mtilocca/mppt-controller/hardware/erc_report.txt

ERC report (2026-11-07T15:33:20, Encoding UTF8)
Report includes: Errors, Warnings, Exclusions

***** Sheet /

***** Sheet /pv_input/

***** Sheet /mppt_stage/

***** Sheet /mppt_loop/

***** Sheet /battery/

***** Sheet /load_switch/

***** Sheet /inverter_feed/

***** Sheet /sensing/

***** Sheet /aux_power/

***** Sheet /mcu/

***** Sheet /flash/

***** Sheet /ethernet/

***** Sheet /can/

***** Sheet /rs485/

***** Sheet /usb_uart/

***** Sheet /display/

***** Sheet /leds/

 ** ERC messages: 0  Errors 0  Warnings 0

 ** Ignored checks:
    - Global label only appears once in the schematic
    - Four connection points are joined together
    - SPICE model issue
    - Assigned footprint doesn't match footprint filters
