mtilocca/mppt-controller/docs/03-pinmap.md

# 3. STM32H743ZIT6 pin map (LQFP-144)

Generated by `hardware/gen_pinmap_doc.py` from `hardware/pinmap.json` (made by `pinmap.py`). Every alternate function was matched against
ST's open pin data for STM32H743ZITx (`h743zit_af.json`); the generator asserts it again at build time. Not used: PA13/PA14 (SWD), PH0/PH1 (HSE), PC14/PC15 (LSE), PA11/PA12 (USB).

Active-low control nets (reset/boot state = pin high-Z with a pull-up = everything OFF): `MPPT_NEN`, `LOAD_NEN`, `INV_NEN`.

## QSPI

| Signal | Pin | LQFP-144 | Function |
|---|---|---|---|
| QSPI_CLK | PF10 | 22 | QUADSPI_CLK |
| QSPI_NCS | PG6 | 91 | QUADSPI_BK1_NCS |
| QSPI_IO0 | PF8 | 20 | QUADSPI_BK1_IO0 |
| QSPI_IO1 | PF9 | 21 | QUADSPI_BK1_IO1 |
| QSPI_IO2 | PE2 | 1 | QUADSPI_BK1_IO2 |
| QSPI_IO3 | PF6 | 18 | QUADSPI_BK1_IO3 |

## ETH

| Signal | Pin | LQFP-144 | Function |
|---|---|---|---|
| ETH_REF_CLK | PA1 | 35 | ETH_REF_CLK |
| ETH_MDIO | PA2 | 36 | ETH_MDIO |
| ETH_MDC | PC1 | 27 | ETH_MDC |
| ETH_CRS_DV | PA7 | 43 | ETH_CRS_DV |
| ETH_RXD0 | PC4 | 44 | ETH_RXD0 |
| ETH_RXD1 | PC5 | 45 | ETH_RXD1 |
| ETH_TX_EN | PG11 | 126 | ETH_TX_EN |
| ETH_TXD0 | PG13 | 128 | ETH_TXD0 |
| ETH_TXD1 | PG12 | 127 | ETH_TXD1 |
| ETH_NRST | PC9 | 99 | GPIO |

## USB

| Signal | Pin | LQFP-144 | Function |
|---|---|---|---|
| USB_DM | PA11 | 103 | USB_OTG_FS_DM |
| USB_DP | PA12 | 104 | USB_OTG_FS_DP |
| USB_VBUS | PE1 | 142 | GPIO |

## LCD

| Signal | Pin | LQFP-144 | Function |
|---|---|---|---|
| LCD_R3 | PB0 | 46 | LTDC_R3 |
| LCD_R4 | PA5 | 41 | LTDC_R4 |
| LCD_R5 | PC0 | 26 | LTDC_R5 |
| LCD_R6 | PB1 | 47 | LTDC_R6 |
| LCD_R7 | PE15 | 68 | LTDC_R7 |
| LCD_G2 | PA6 | 42 | LTDC_G2 |
| LCD_G3 | PE11 | 64 | LTDC_G3 |
| LCD_G4 | PB10 | 69 | LTDC_G4 |
| LCD_G5 | PB11 | 70 | LTDC_G5 |
| LCD_G6 | PC7 | 97 | LTDC_G6 |
| LCD_G7 | PD3 | 117 | LTDC_G7 |
| LCD_B3 | PD10 | 79 | LTDC_B3 |
| LCD_B4 | PE12 | 65 | LTDC_B4 |
| LCD_B5 | PA3 | 37 | LTDC_B5 |
| LCD_B6 | PB8 | 139 | LTDC_B6 |
| LCD_B7 | PB9 | 140 | LTDC_B7 |
| LCD_CLK | PE14 | 67 | LTDC_CLK |
| LCD_HSYNC | PC6 | 96 | LTDC_HSYNC |
| LCD_VSYNC | PA4 | 40 | LTDC_VSYNC |
| LCD_DE | PE13 | 66 | LTDC_DE |
| LCD_BL_PWM | PD15 | 86 | TIM4_CH4 |
| LCD_RST | PC8 | 98 | GPIO |

## CAN

| Signal | Pin | LQFP-144 | Function |
|---|---|---|---|
| CAN_TX | PD1 | 115 | FDCAN1_TX |
| CAN_RX | PD0 | 114 | FDCAN1_RX |

## RS485

| Signal | Pin | LQFP-144 | Function |
|---|---|---|---|
| RS485_TX | PG14 | 129 | USART6_TX |
| RS485_RX | PG9 | 124 | USART6_RX |
| RS485_DE | PG8 | 93 | USART6_DE |
| RS485_NRE | PA0 | 34 | GPIO |

## CON

| Signal | Pin | LQFP-144 | Function |
|---|---|---|---|
| CON_TX | PD8 | 77 | USART3_TX |
| CON_RX | PD9 | 78 | USART3_RX |

## I2C

| Signal | Pin | LQFP-144 | Function |
|---|---|---|---|
| I2C_SCL | PB6 | 136 | I2C1_SCL |
| I2C_SDA | PB7 | 137 | I2C1_SDA |

## SPI

| Signal | Pin | LQFP-144 | Function |
|---|---|---|---|
| SPI_SCK | PB13 | 74 | SPI2_SCK |
| SPI_MOSI | PB15 | 76 | SPI2_MOSI |
| SPI_MISO | PB14 | 75 | SPI2_MISO |
| SPI_CS | PB2 | 48 | GPIO |
| SPI_DC | PA10 | 102 | GPIO |
| SPI_RST | PA9 | 101 | GPIO |

## ADC

| Signal | Pin | LQFP-144 | Function |
|---|---|---|---|
| ADC_VPV | PF11 | 49 | ADC1_INP2 |
| ADC_VBAT | PF4 | 14 | ADC3_INP9 |
| ADC_VLOAD | PF5 | 15 | ADC3_INP4 |
| ADC_NTC_PWR | PF12 | 50 | ADC1_INP6 |
| ADC_NTC_BAT | PF3 | 13 | ADC3_INP5 |
| ADC_NTC_AUX | PF7 | 19 | ADC3_INP3 |

## CONTROL

| Signal | Pin | LQFP-144 | Function |
|---|---|---|---|
| LED1 | PE0 | 141 | GPIO |
| LED2 | PD14 | 85 | GPIO |
| LED3 | PD13 | 82 | GPIO |
| LED4 | PD12 | 81 | GPIO |
| MPPT_EN | PD11 | 80 | GPIO |
| MPPT_FLT | PD7 | 123 | GPIO |
| LOAD_EN | PD6 | 122 | GPIO |
| LOAD_PGD | PD5 | 119 | GPIO |
| INV_EN | PD4 | 118 | GPIO |
| INV_PGD | PD2 | 116 | GPIO |
| INV_REMOTE | PC12 | 113 | GPIO |
| INV_FAULT | PC11 | 112 | GPIO |
| INA_ALERT | PC10 | 111 | GPIO |
| FAN_PWM | PA8 | 100 | GPIO |

## TOUCH

| Signal | Pin | LQFP-144 | Function |
|---|---|---|---|
| TOUCH_INT | PB12 | 73 | GPIO |
| TOUCH_CS | PB5 | 135 | GPIO |
