mtilocca/mppt-controller/docs/img/board-3d-bottom.png

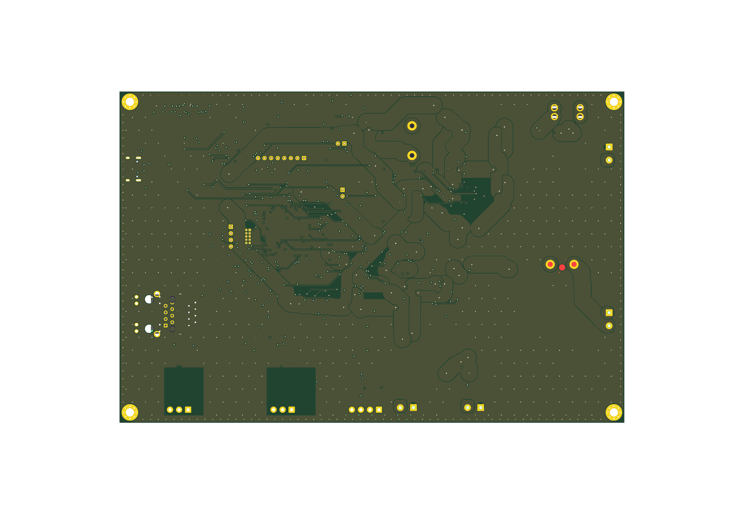
docs/img/board-3d-bottom.png
