mtilocca/mppt-controller/docs/img/board-in2.png

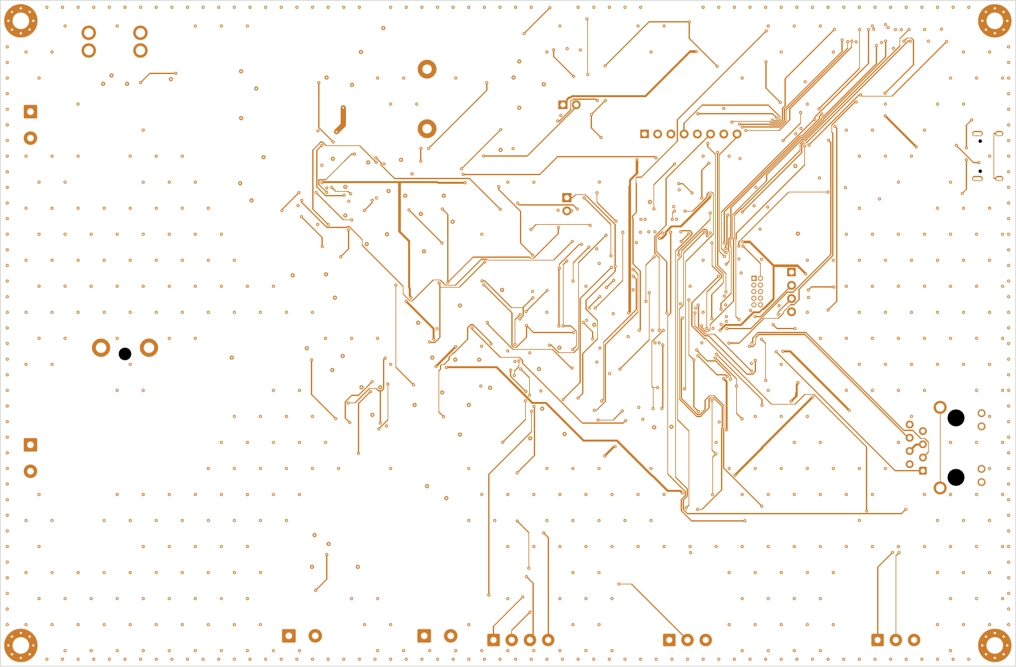
docs/img/board-in2.png
