mtilocca/mppt-controller/docs/img/sch-01.png

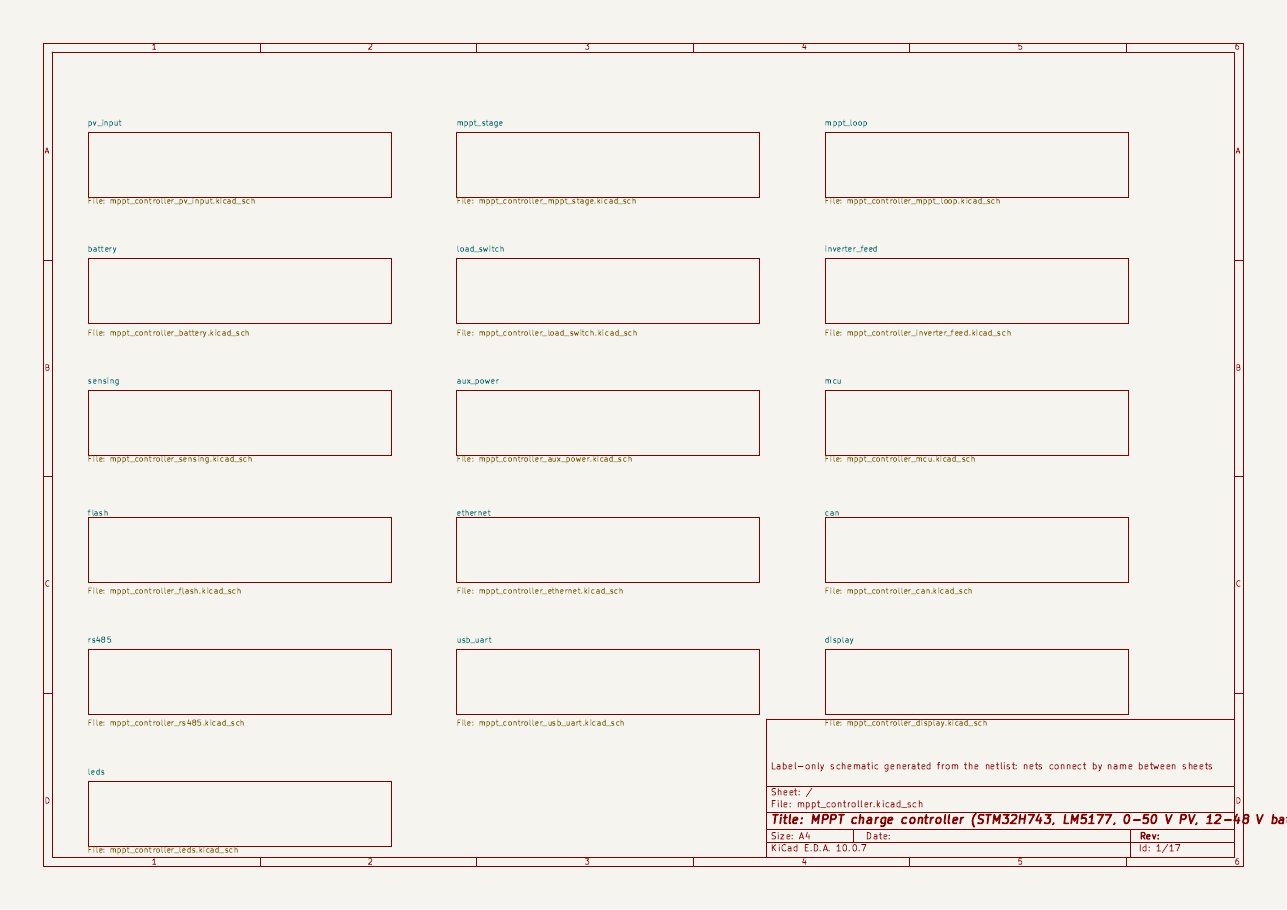
docs/img/sch-01.png
