mtilocca/mppt-controller/docs/img/sch-04.png

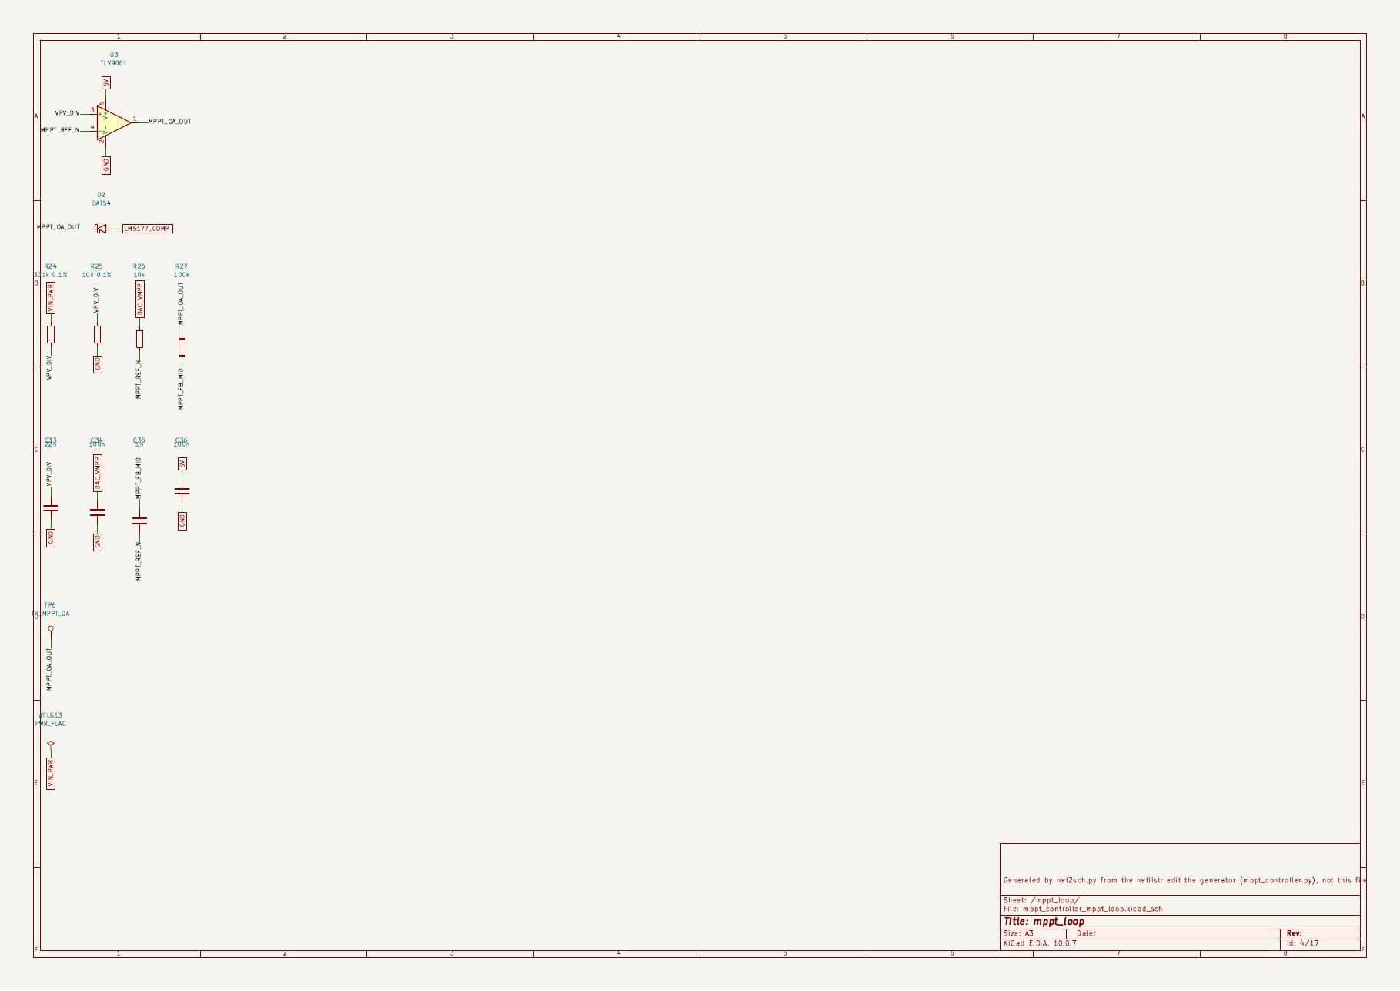
docs/img/sch-04.png
