mtilocca/mppt-controller/docs/img/sch-05.png

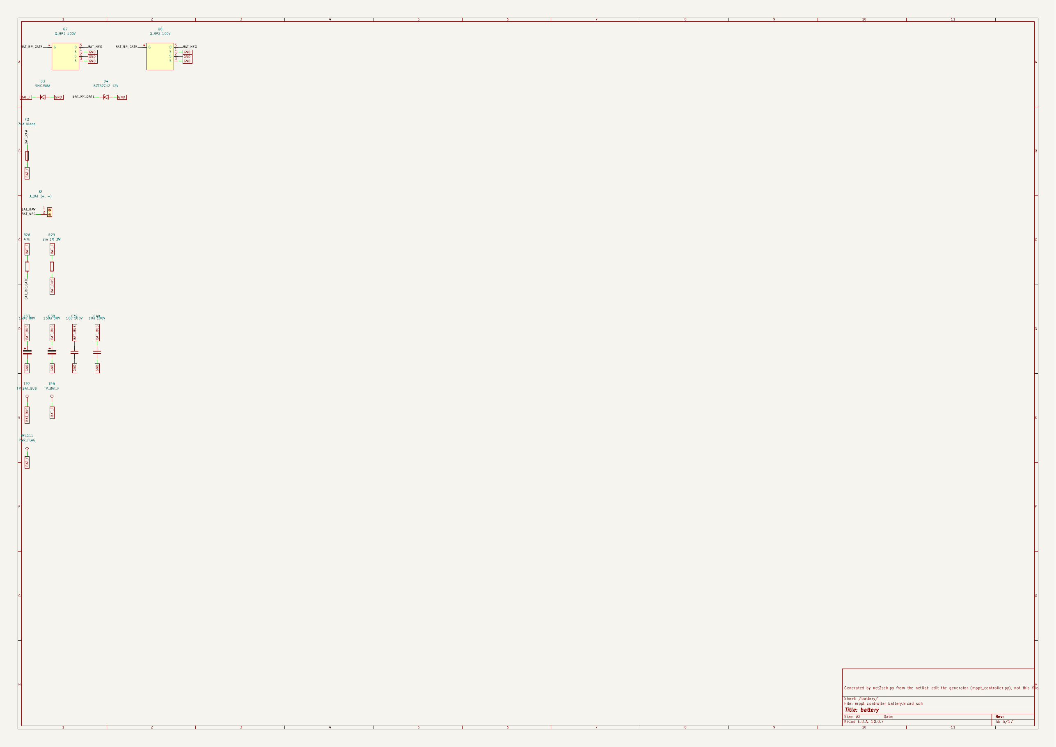
docs/img/sch-05.png
