mtilocca/mppt-controller/docs/img/sch-07.png

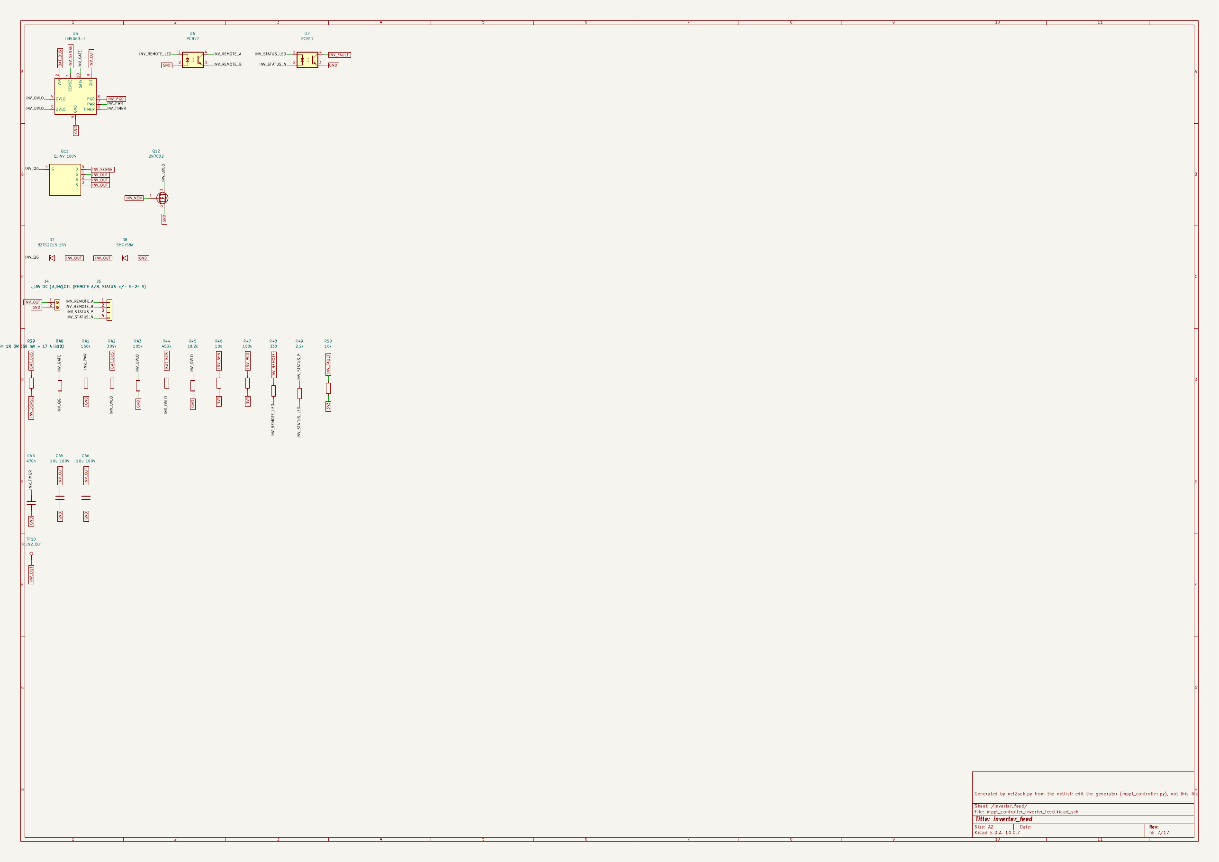
docs/img/sch-07.png
