mtilocca/mppt-controller/docs/img/sch-11.png

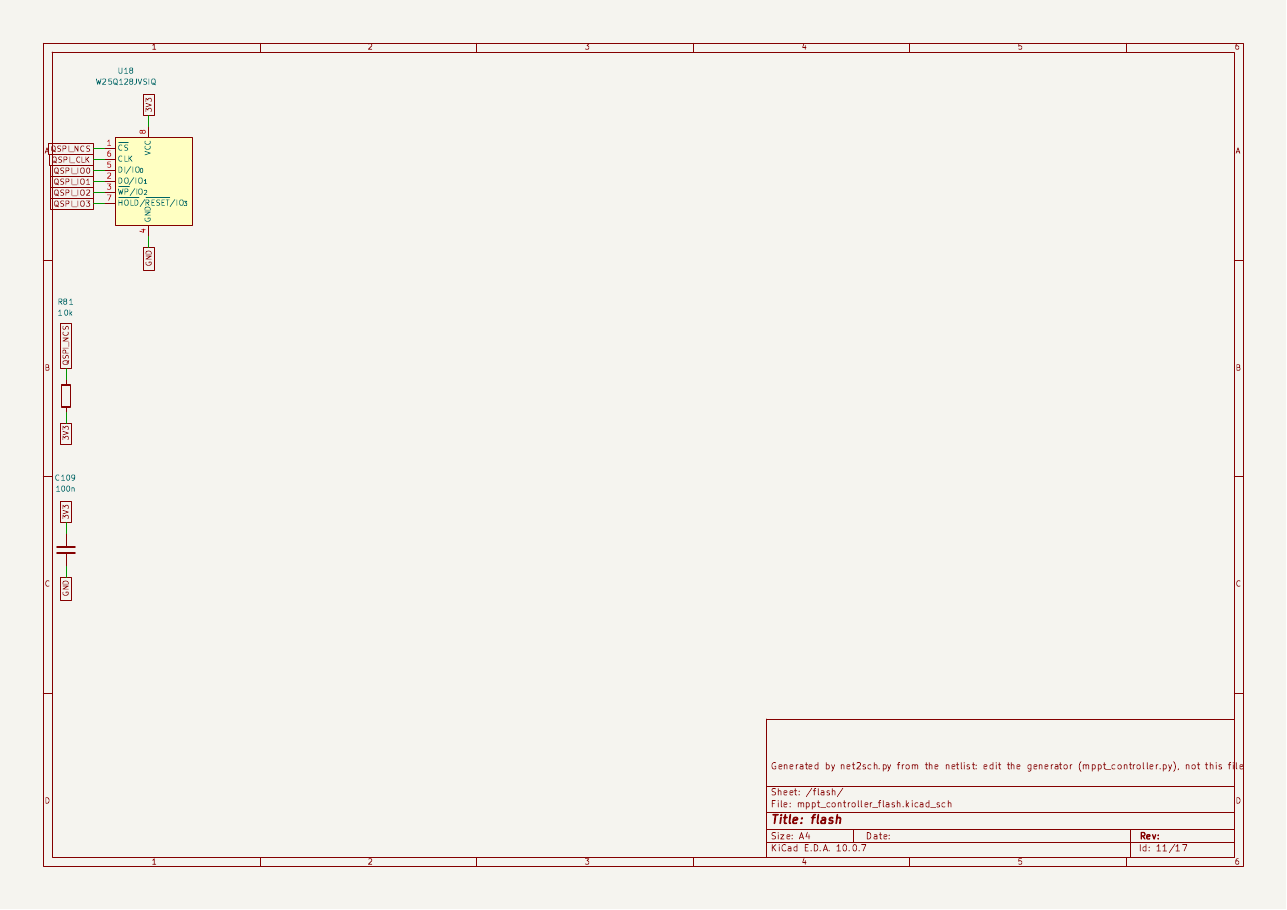
docs/img/sch-11.png
