mtilocca/mppt-controller/docs/img/sch-13.png

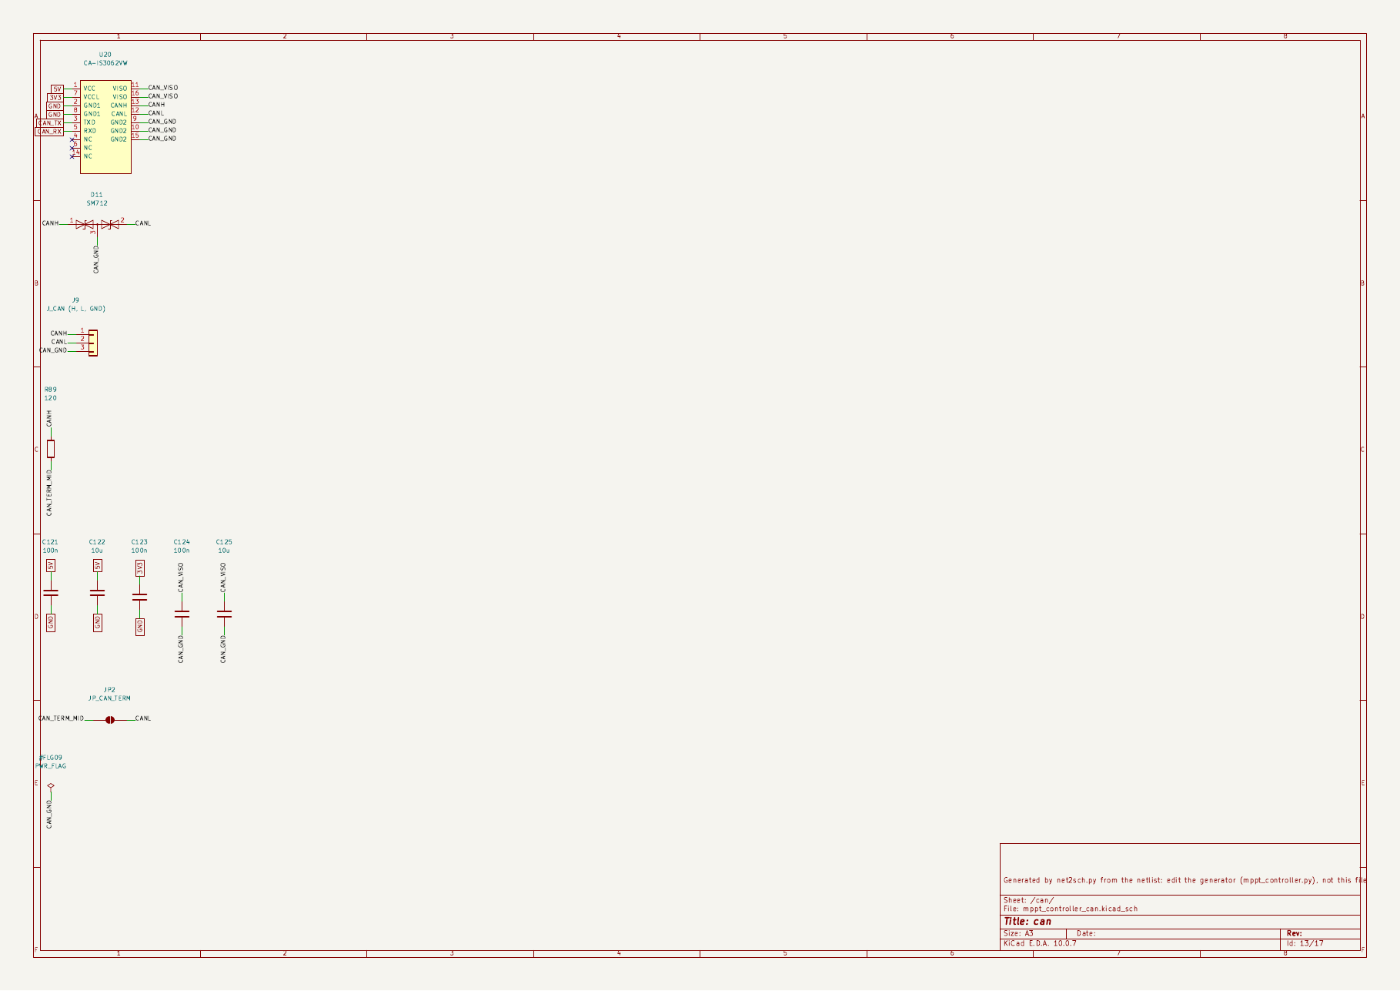
docs/img/sch-13.png
