mtilocca/mppt-controller/docs/img/sch-16.png

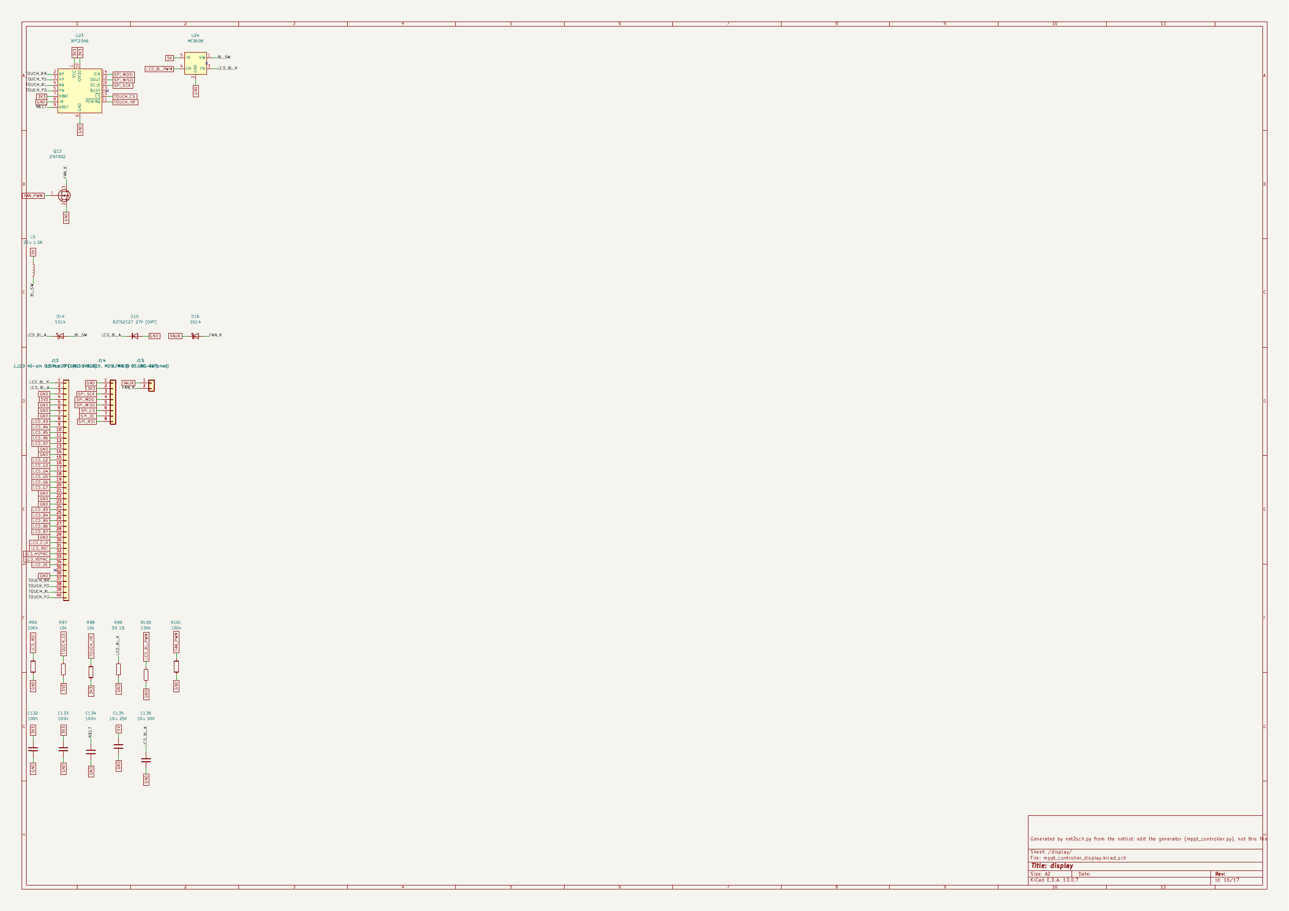
docs/img/sch-16.png
