mtilocca/mppt-controller/hardware/r3d.png

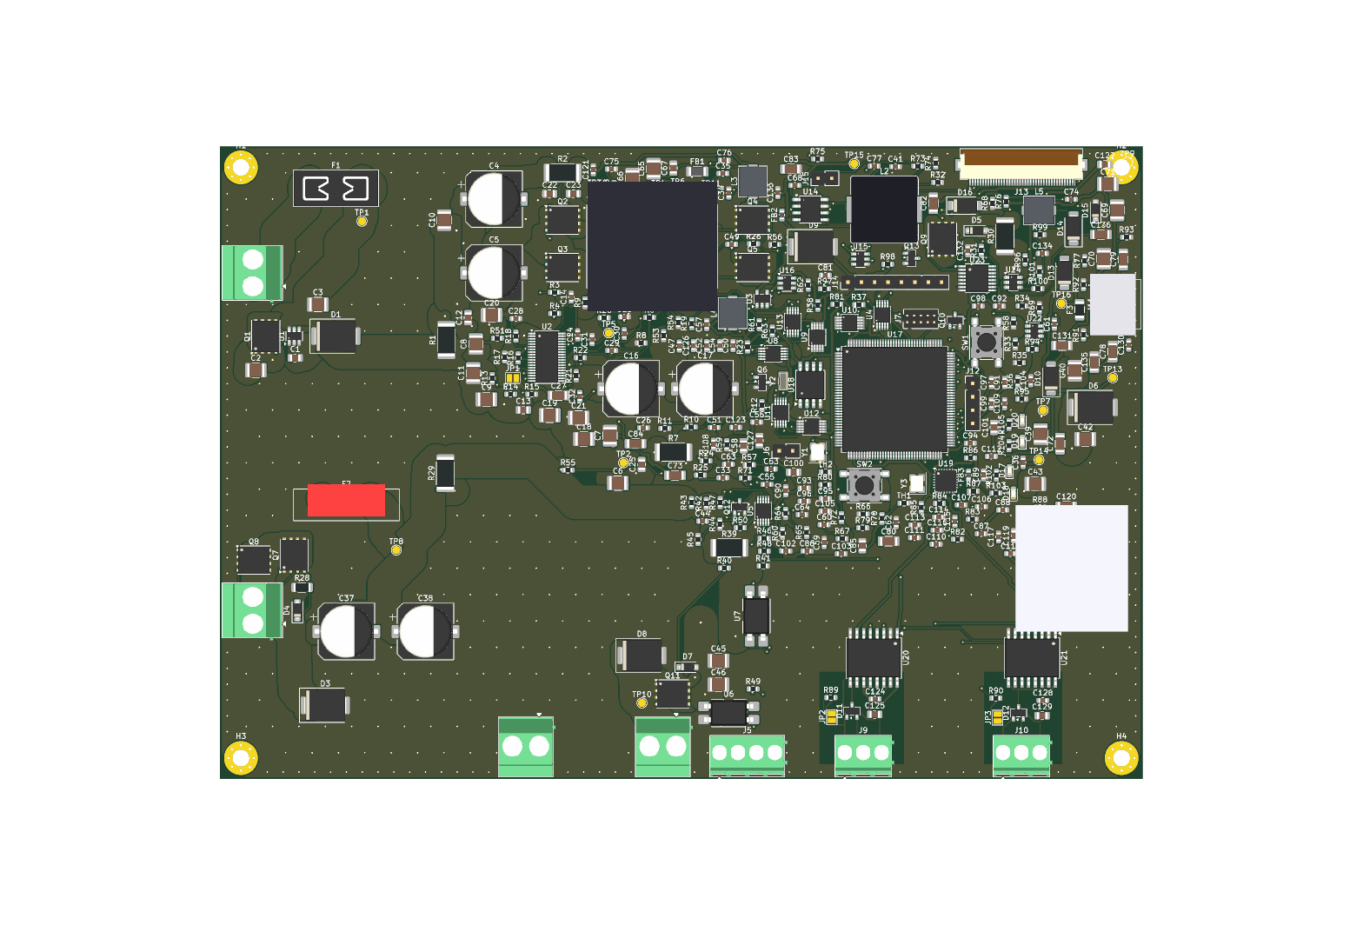
hardware/r3d.png
