mtilocca/mppt-controller/hardware/r3d_iso.png

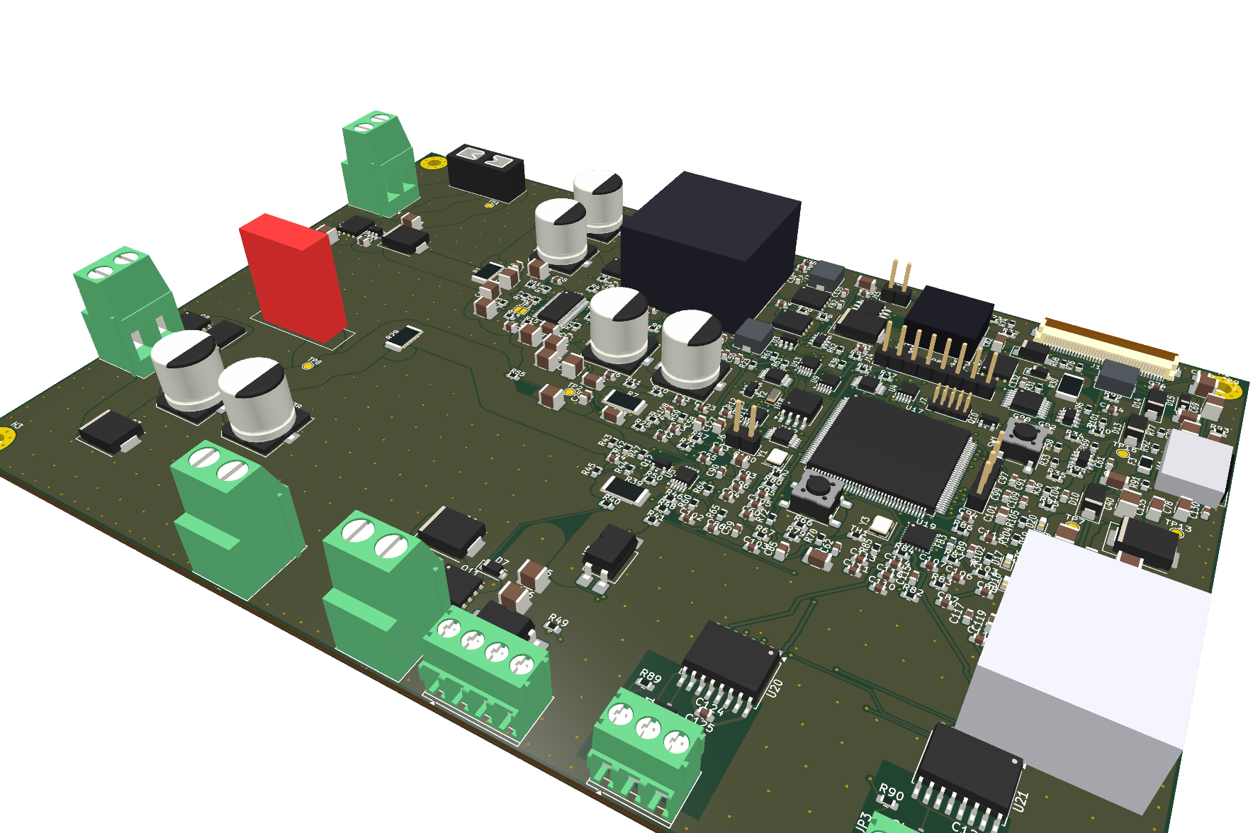
hardware/r3d_iso.png
