mtilocca/mppt-controller/_dl/hr_real.step

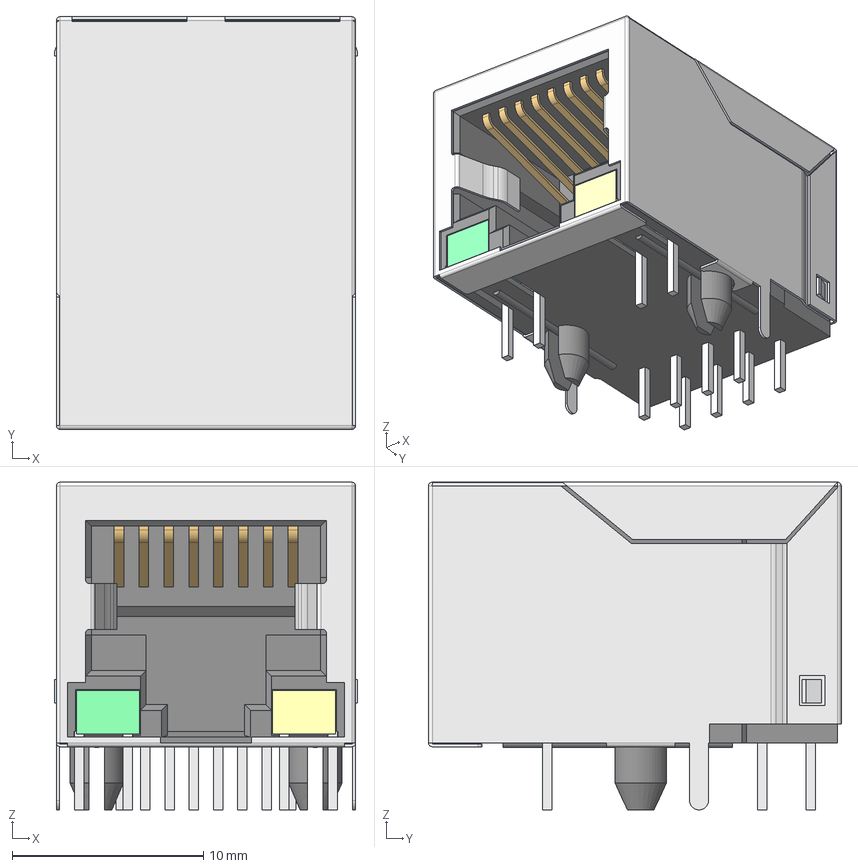
[picture p23: CAD file, 2026-11-08]
_dl/hr_real.step
15.9 x 21.6 x 17.1 mm
