mtilocca/mppt-controller/(list of files, cad)

Other CAD files:
_dl/hr_real.obj
