mtilocca/mppt-controller/docs/img/schematic.pdf

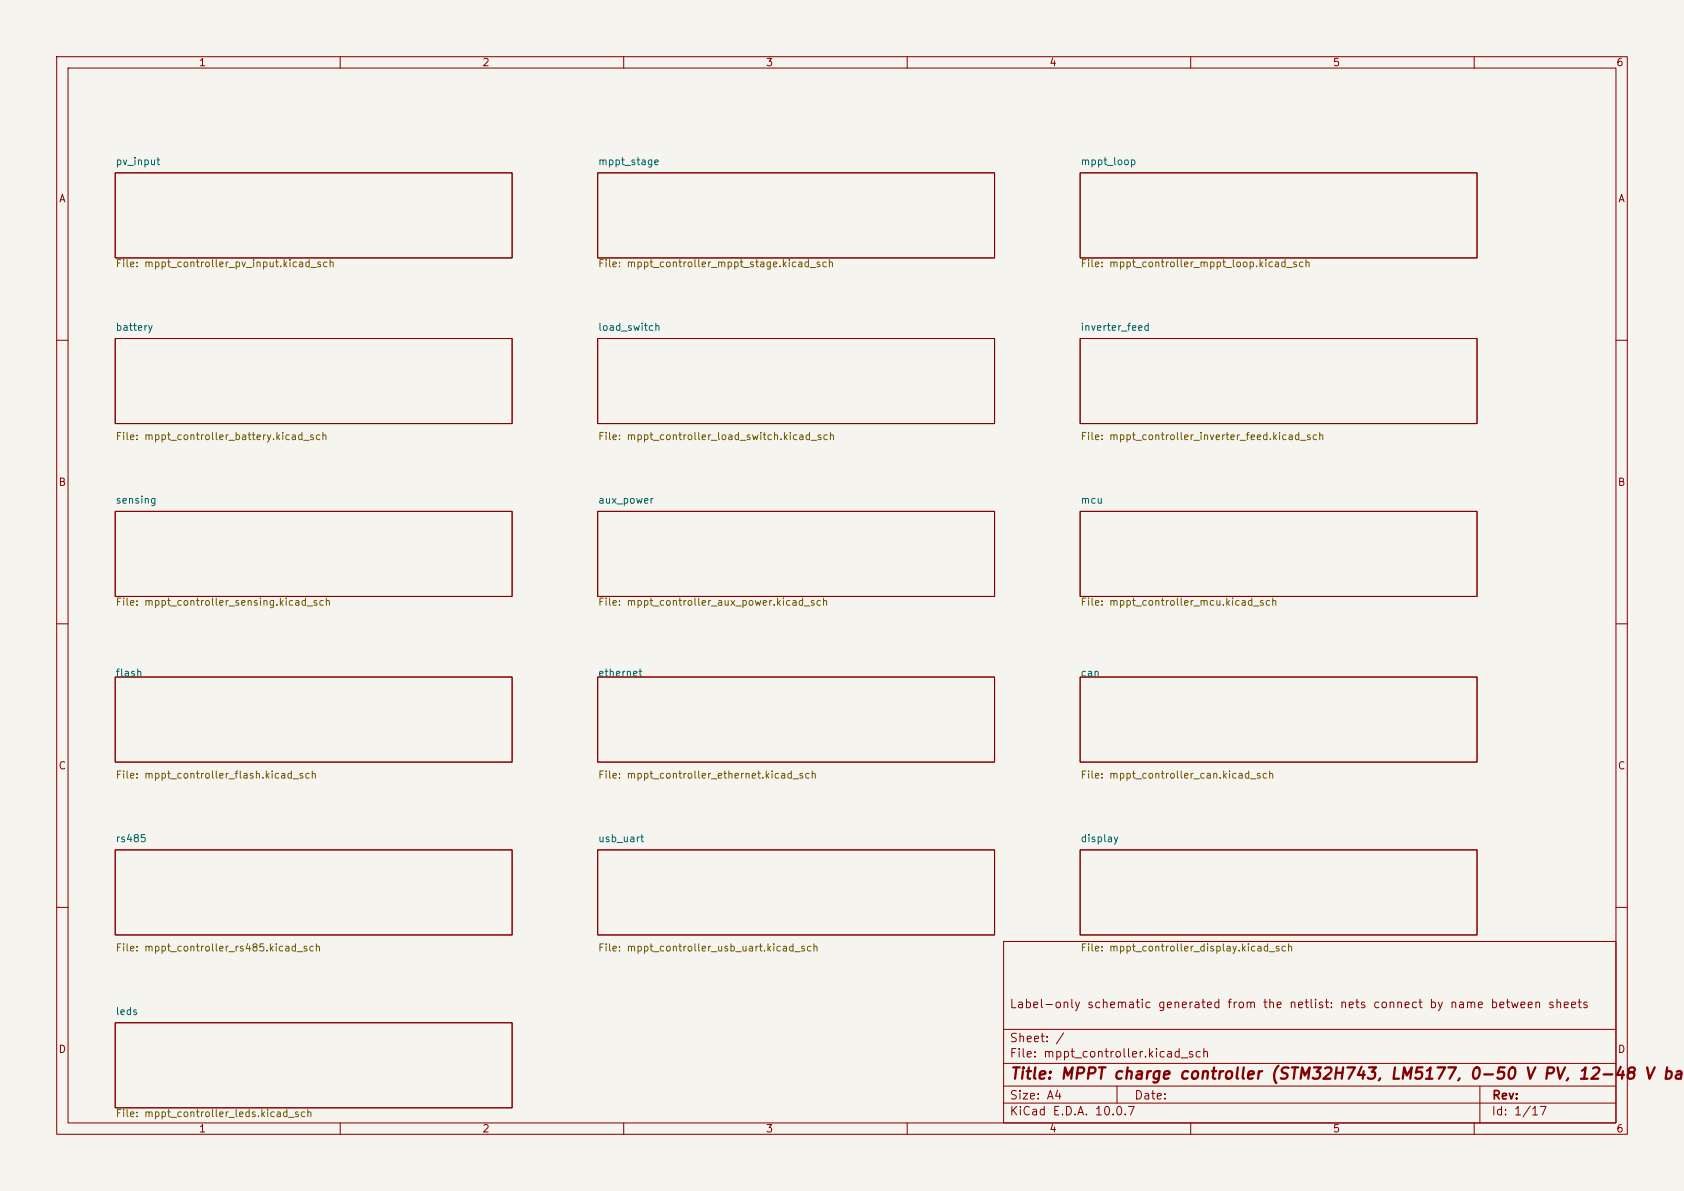
[picture p24: page 1]

Label-only schematic generated from the netlist: nets connect by name between sheets

Sheet: /
File: mppt_controller.kicad_sch
Title: MPPT charge controller (STM32H743, LM5177, 0-50 V PV, 12-48 V battery)

Size: A4 | Rev:
KiCad E.D.A. 10.0.7 | Id: 1/17

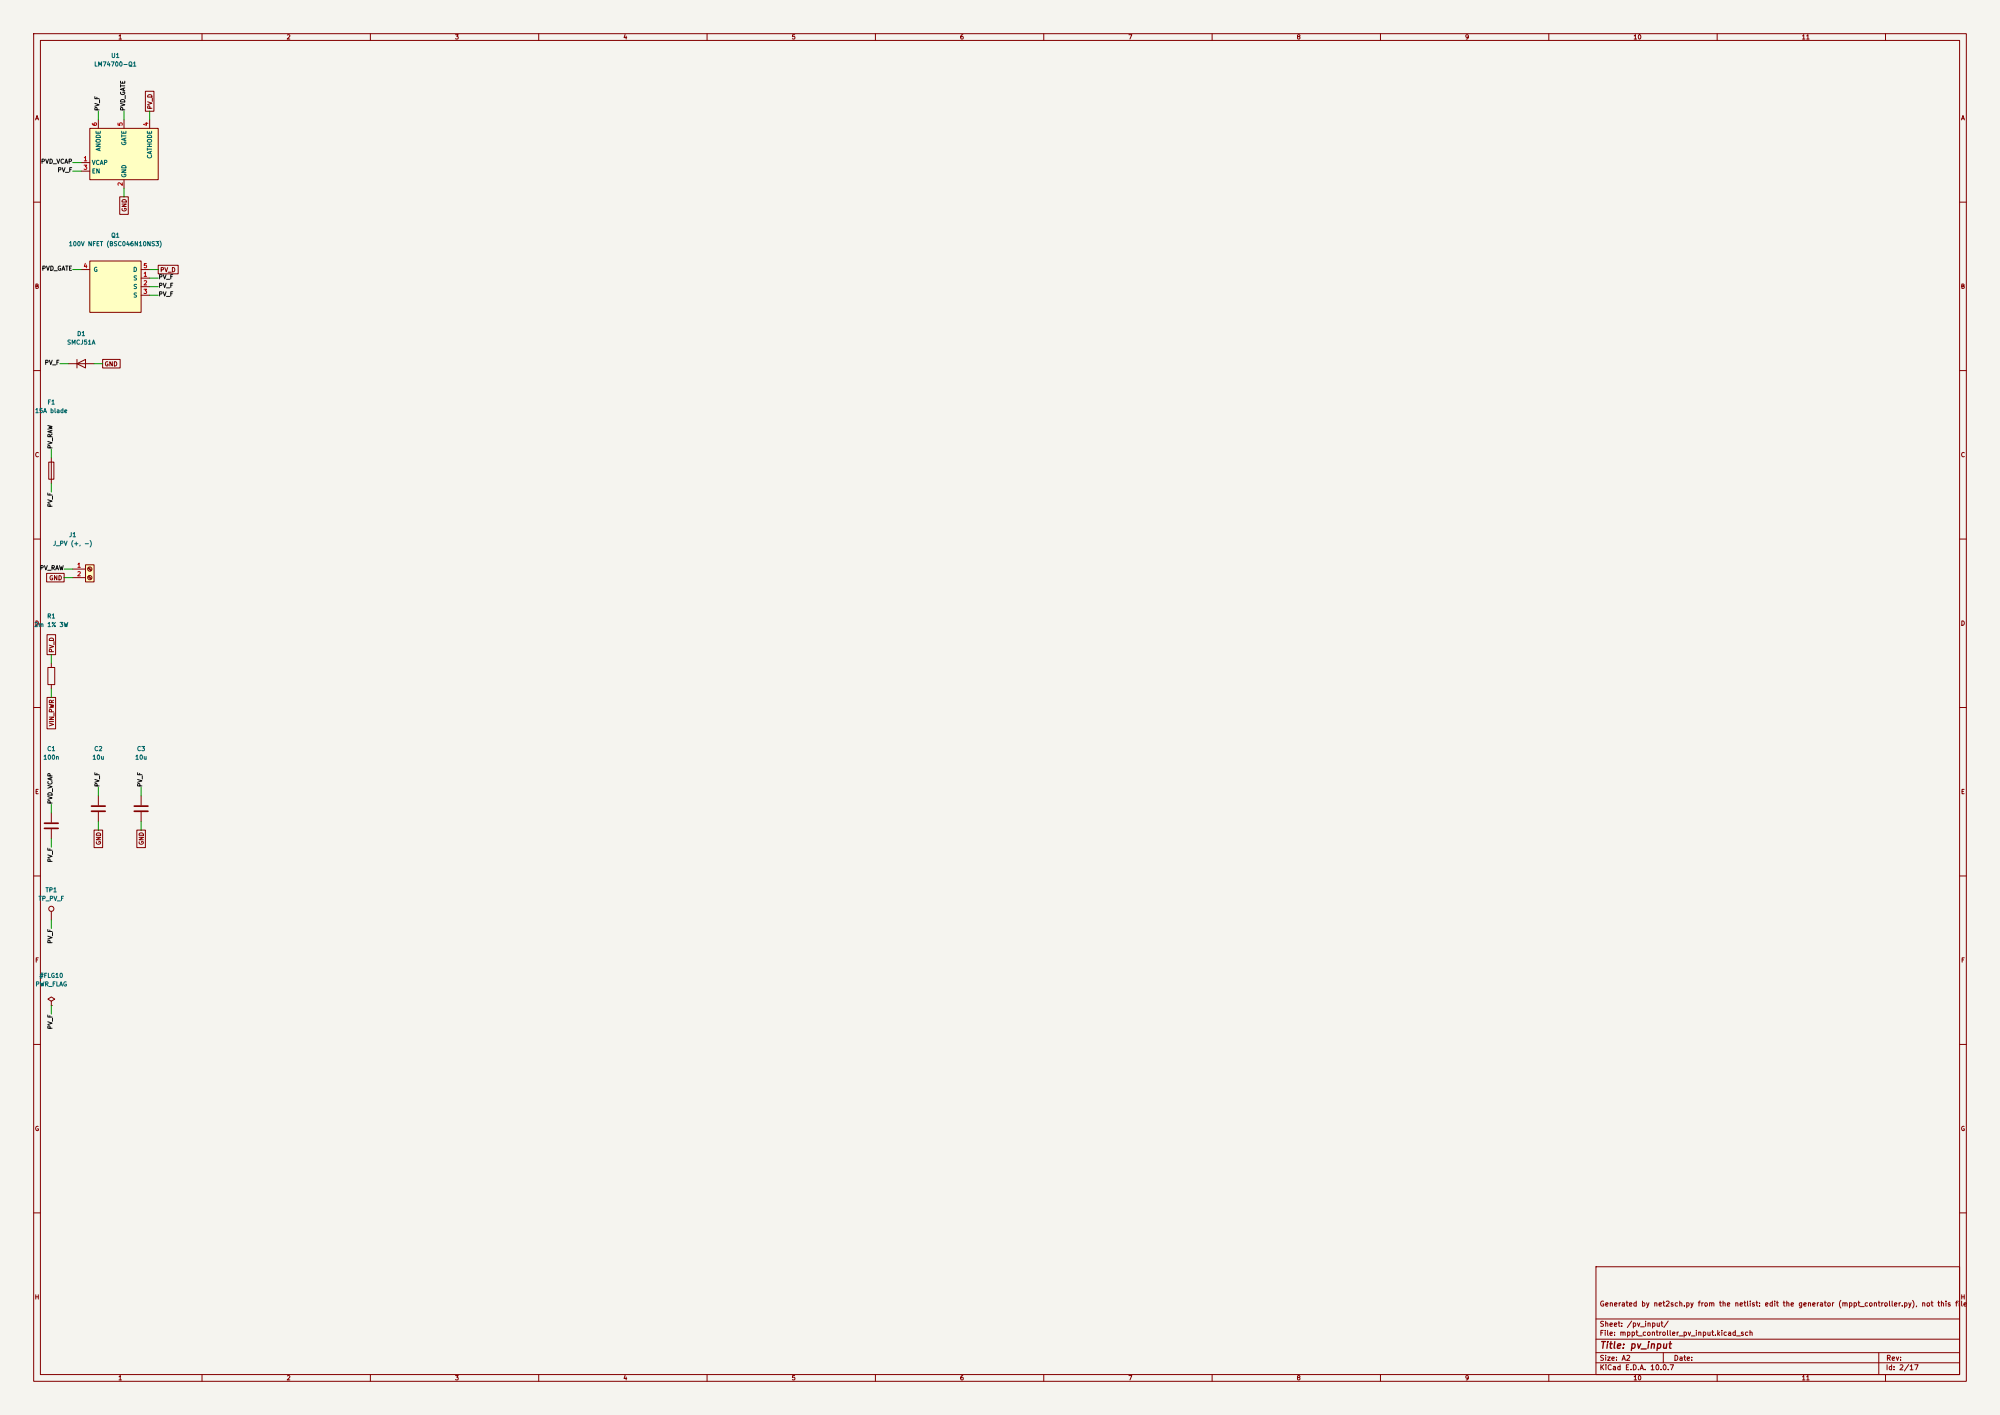
[picture p25: page 2]

Generated by net2sch.py from the netlist: edit the generator (mppt_controller.py), not this file

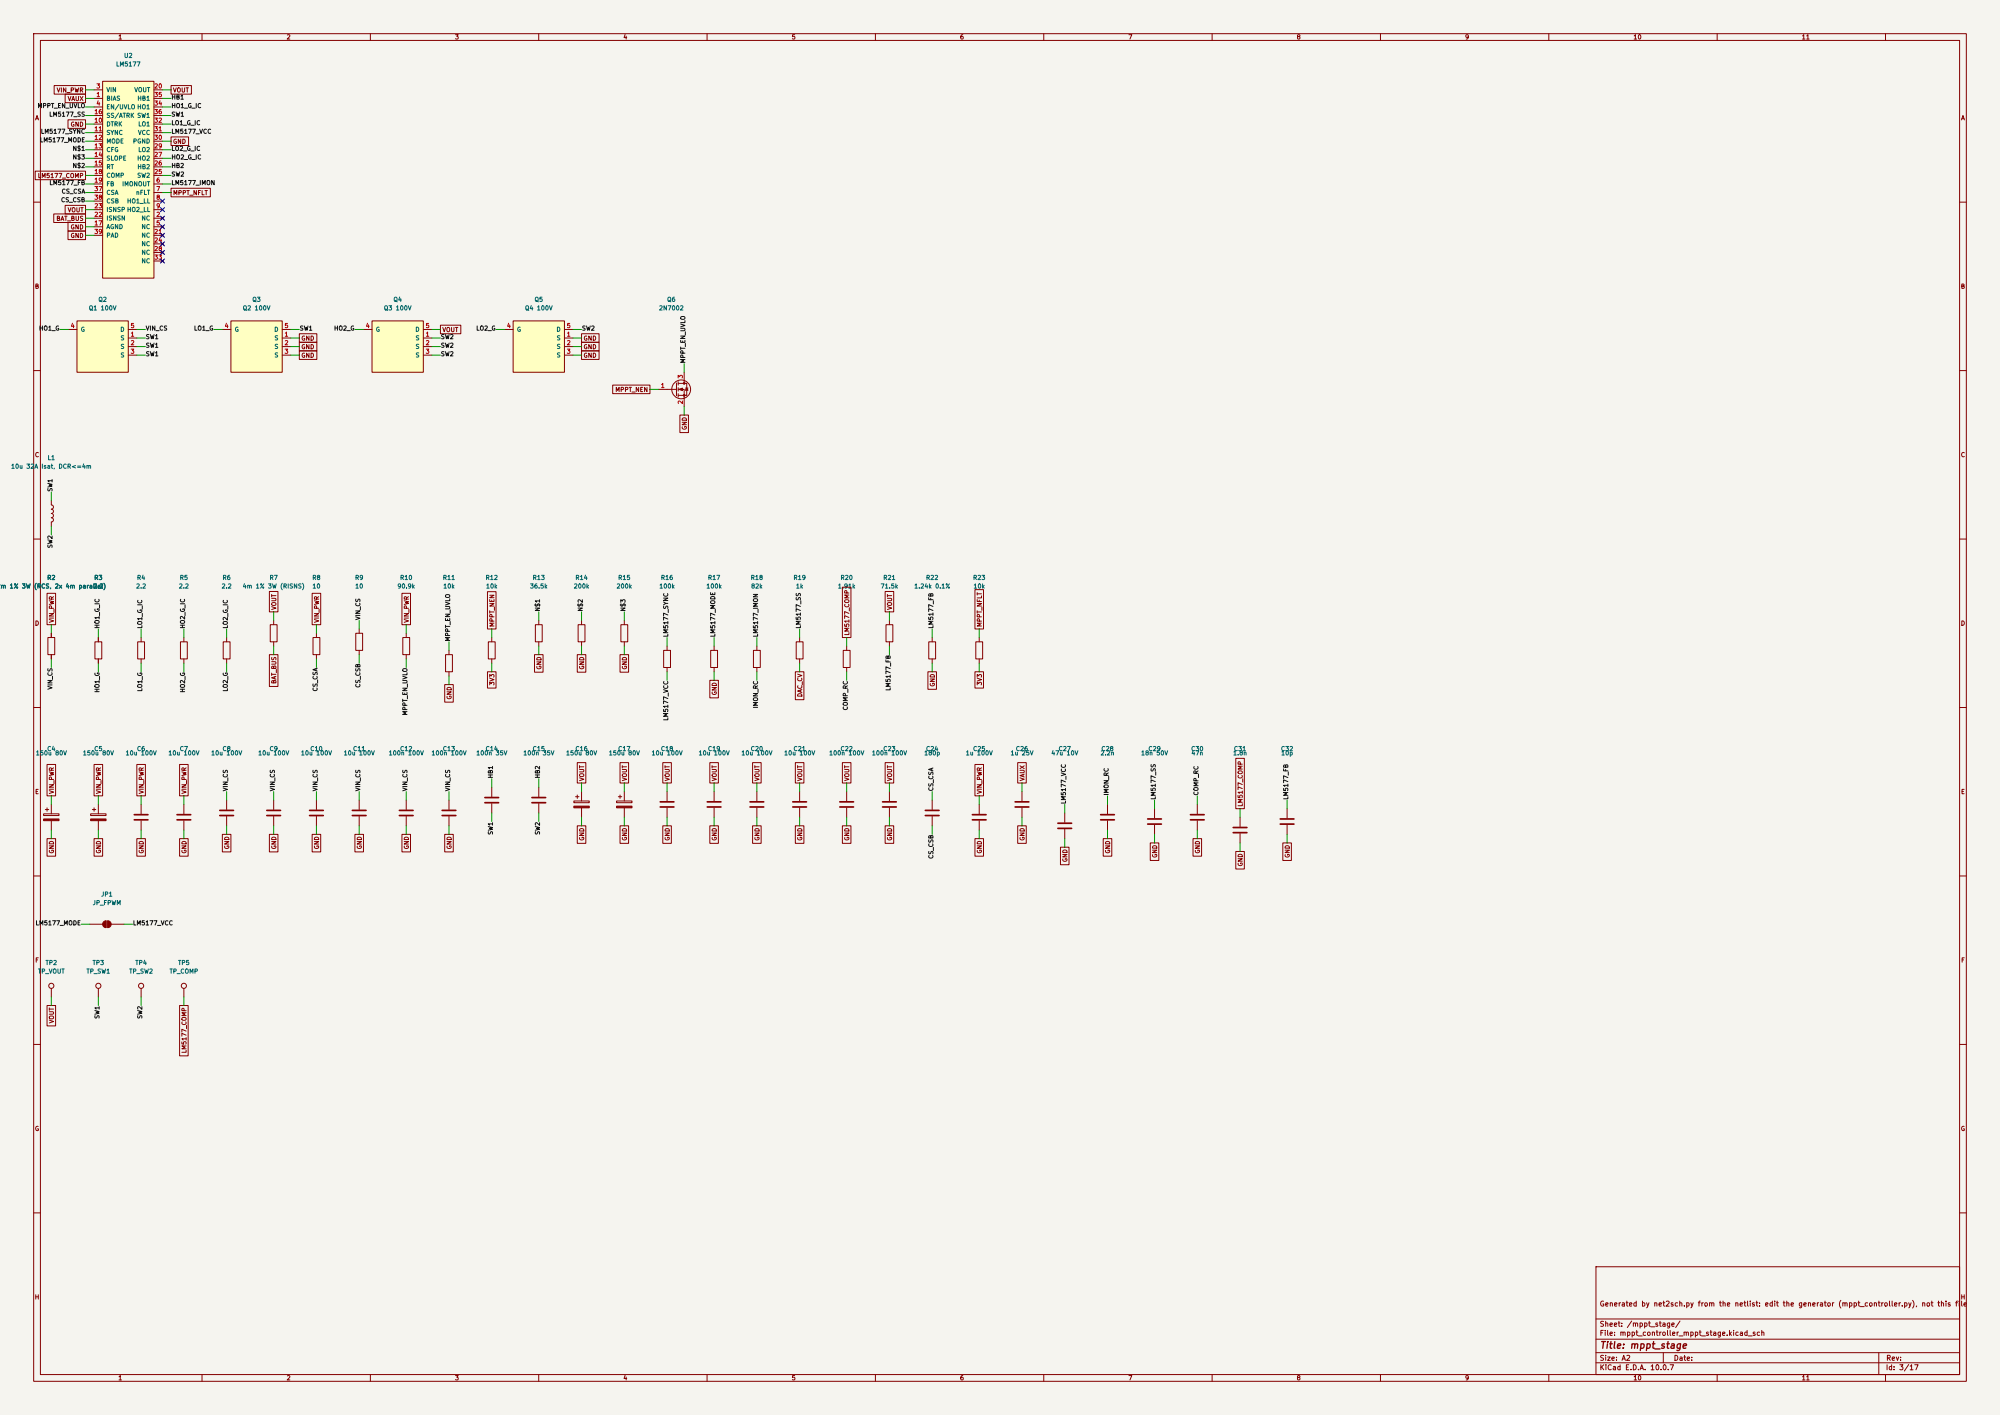
[picture p26: page 3]

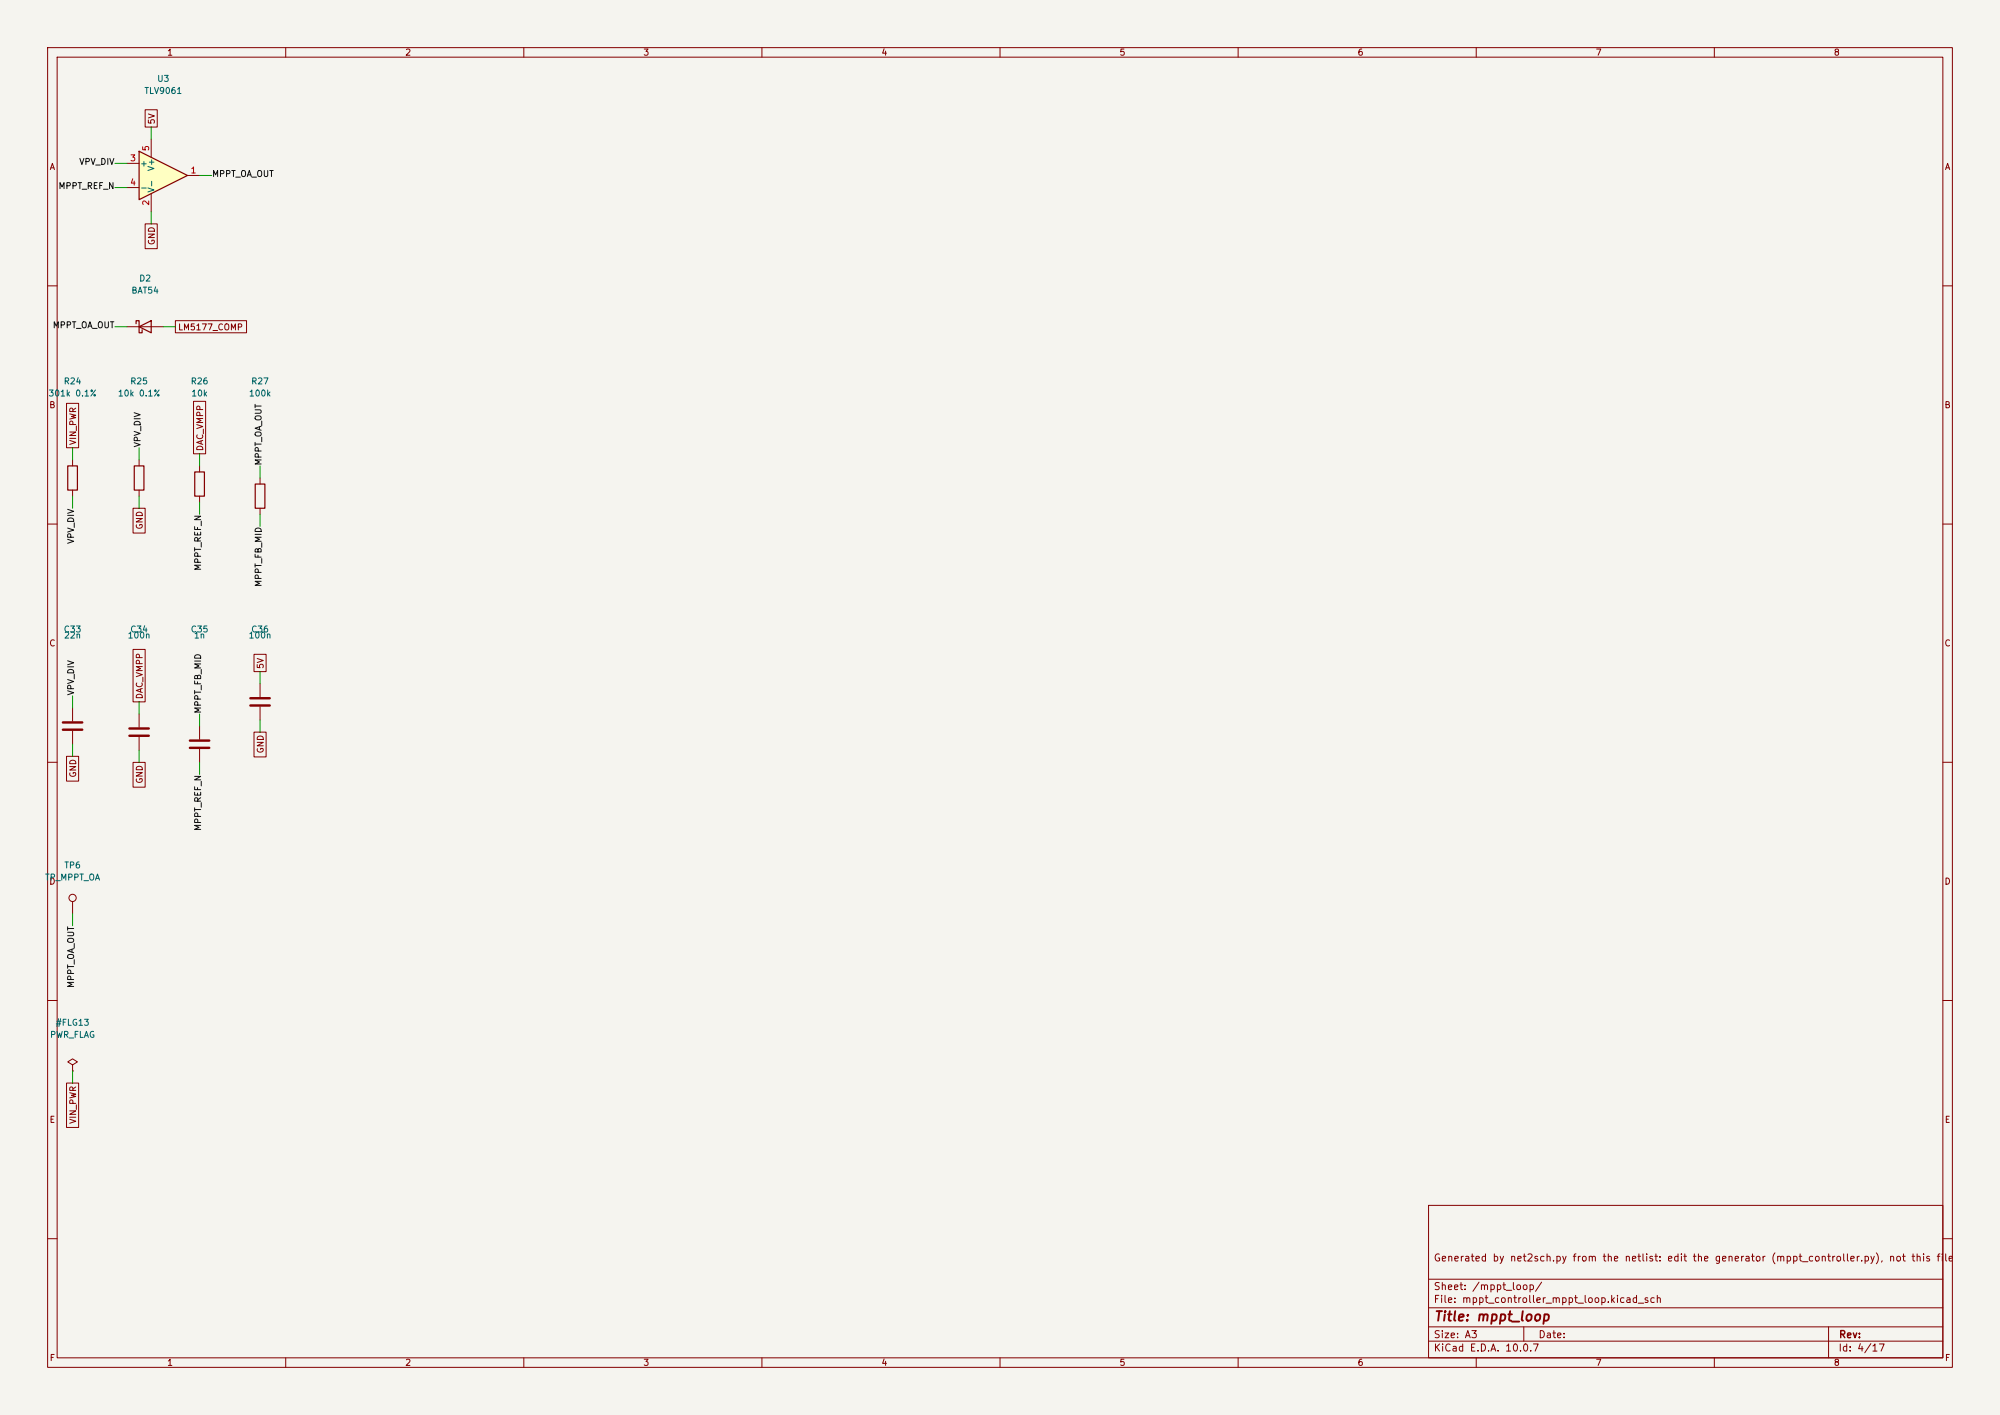
[picture p27: page 4]

Generated by net2sch.py from the netlist: edit the generator (mppt_controller.py), not this file

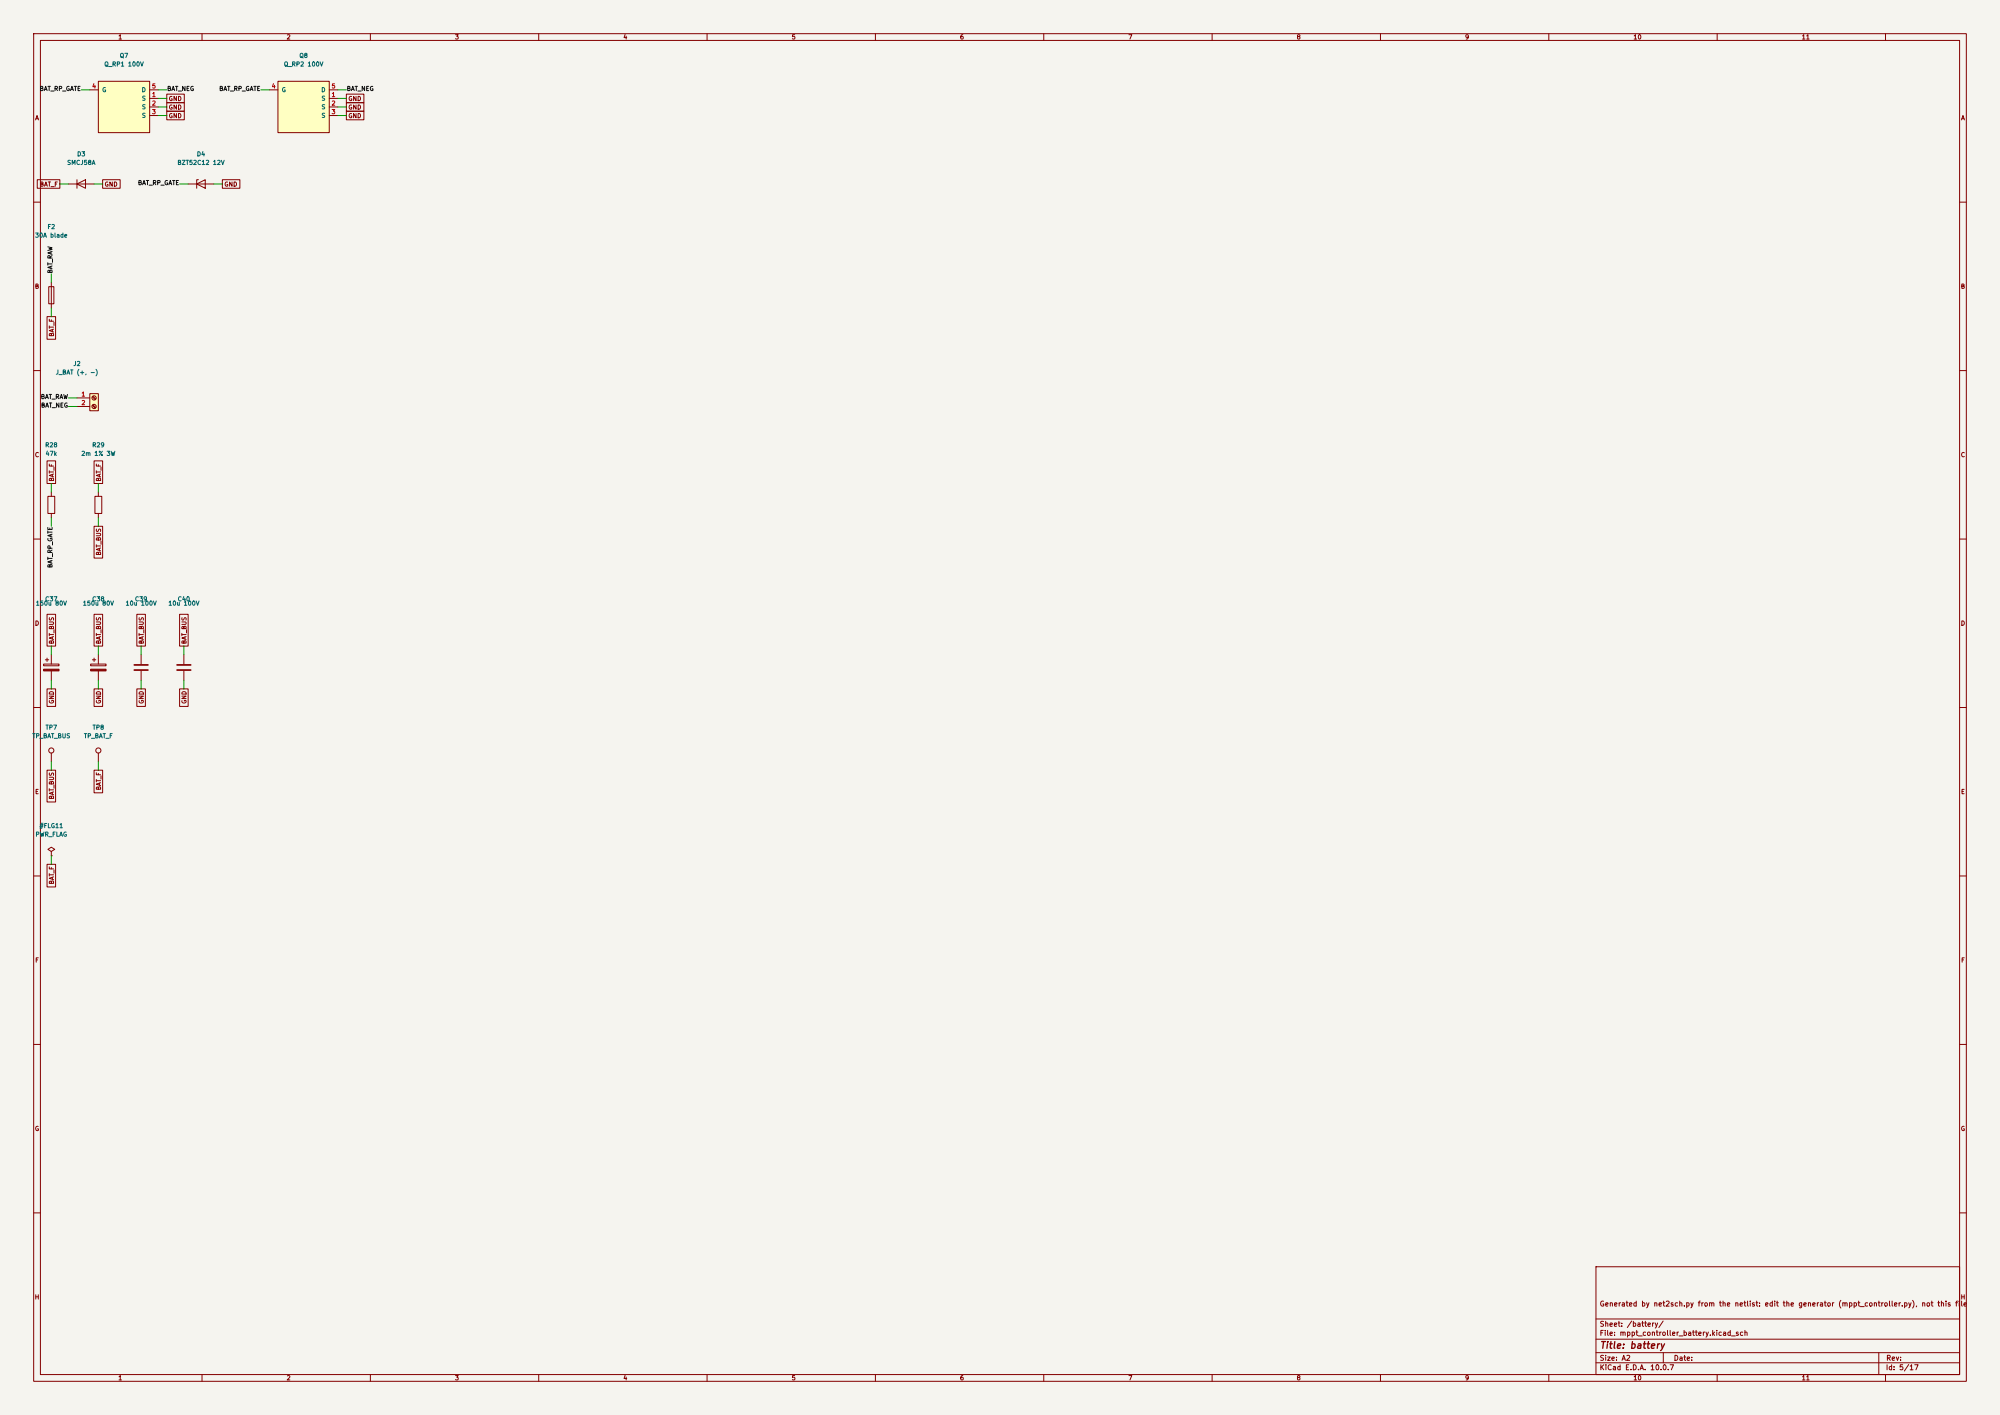
[picture p28: page 5]

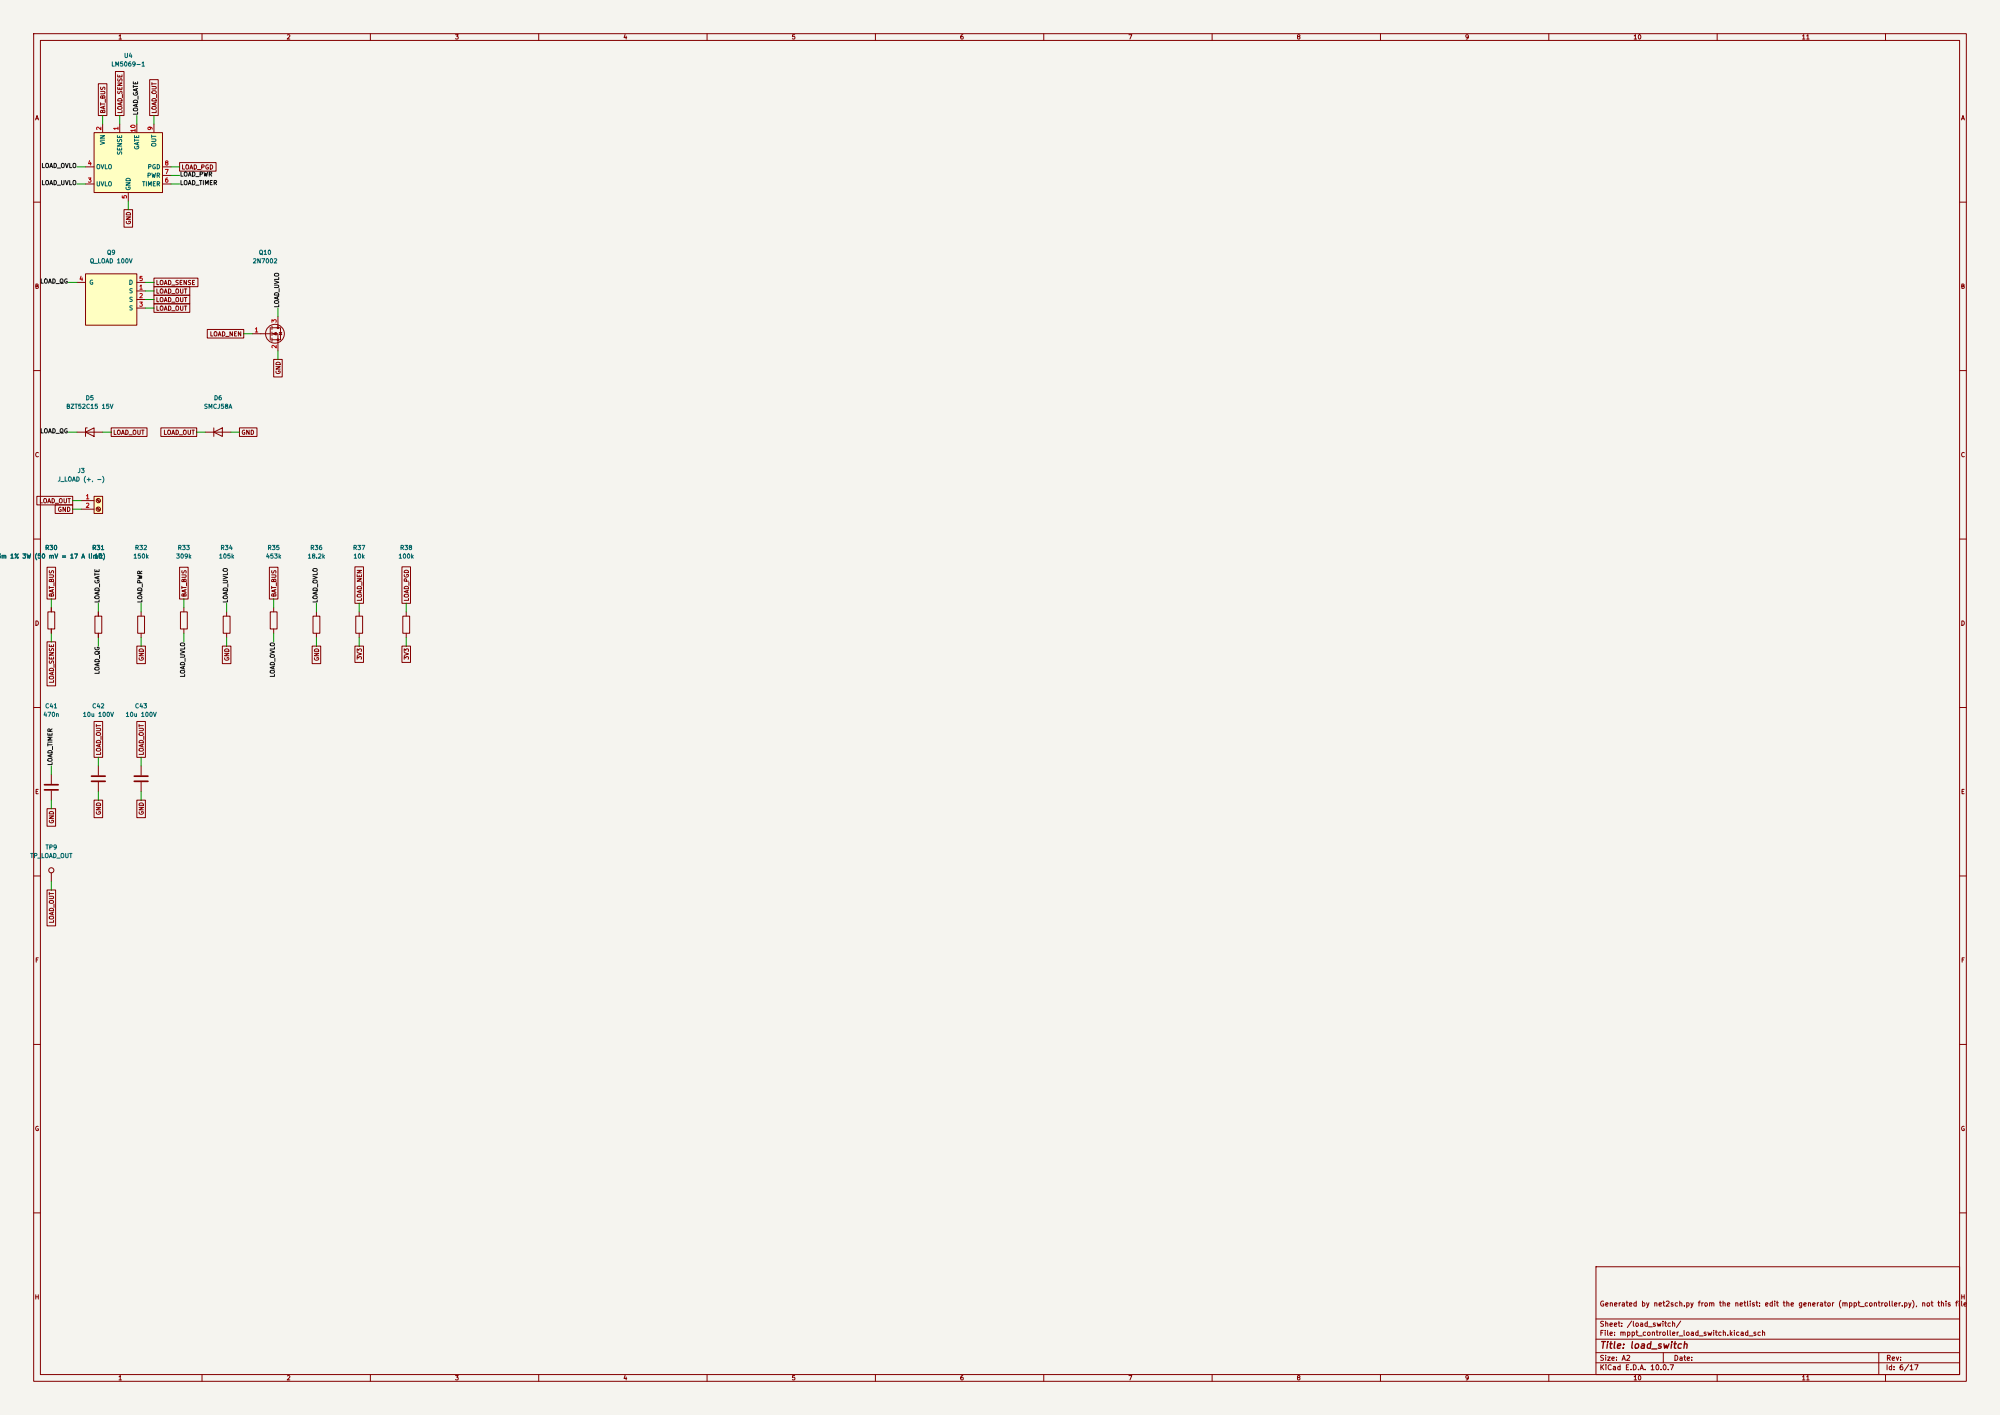
[picture p29: page 6]

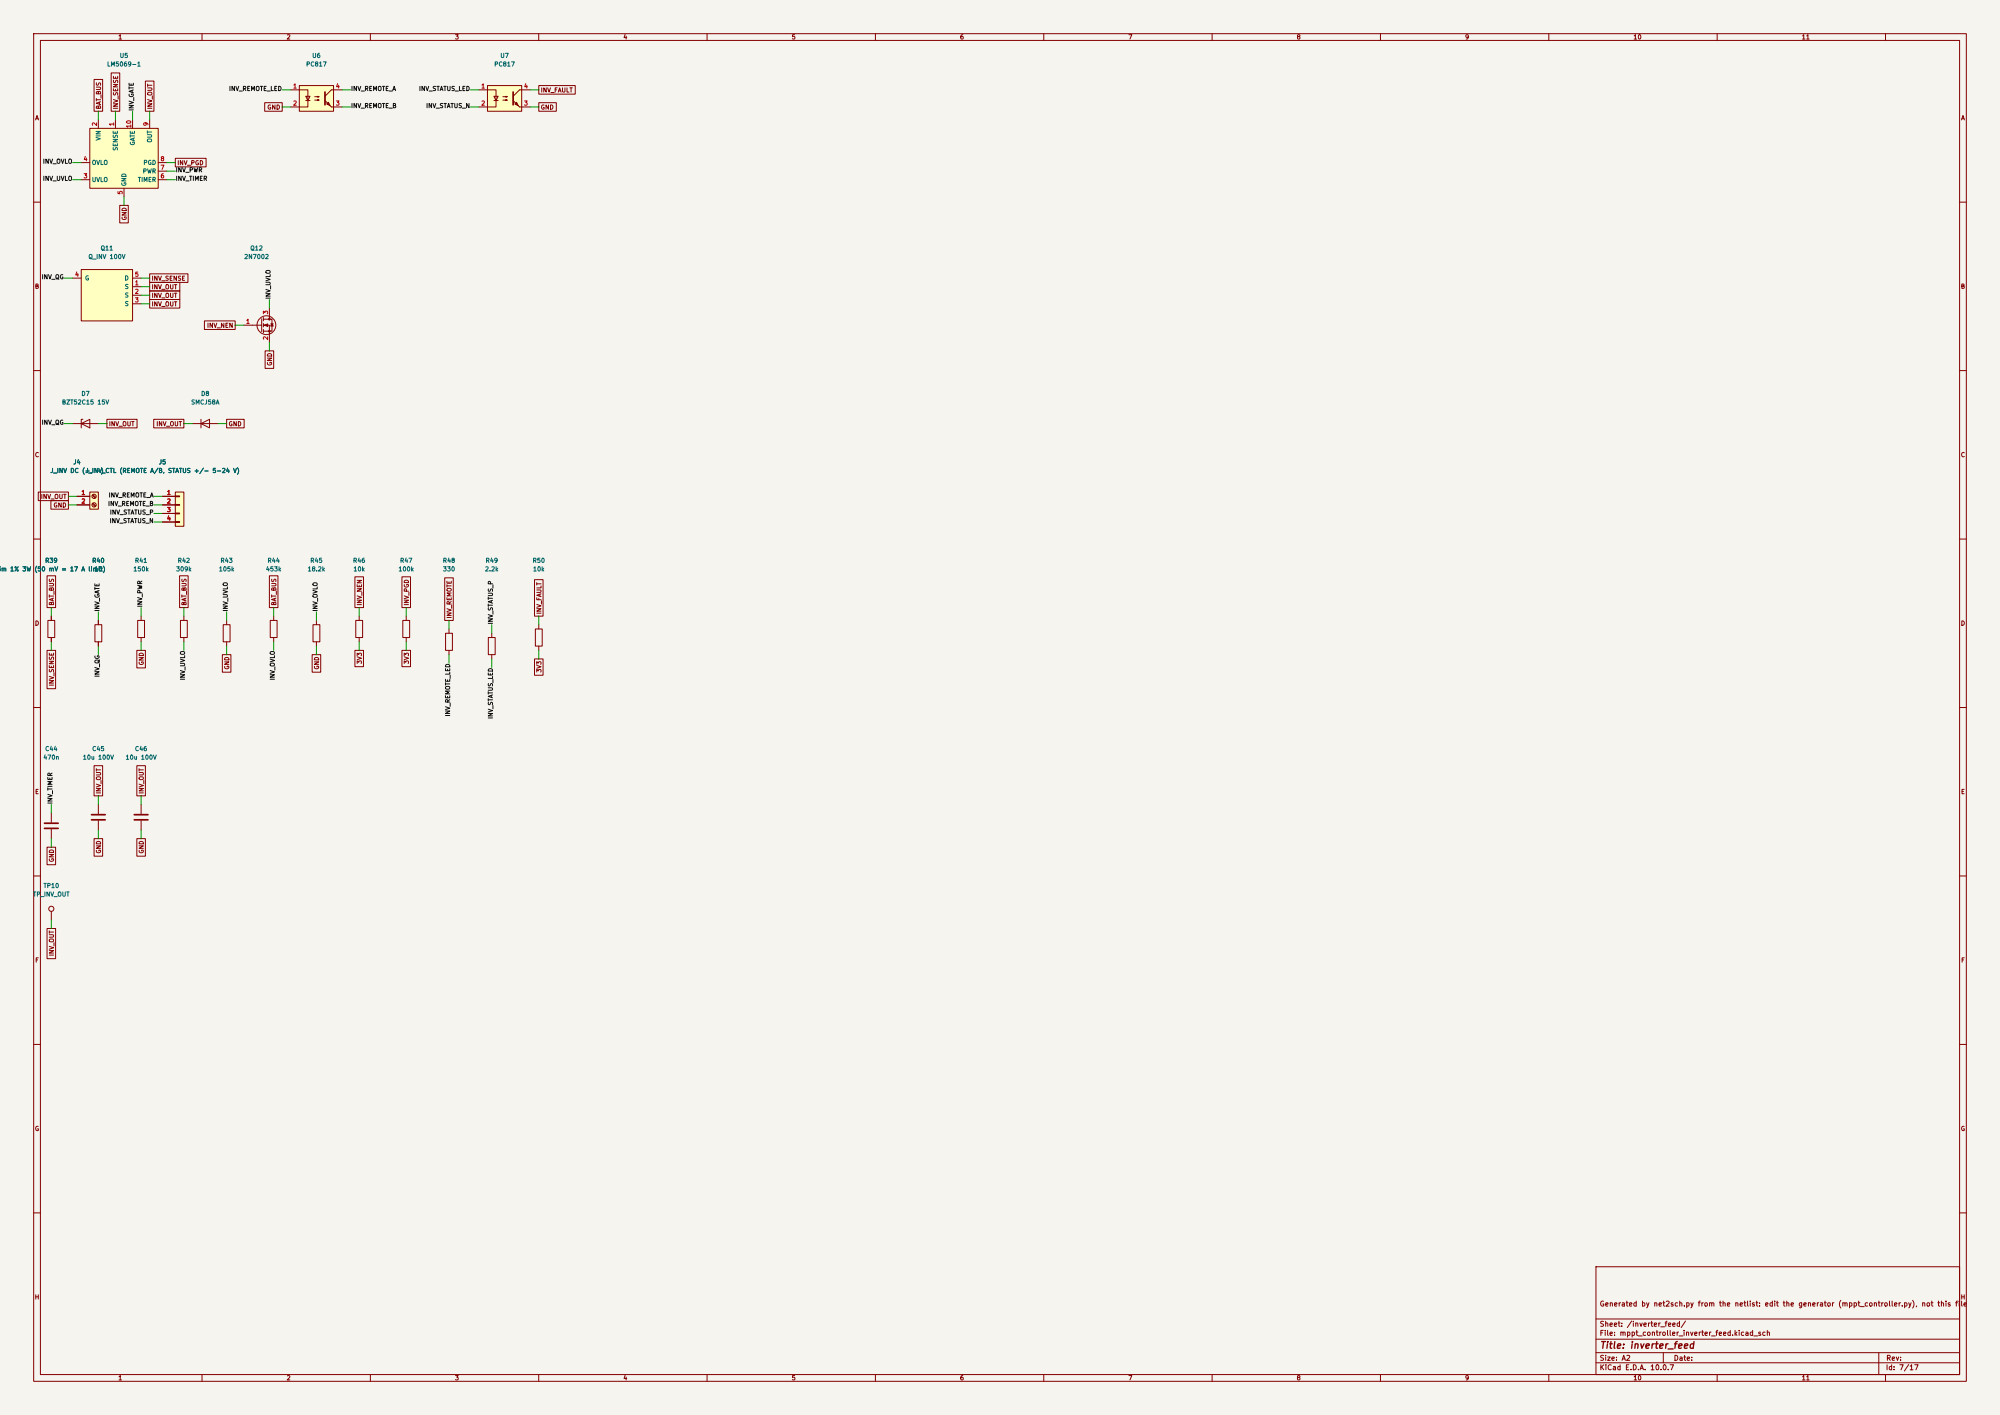
[picture p30: page 7]

5 PWR 7 PGD 8 OUT 9 GATE 10 U5

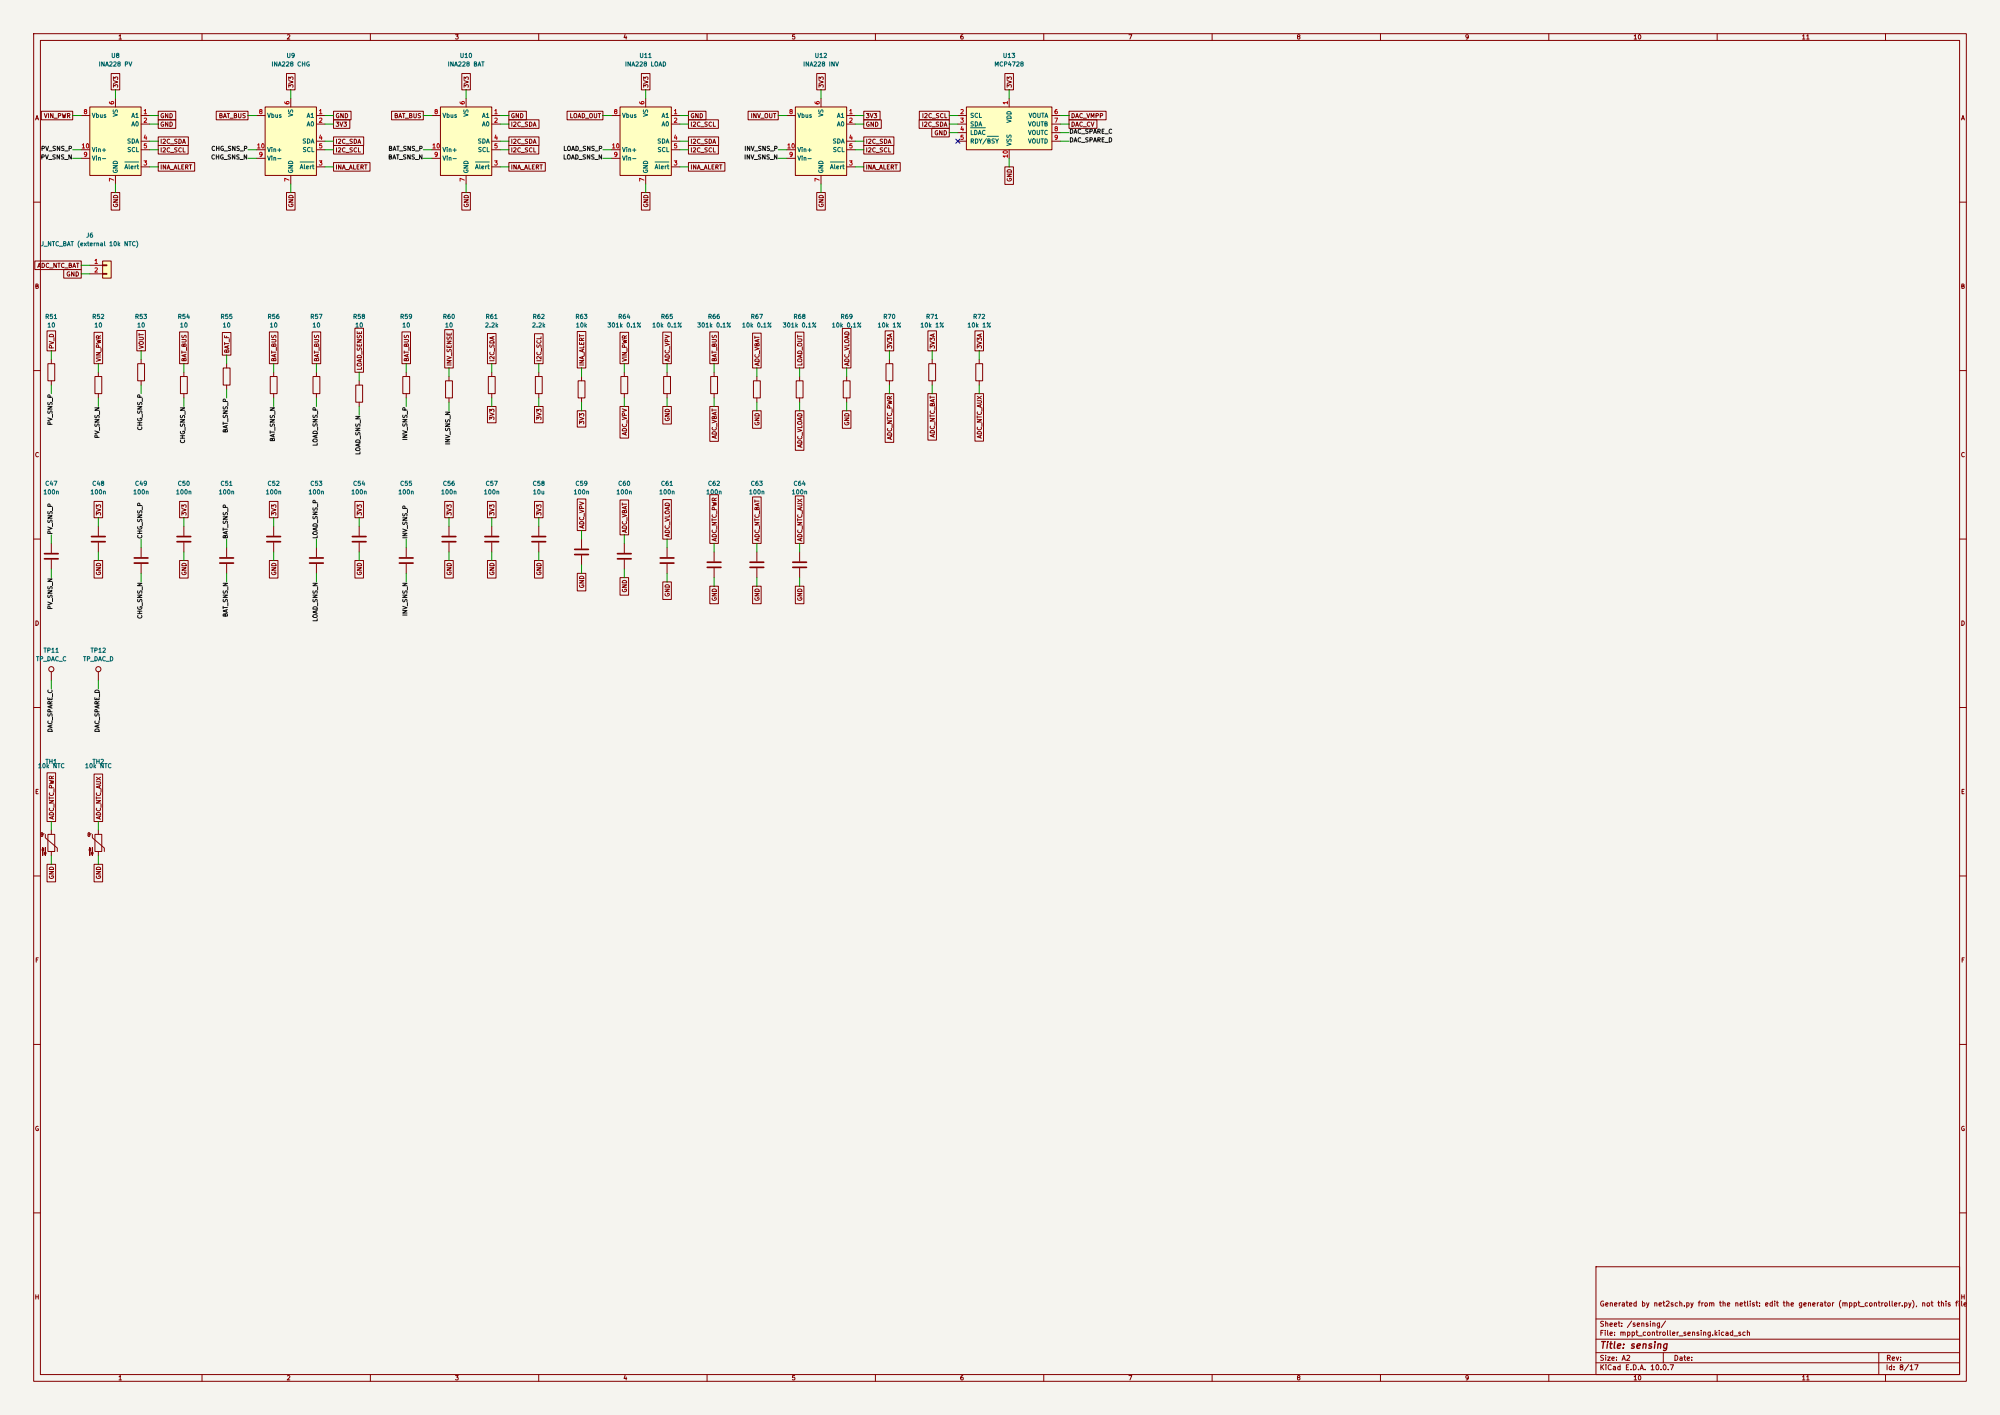
[picture p31: page 8]

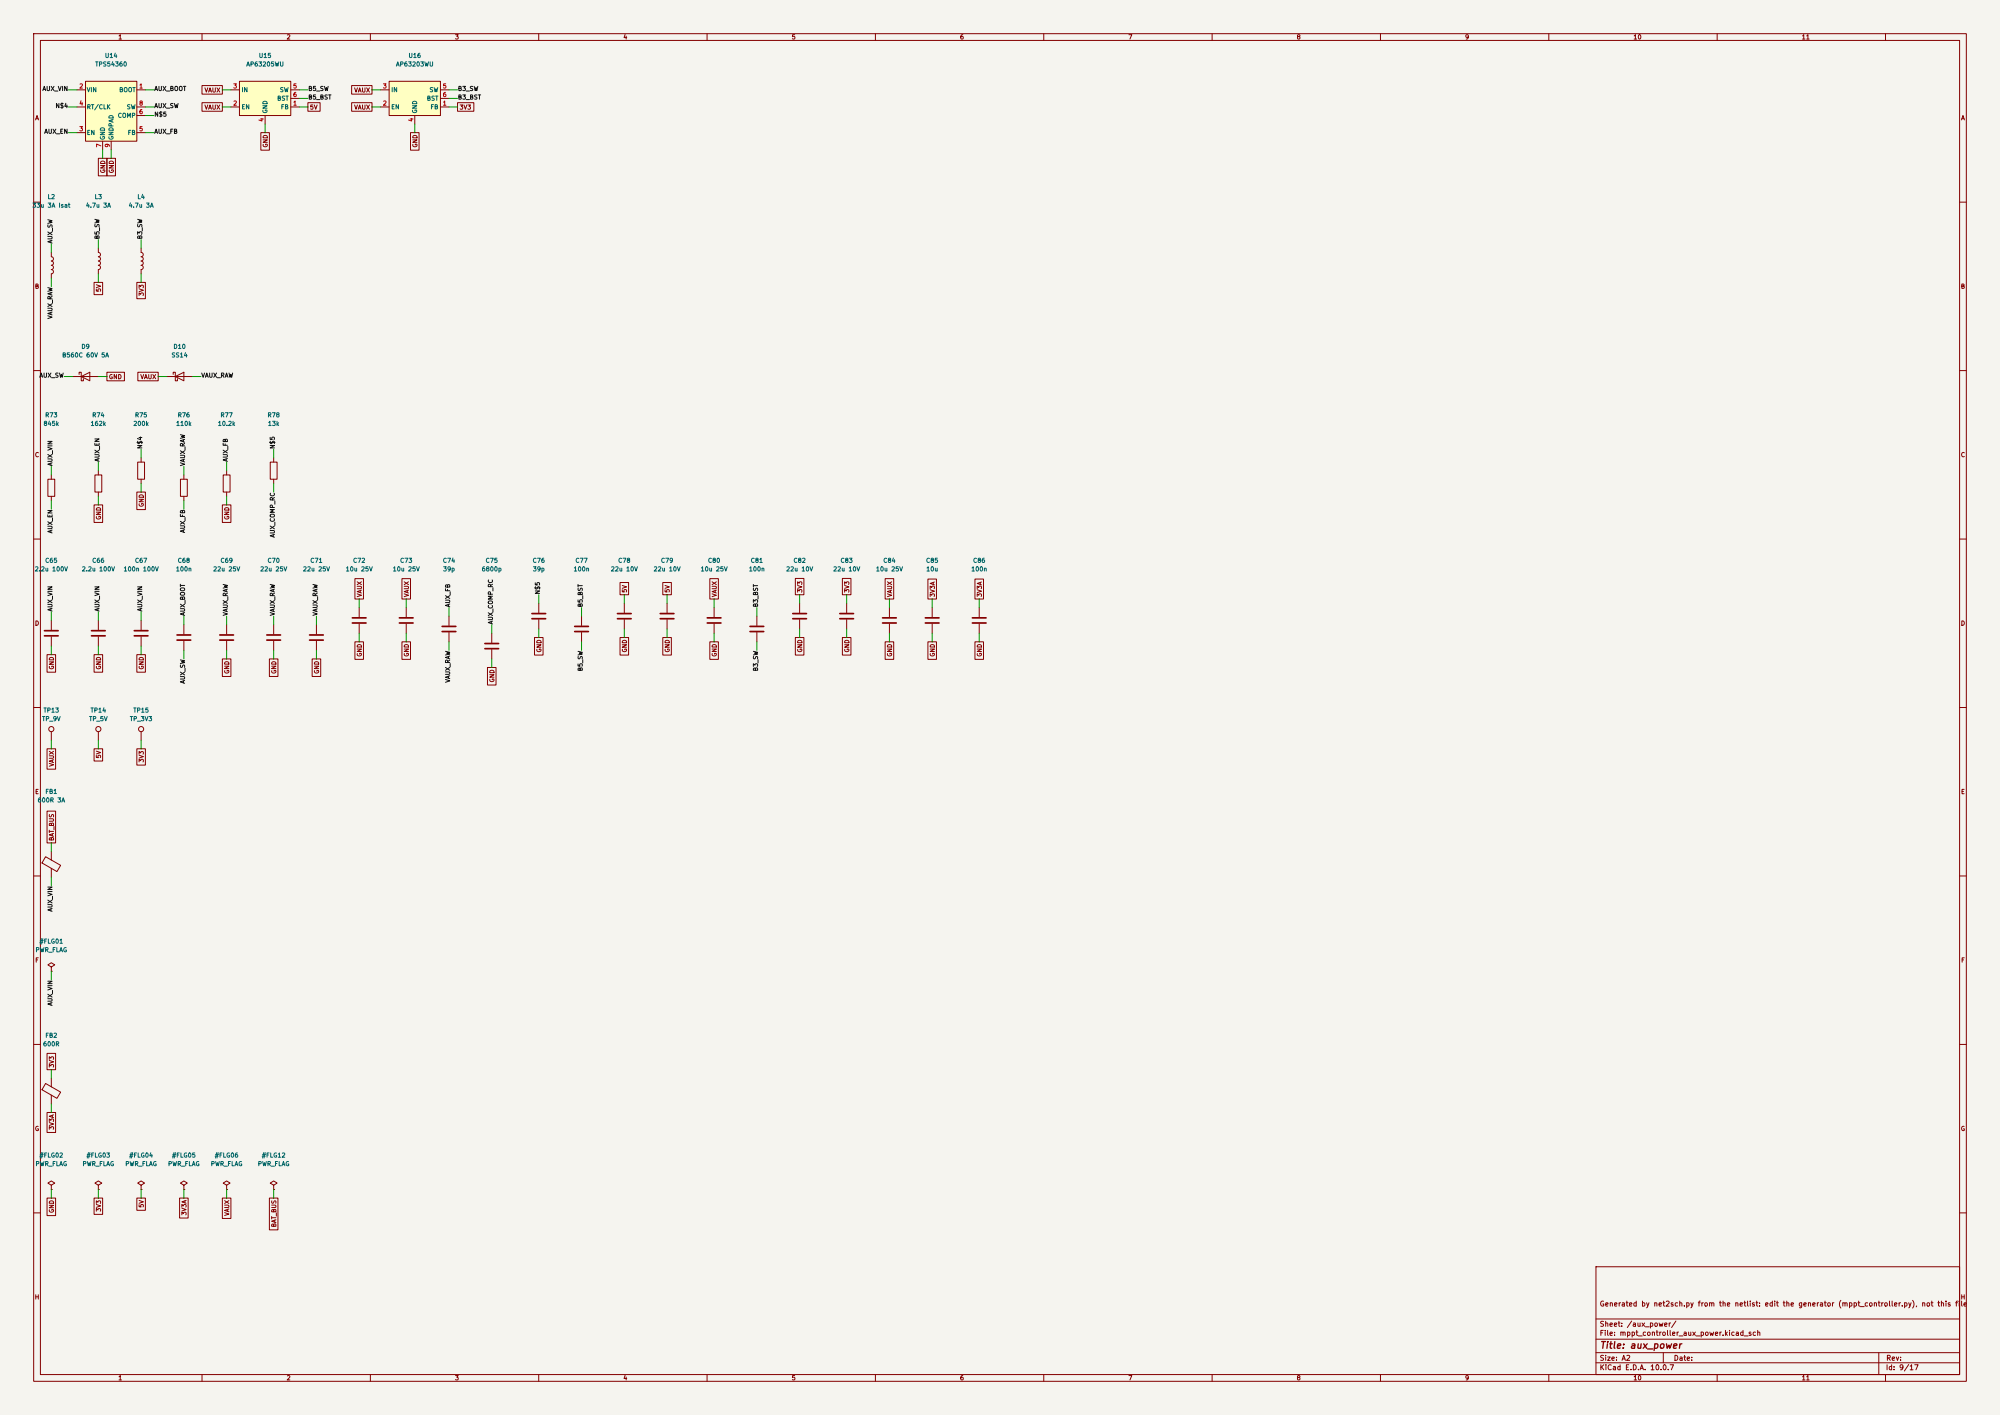
[picture p32: page 9]

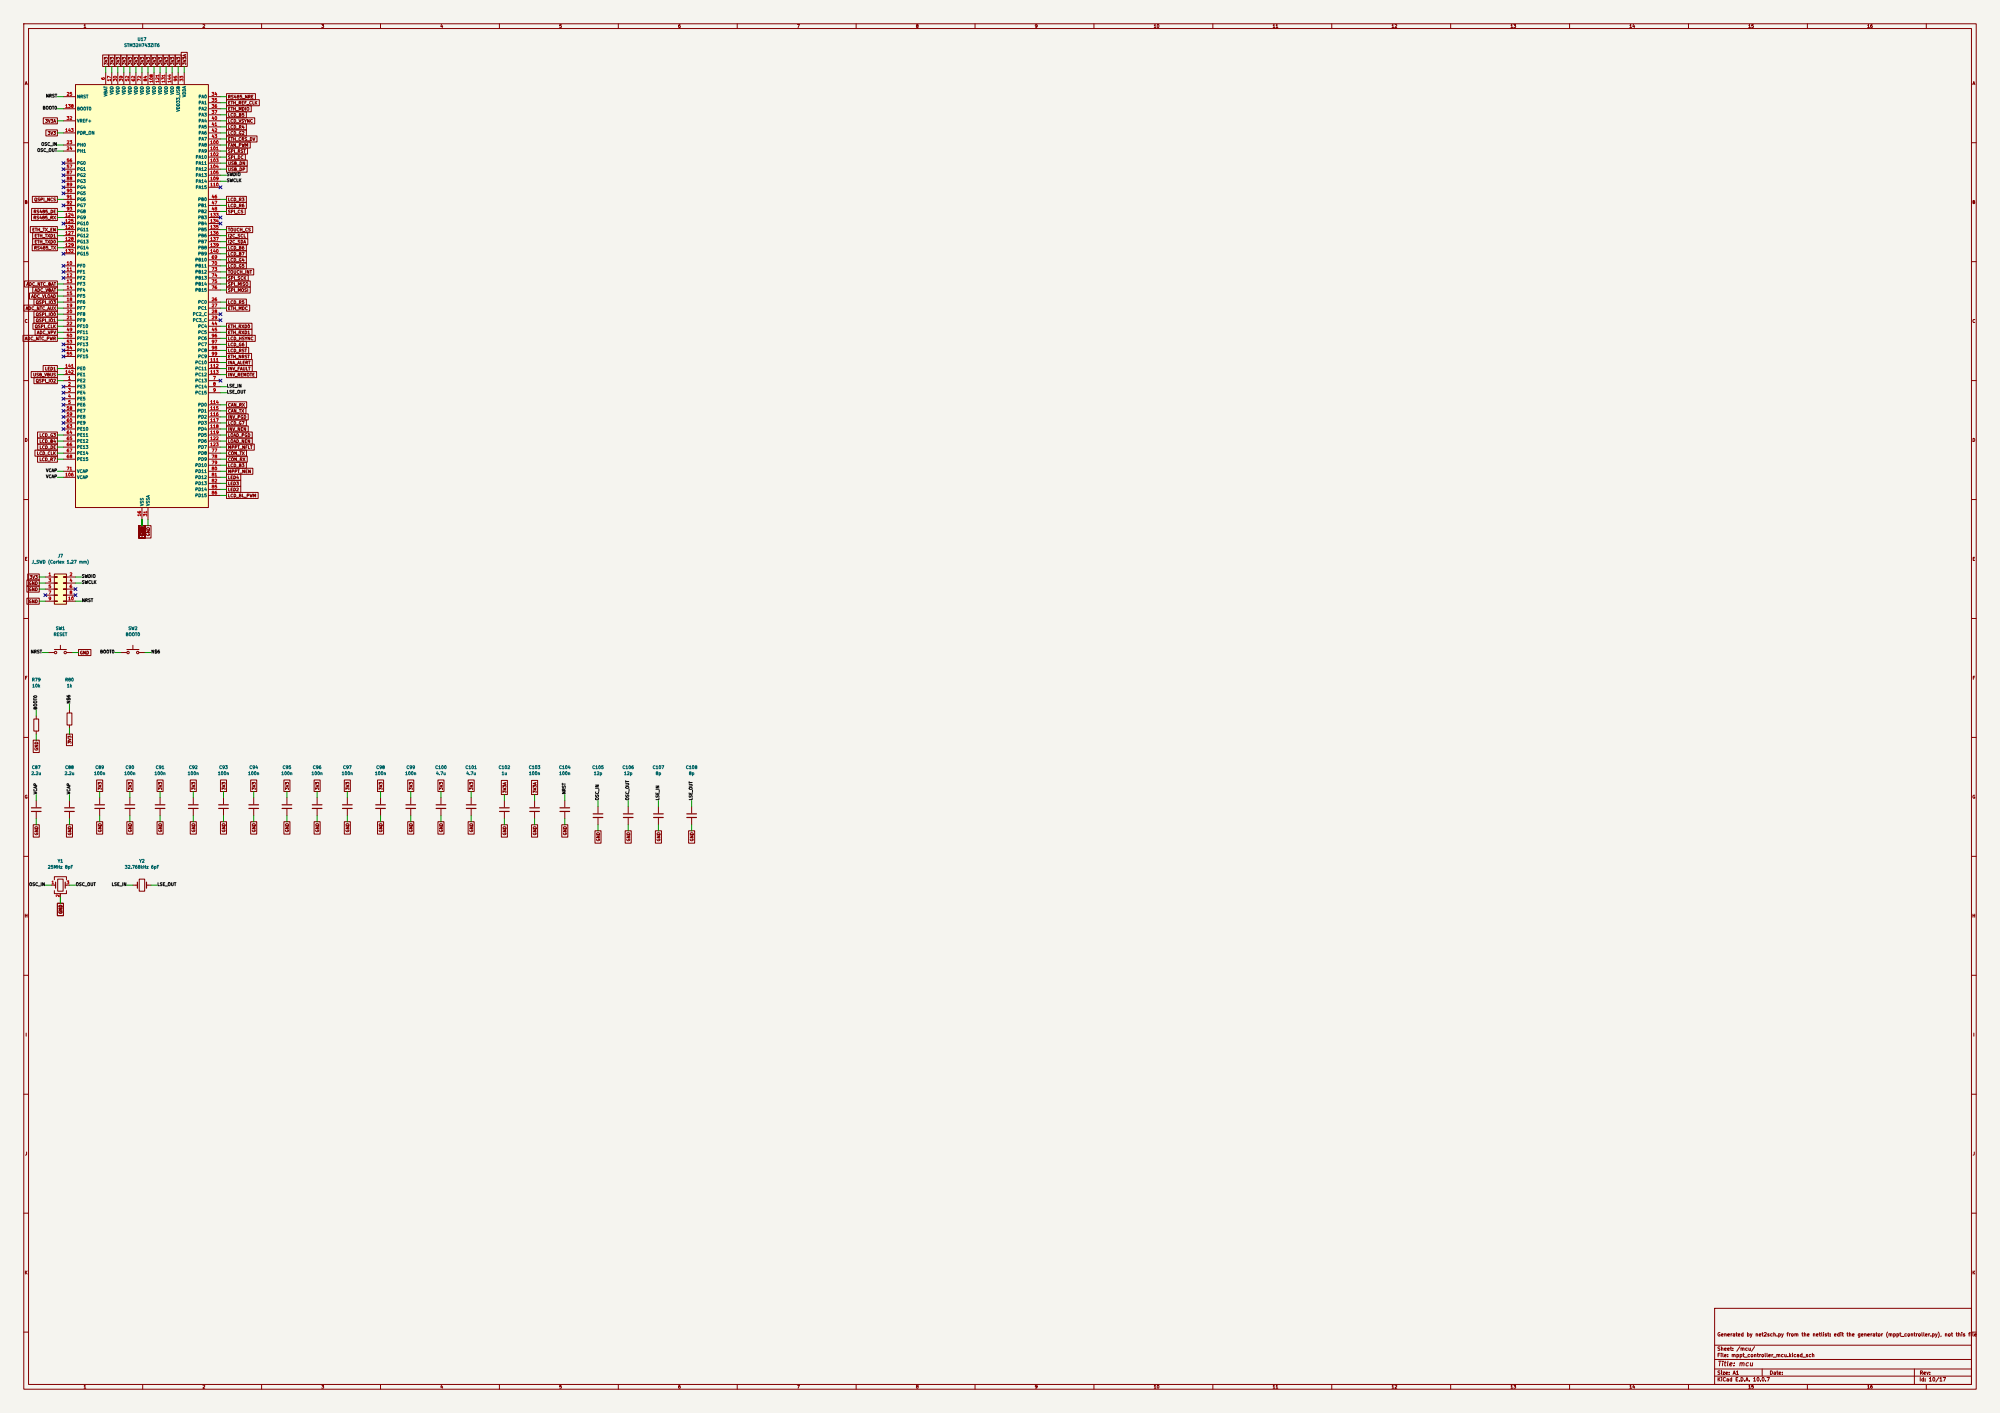
[picture p33: page 10]

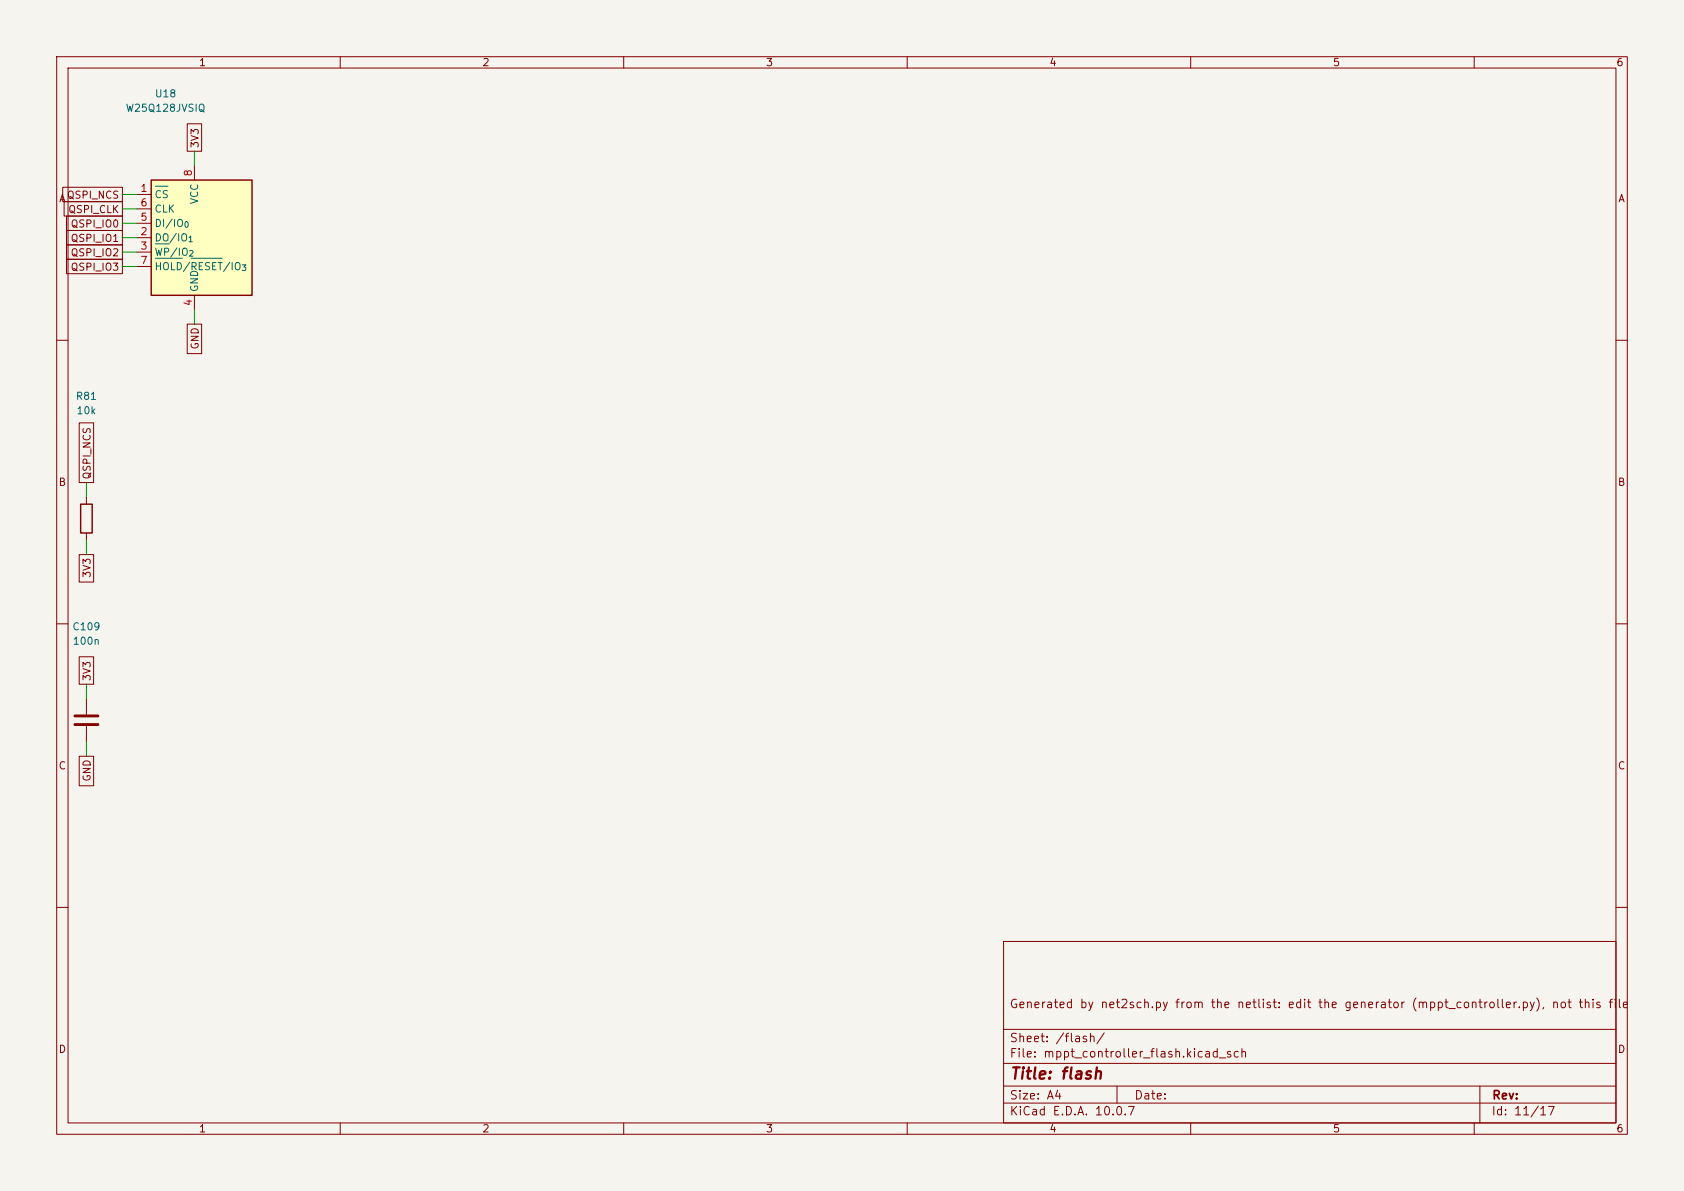
[picture p34: page 11]

4 DI/IO0 5 CLK 6 HOLD/RESET/IO3 7 VCC

Generated by net2sch.py from the netlist: edit the generator (mppt_controller.py), not this file

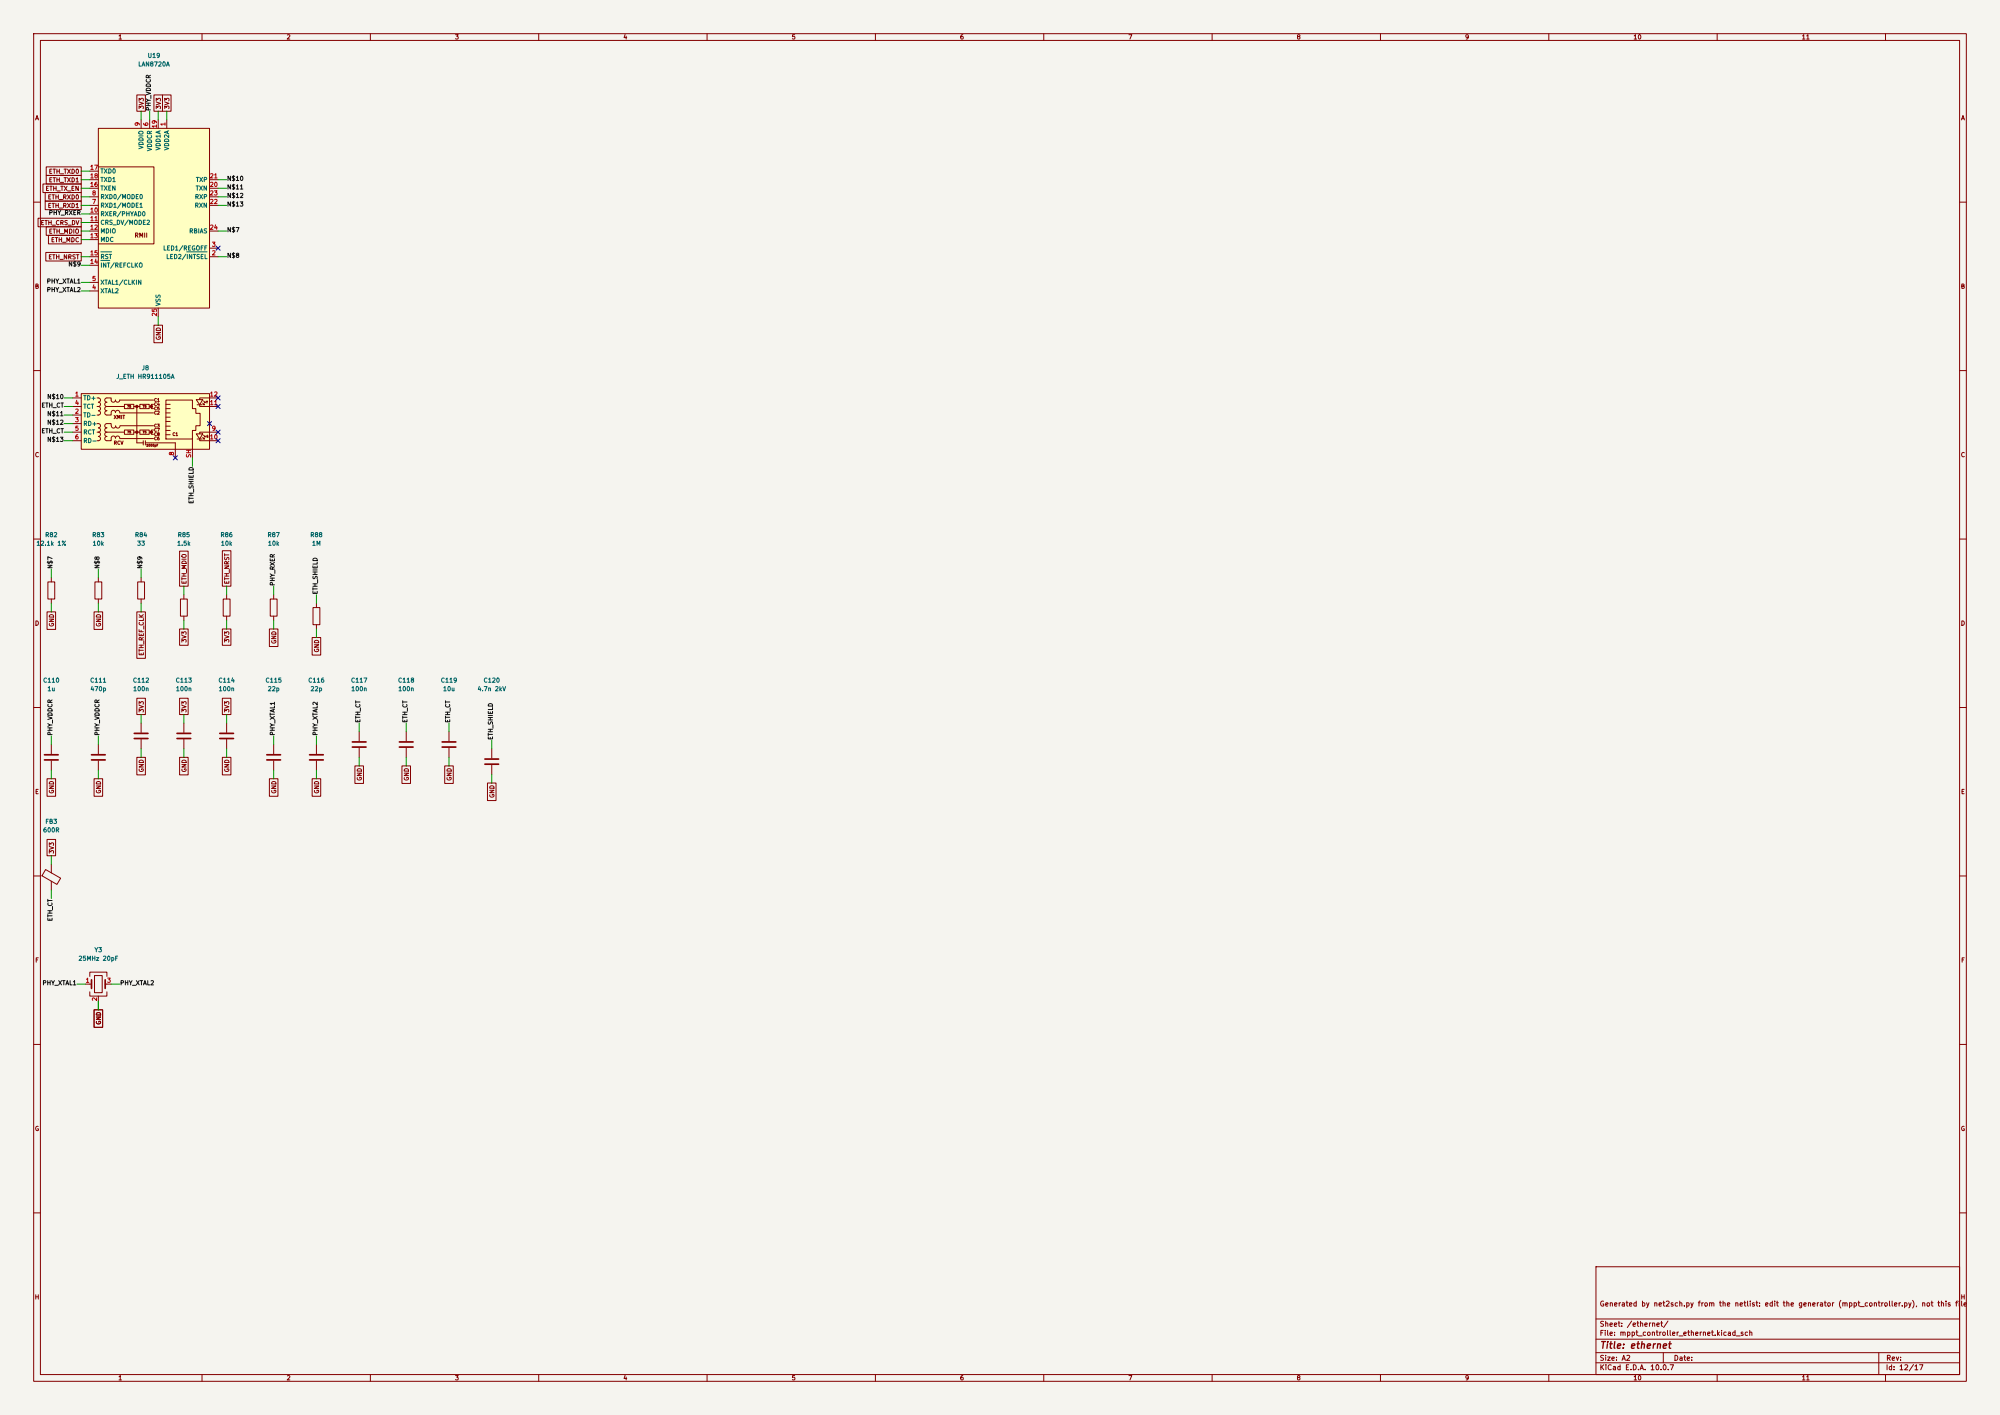
[picture p35: page 12]

TXN 20 TXP 21 RXN 22 RXP 23 RBIAS 24 VSS 25 U19
LAN8720A
ETH_CT PHY_RXER N$12

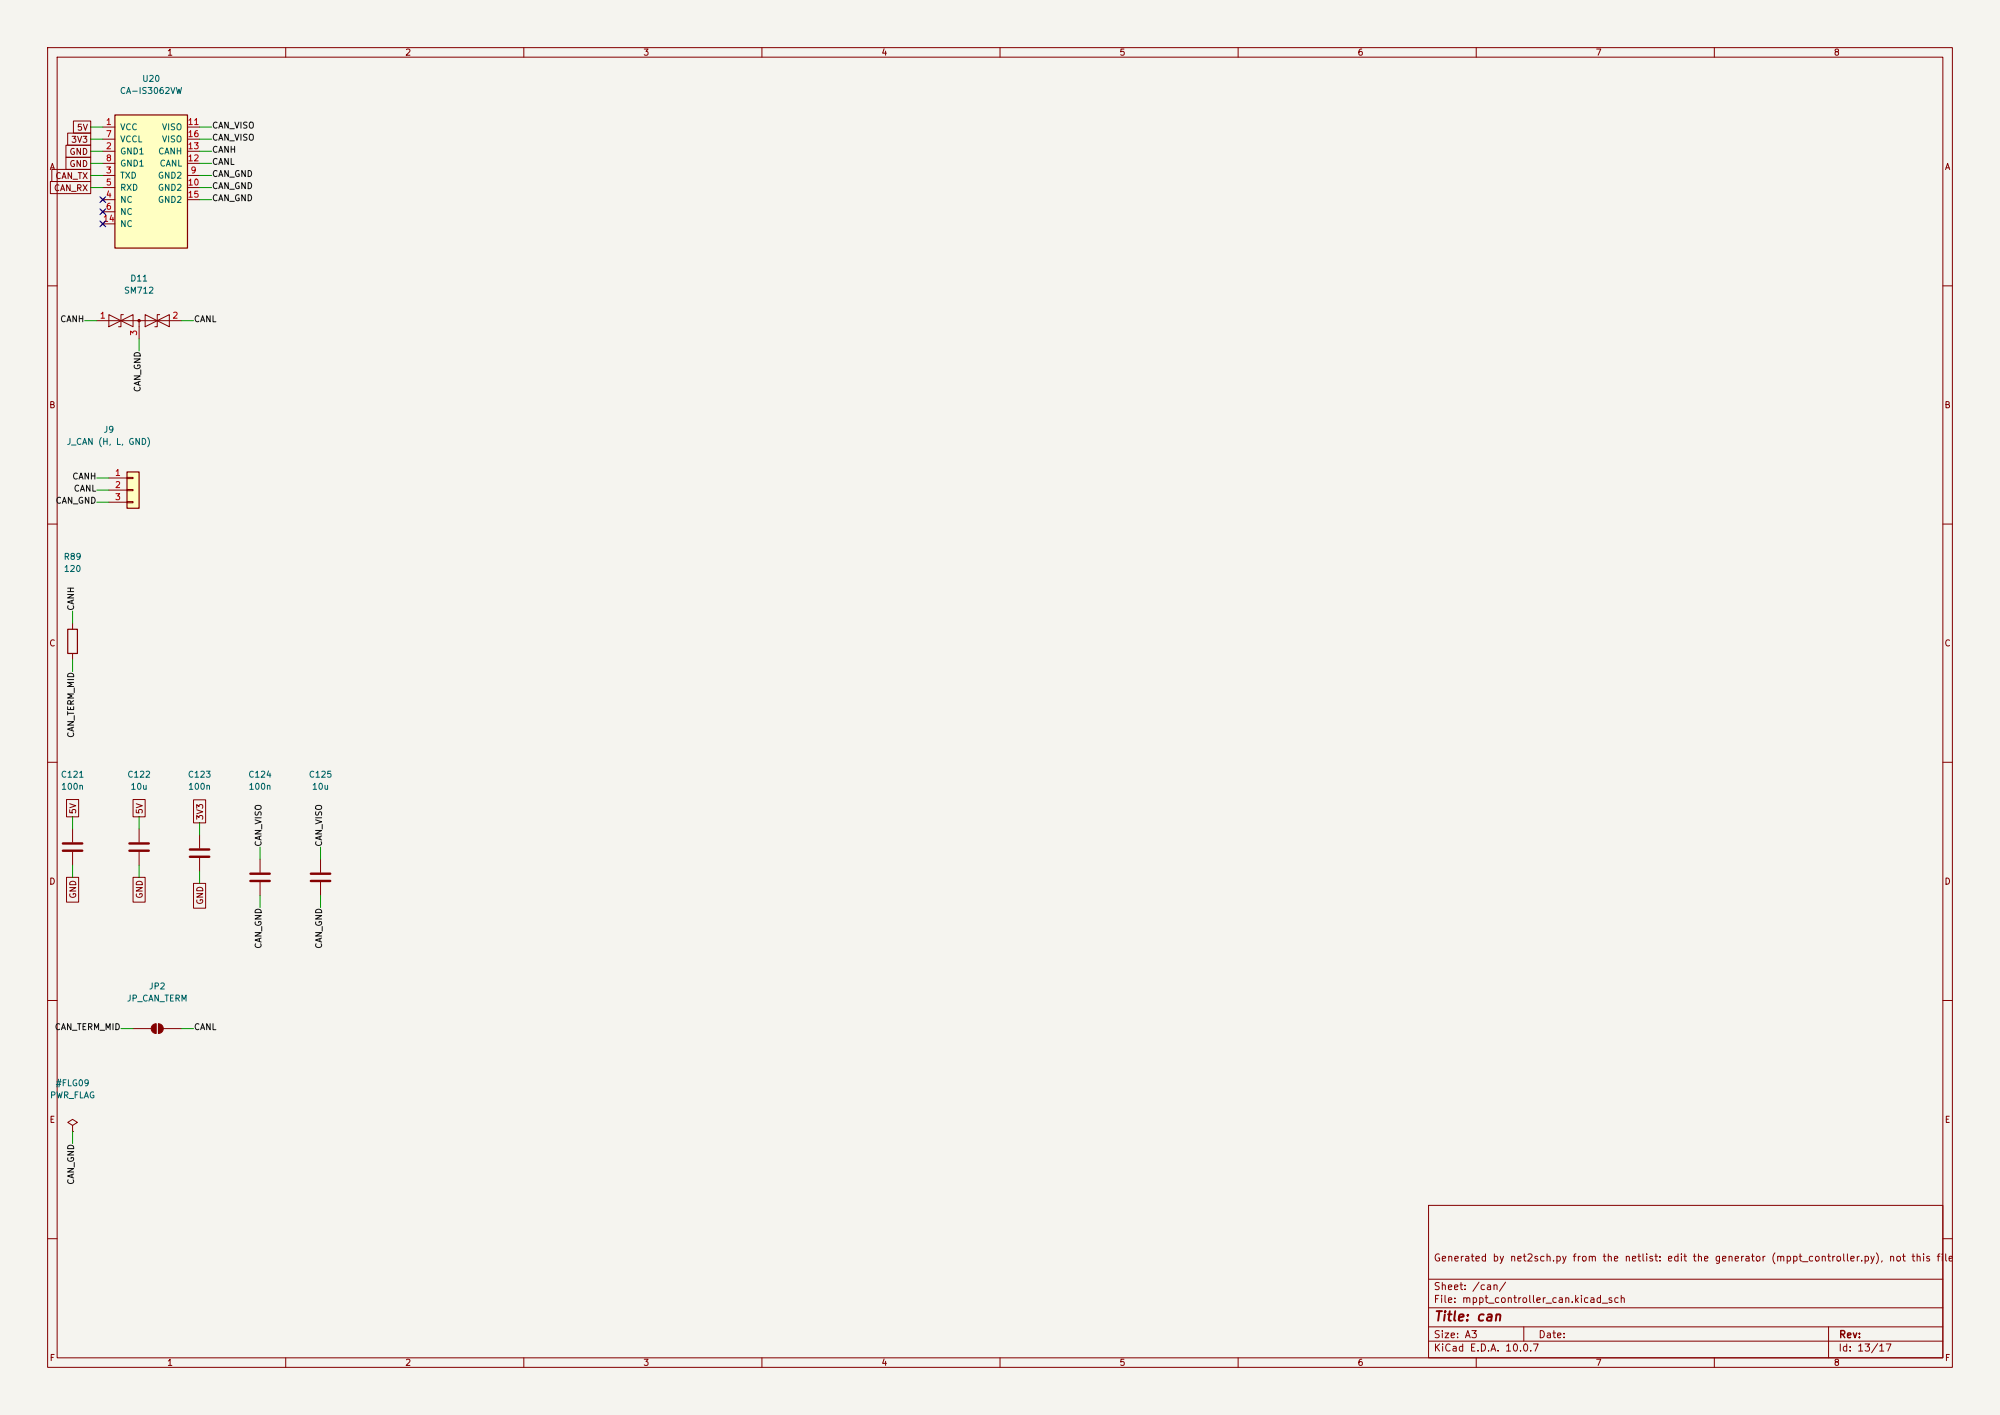
[picture p36: page 13]

Generated by net2sch.py from the netlist: edit the generator (mppt_controller.py), not this file

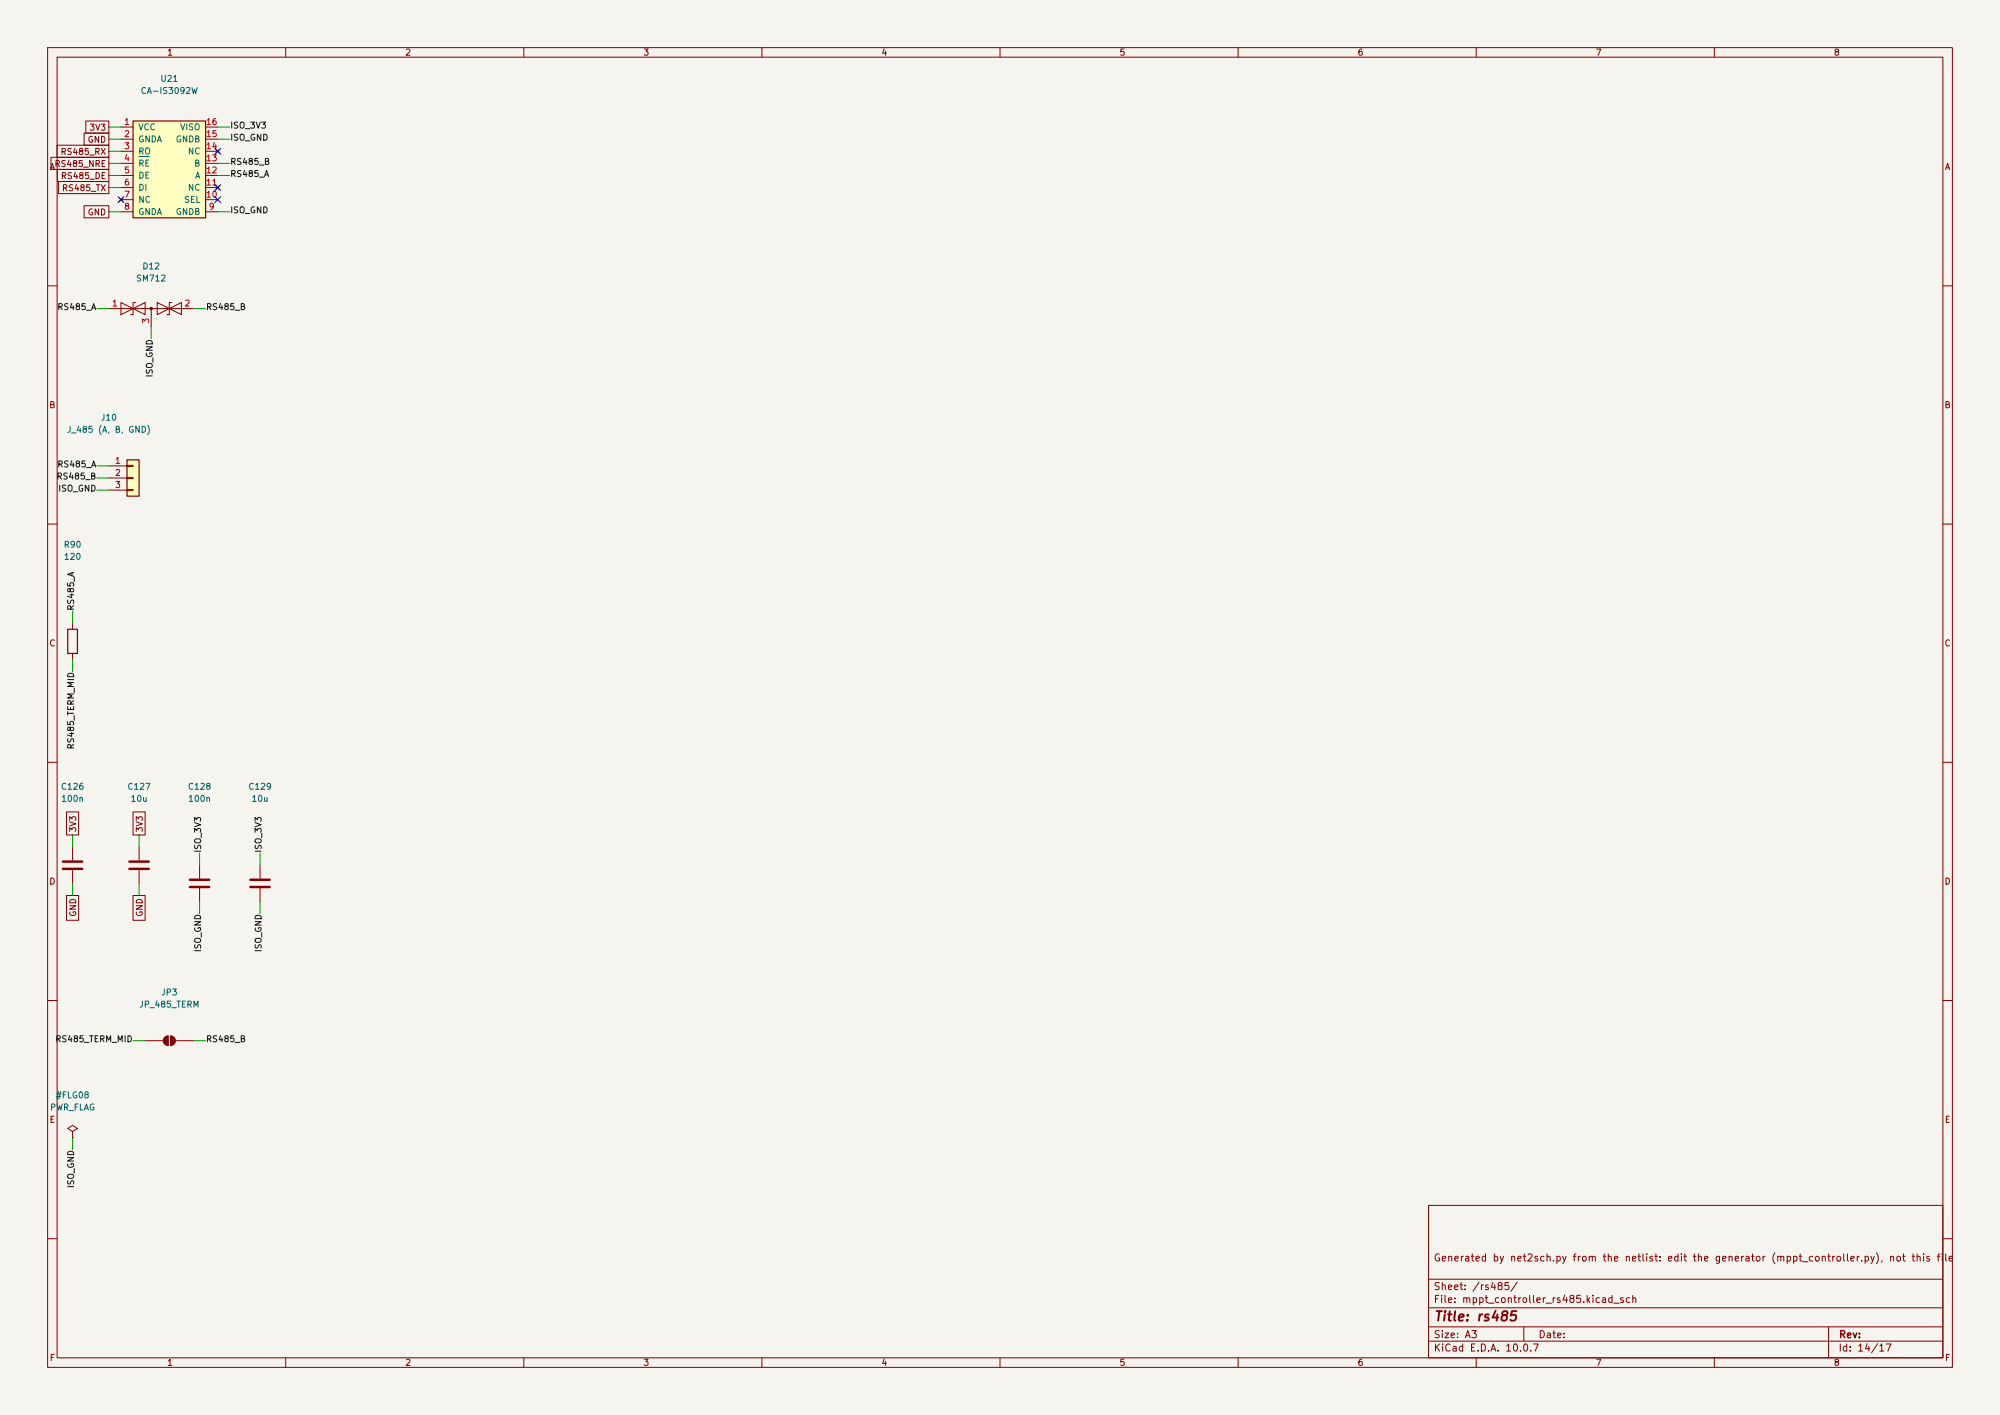
[picture p37: page 14]

Generated by net2sch.py from the netlist: edit the generator (mppt_controller.py), not this file

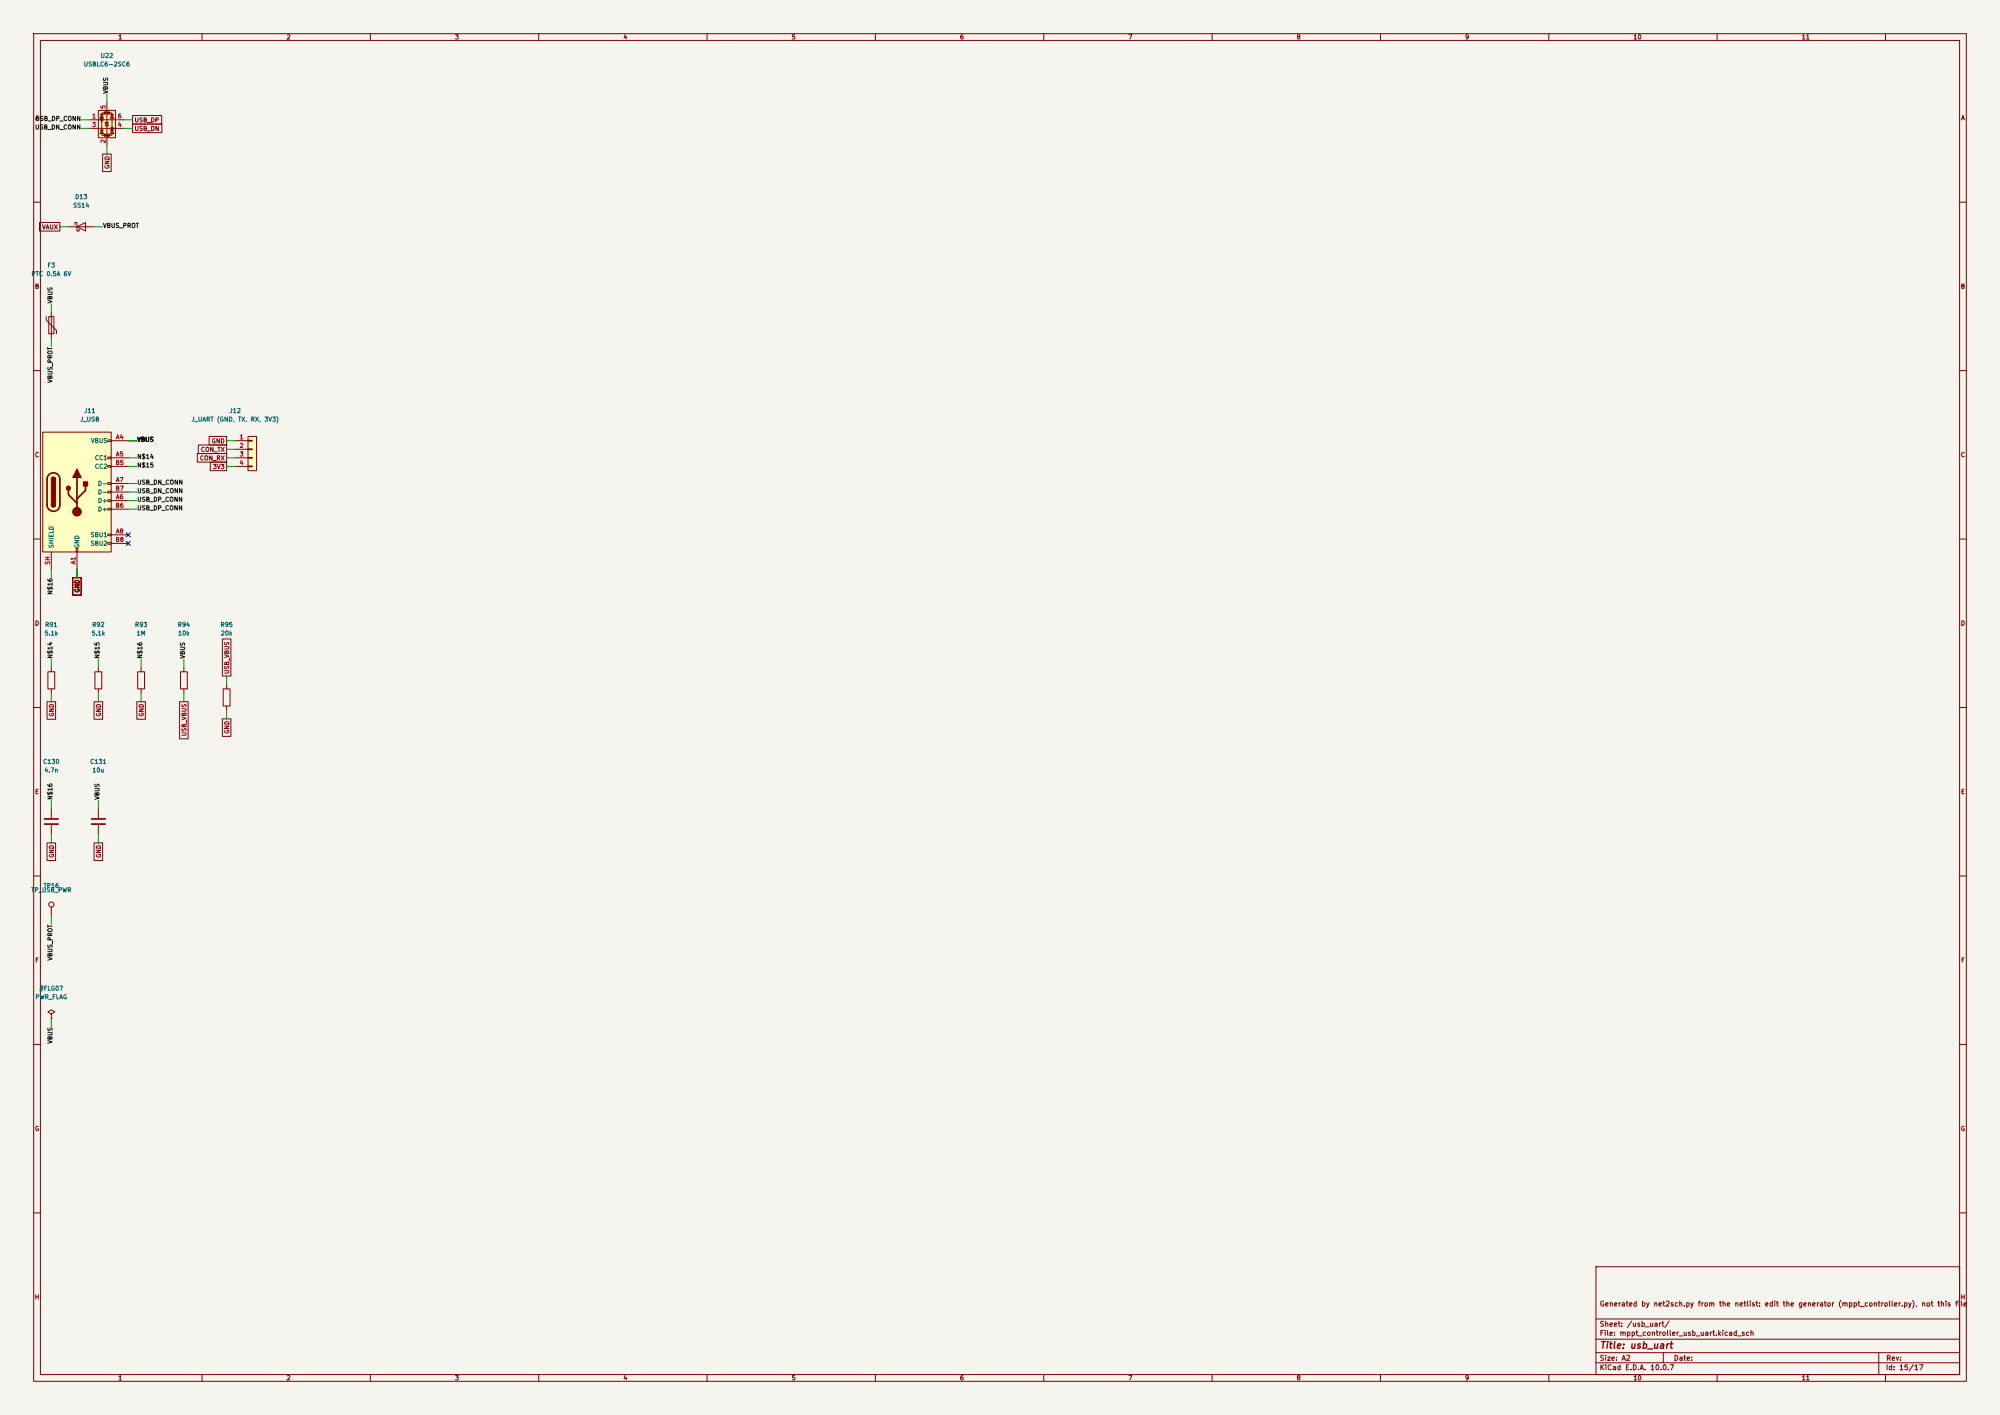
[picture p38: page 15]

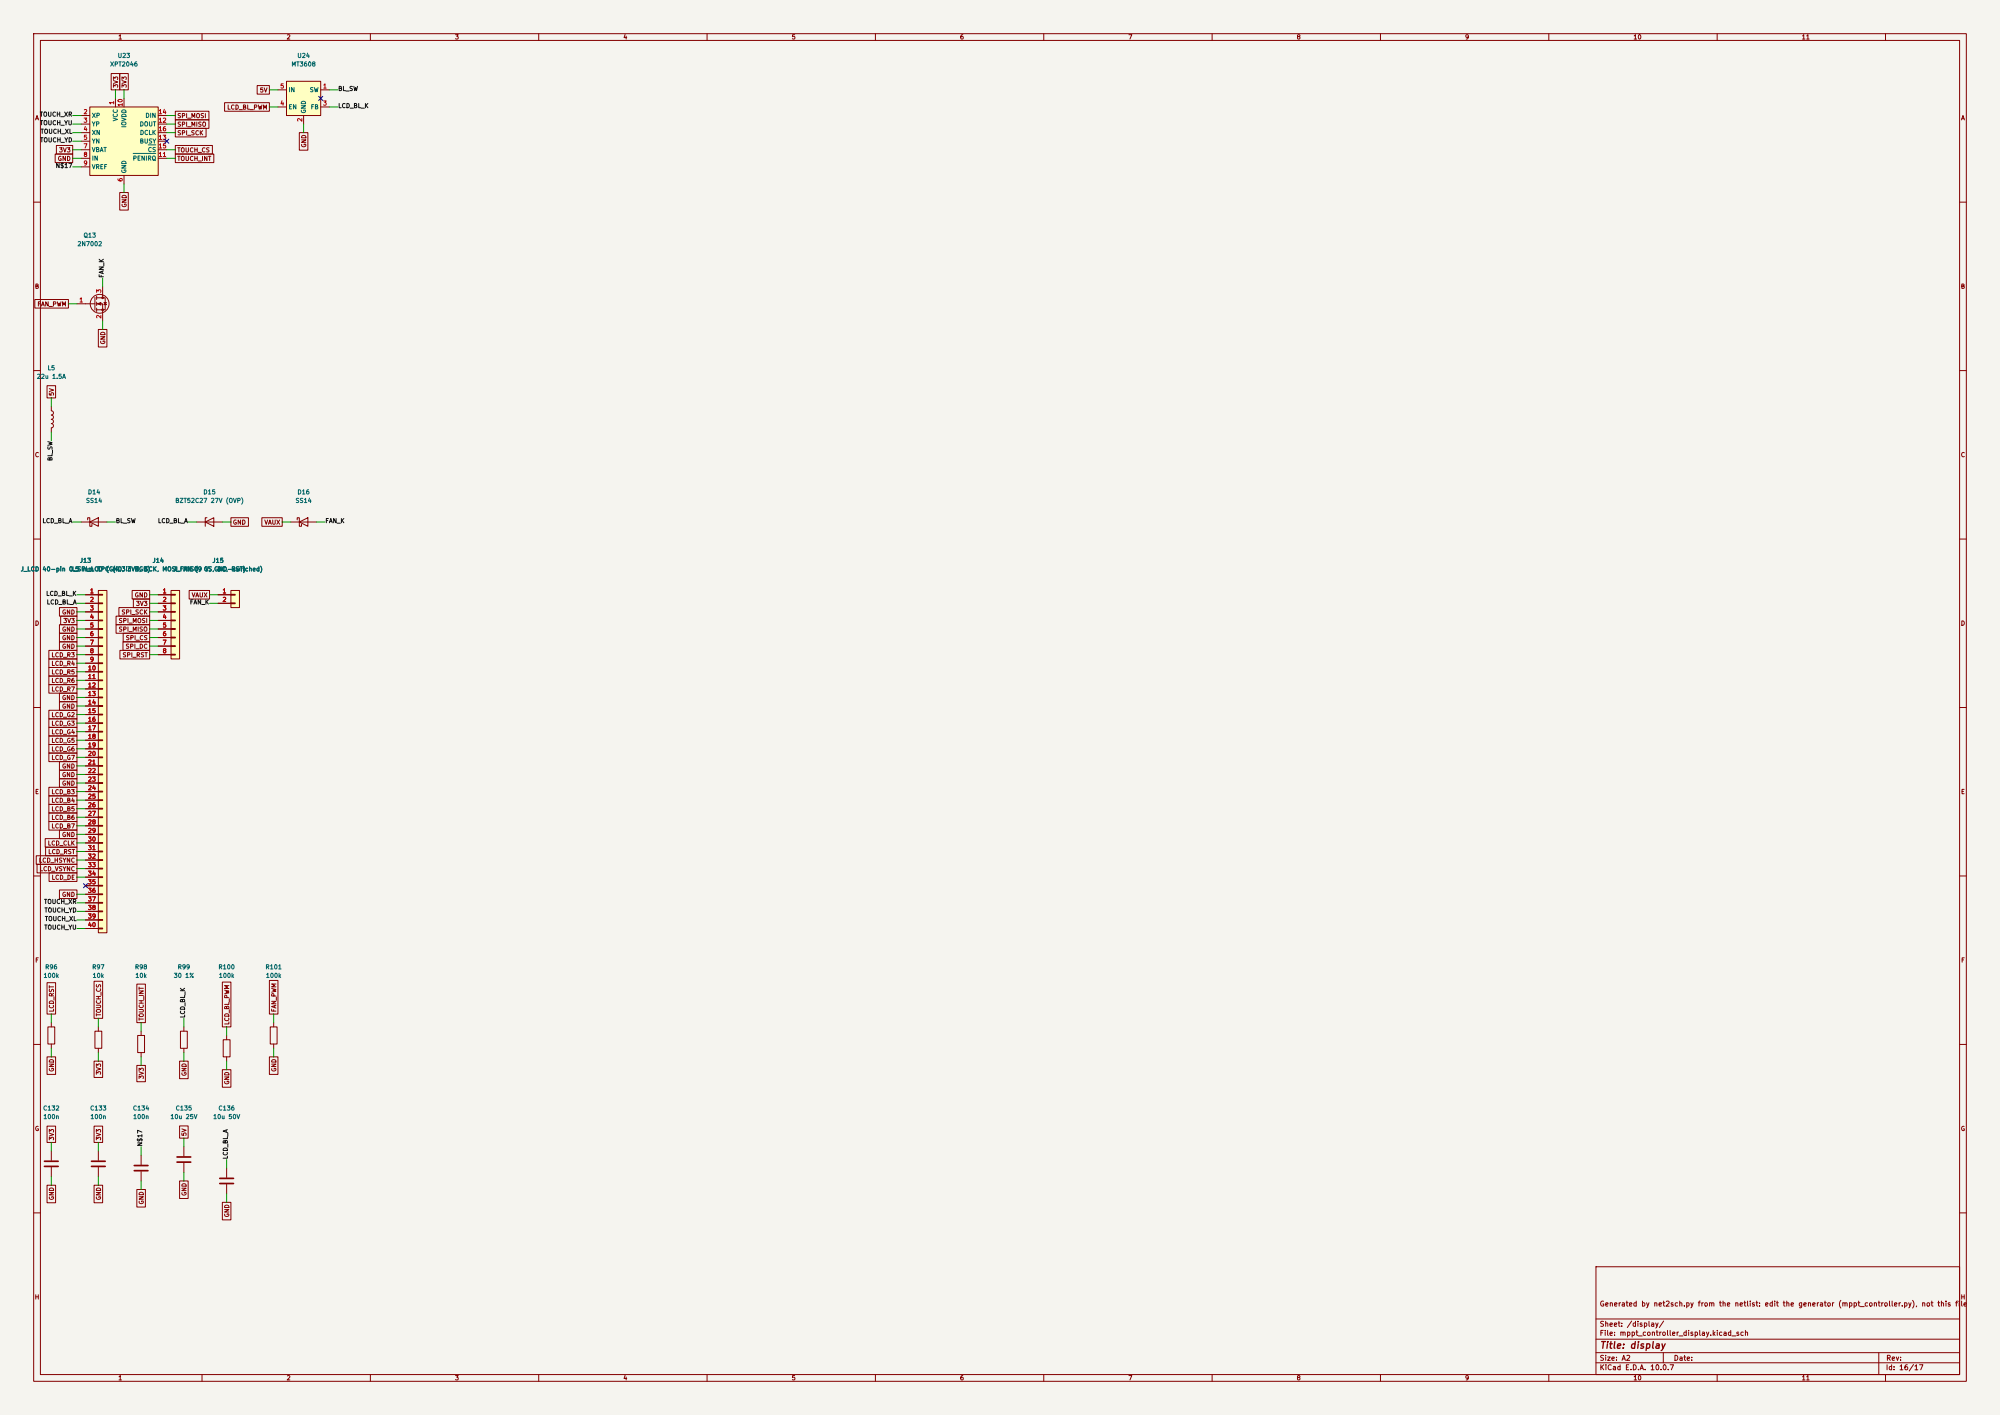
[picture p39: page 16]

J_SPI_LCD (GND, 3V3, SCK, MOSI, MISO, CS, DC, RST) 12

J_LCD 40-pin 0.5 mm FPC (4.3in RGB) 123456789

J_SPI_LCD (GND, 3V3, SCK, MOSI, MISO, CS, DC, RST) 12345678

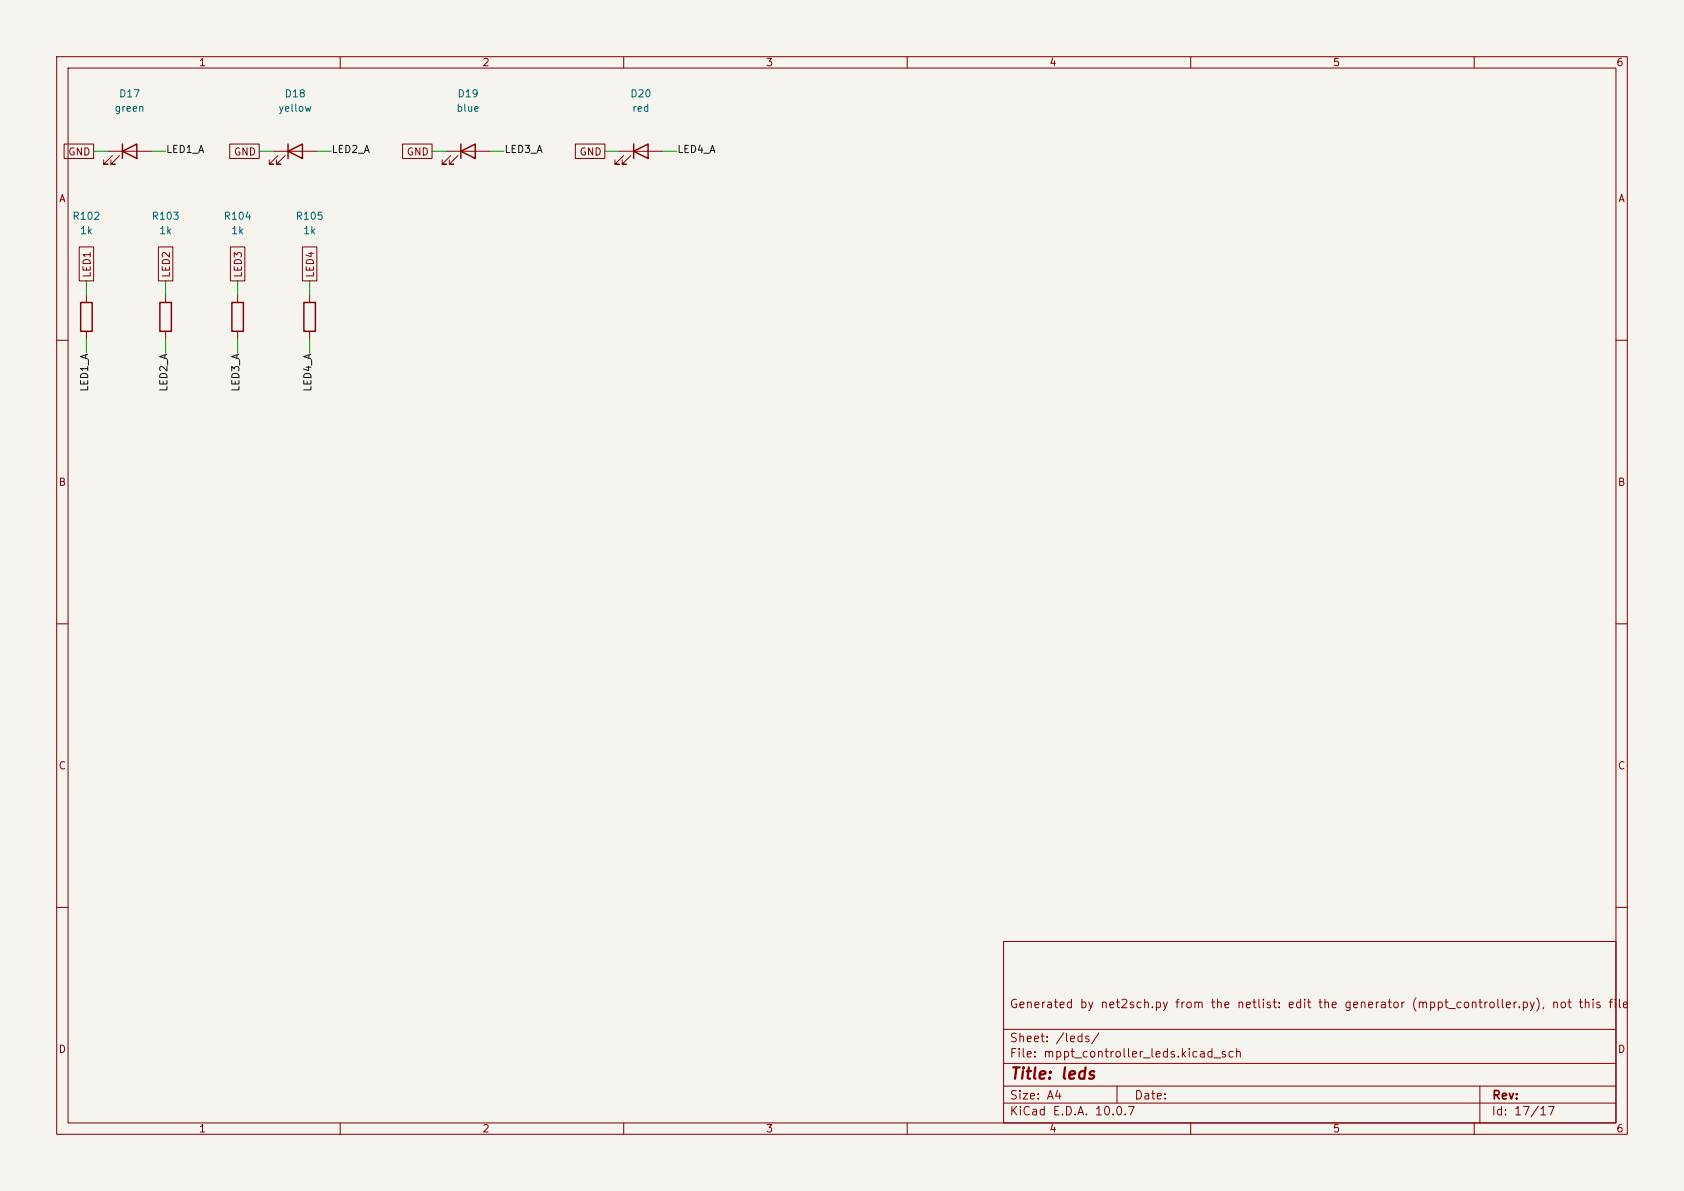
[picture p40: page 17]

Generated by net2sch.py from the netlist: edit the generator (mppt_controller.py), not this file
