mtilocca/mppt-controller/(list of files, drawings)

Other design files:
hardware/_route2.dsn
hardware/_route.dsn
