mtilocca/mppt-controller/hardware/mppt_controller.kicad_pcb

## KiCad design hardware/mppt_controller.kicad_pcb (2026-11-10)

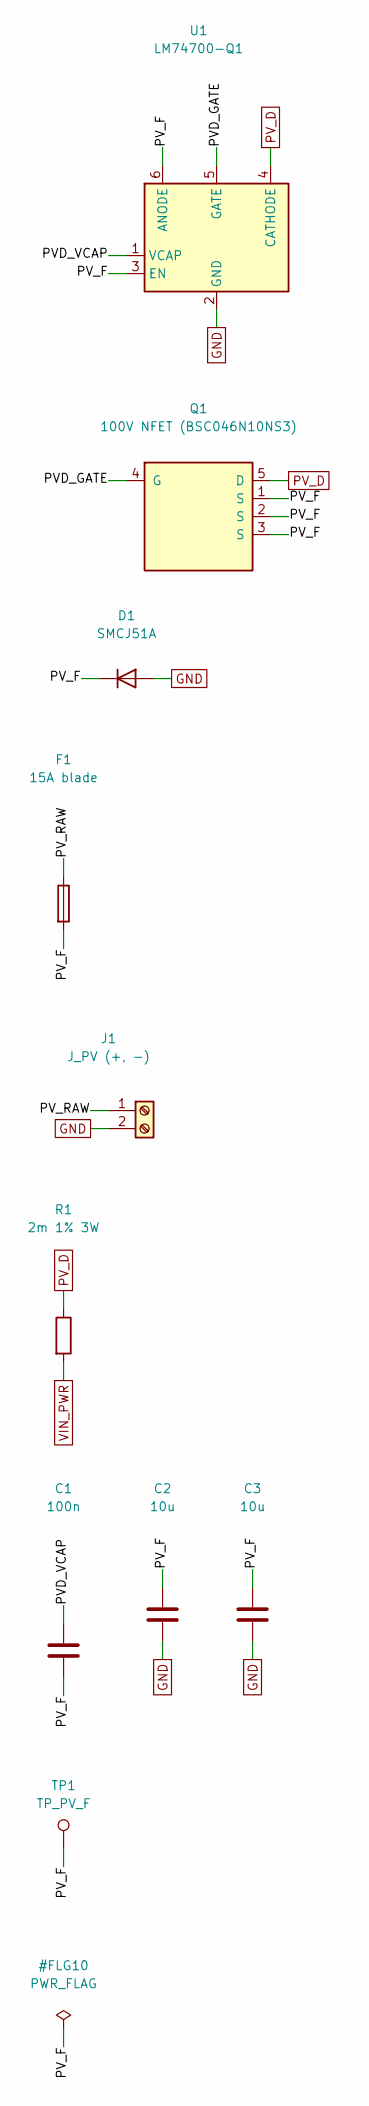
[picture p41: schematic mppt_controller_pv_input.kicad_sch, pv_input]

Parts:
C1: 100n; C_0805_2012Metric
C2, C3: 10u; C_1210_3225Metric
D1: SMCJ51A; D_SMC
F1: 15A blade; Fuseholder_Blade_Mini_Keystone_3568
J1: J_PV (+, -); TerminalBlock_Phoenix_MKDS-3-2-5.08_1x02_P5.08mm_Horizontal
Q1: 100V NFET (BSC046N10NS3); TDSON-8-1
R1: 2m 1% 3W; R_2512_6332Metric
TP1: TP_PV_F; TestPoint_Pad_D1.5mm
U1: LM74700-Q1; SOT-23-6

Connections:
/pv_input/PVD_GATE: Q1.4 (G), U1.5 (GATE)
/pv_input/PVD_VCAP: C1.1, U1.1 (VCAP)
/pv_input/PV_F: C1.2, C2.1, C3.1, D1.1 (K), F1.2, Q1.1 (S), Q1.2 (S), Q1.3 (S), TP1.1, U1.3 (EN), U1.6 (ANODE)
/pv_input/PV_RAW: F1.1, J1.1
GND: C2.2, C3.2, D1.2 (A), J1.2, U1.2 (GND); also elsewhere on the board
PV_D: Q1.5 (D), R1.1, U1.4 (CATHODE); also elsewhere on the board
VIN_PWR: R1.2; also elsewhere on the board

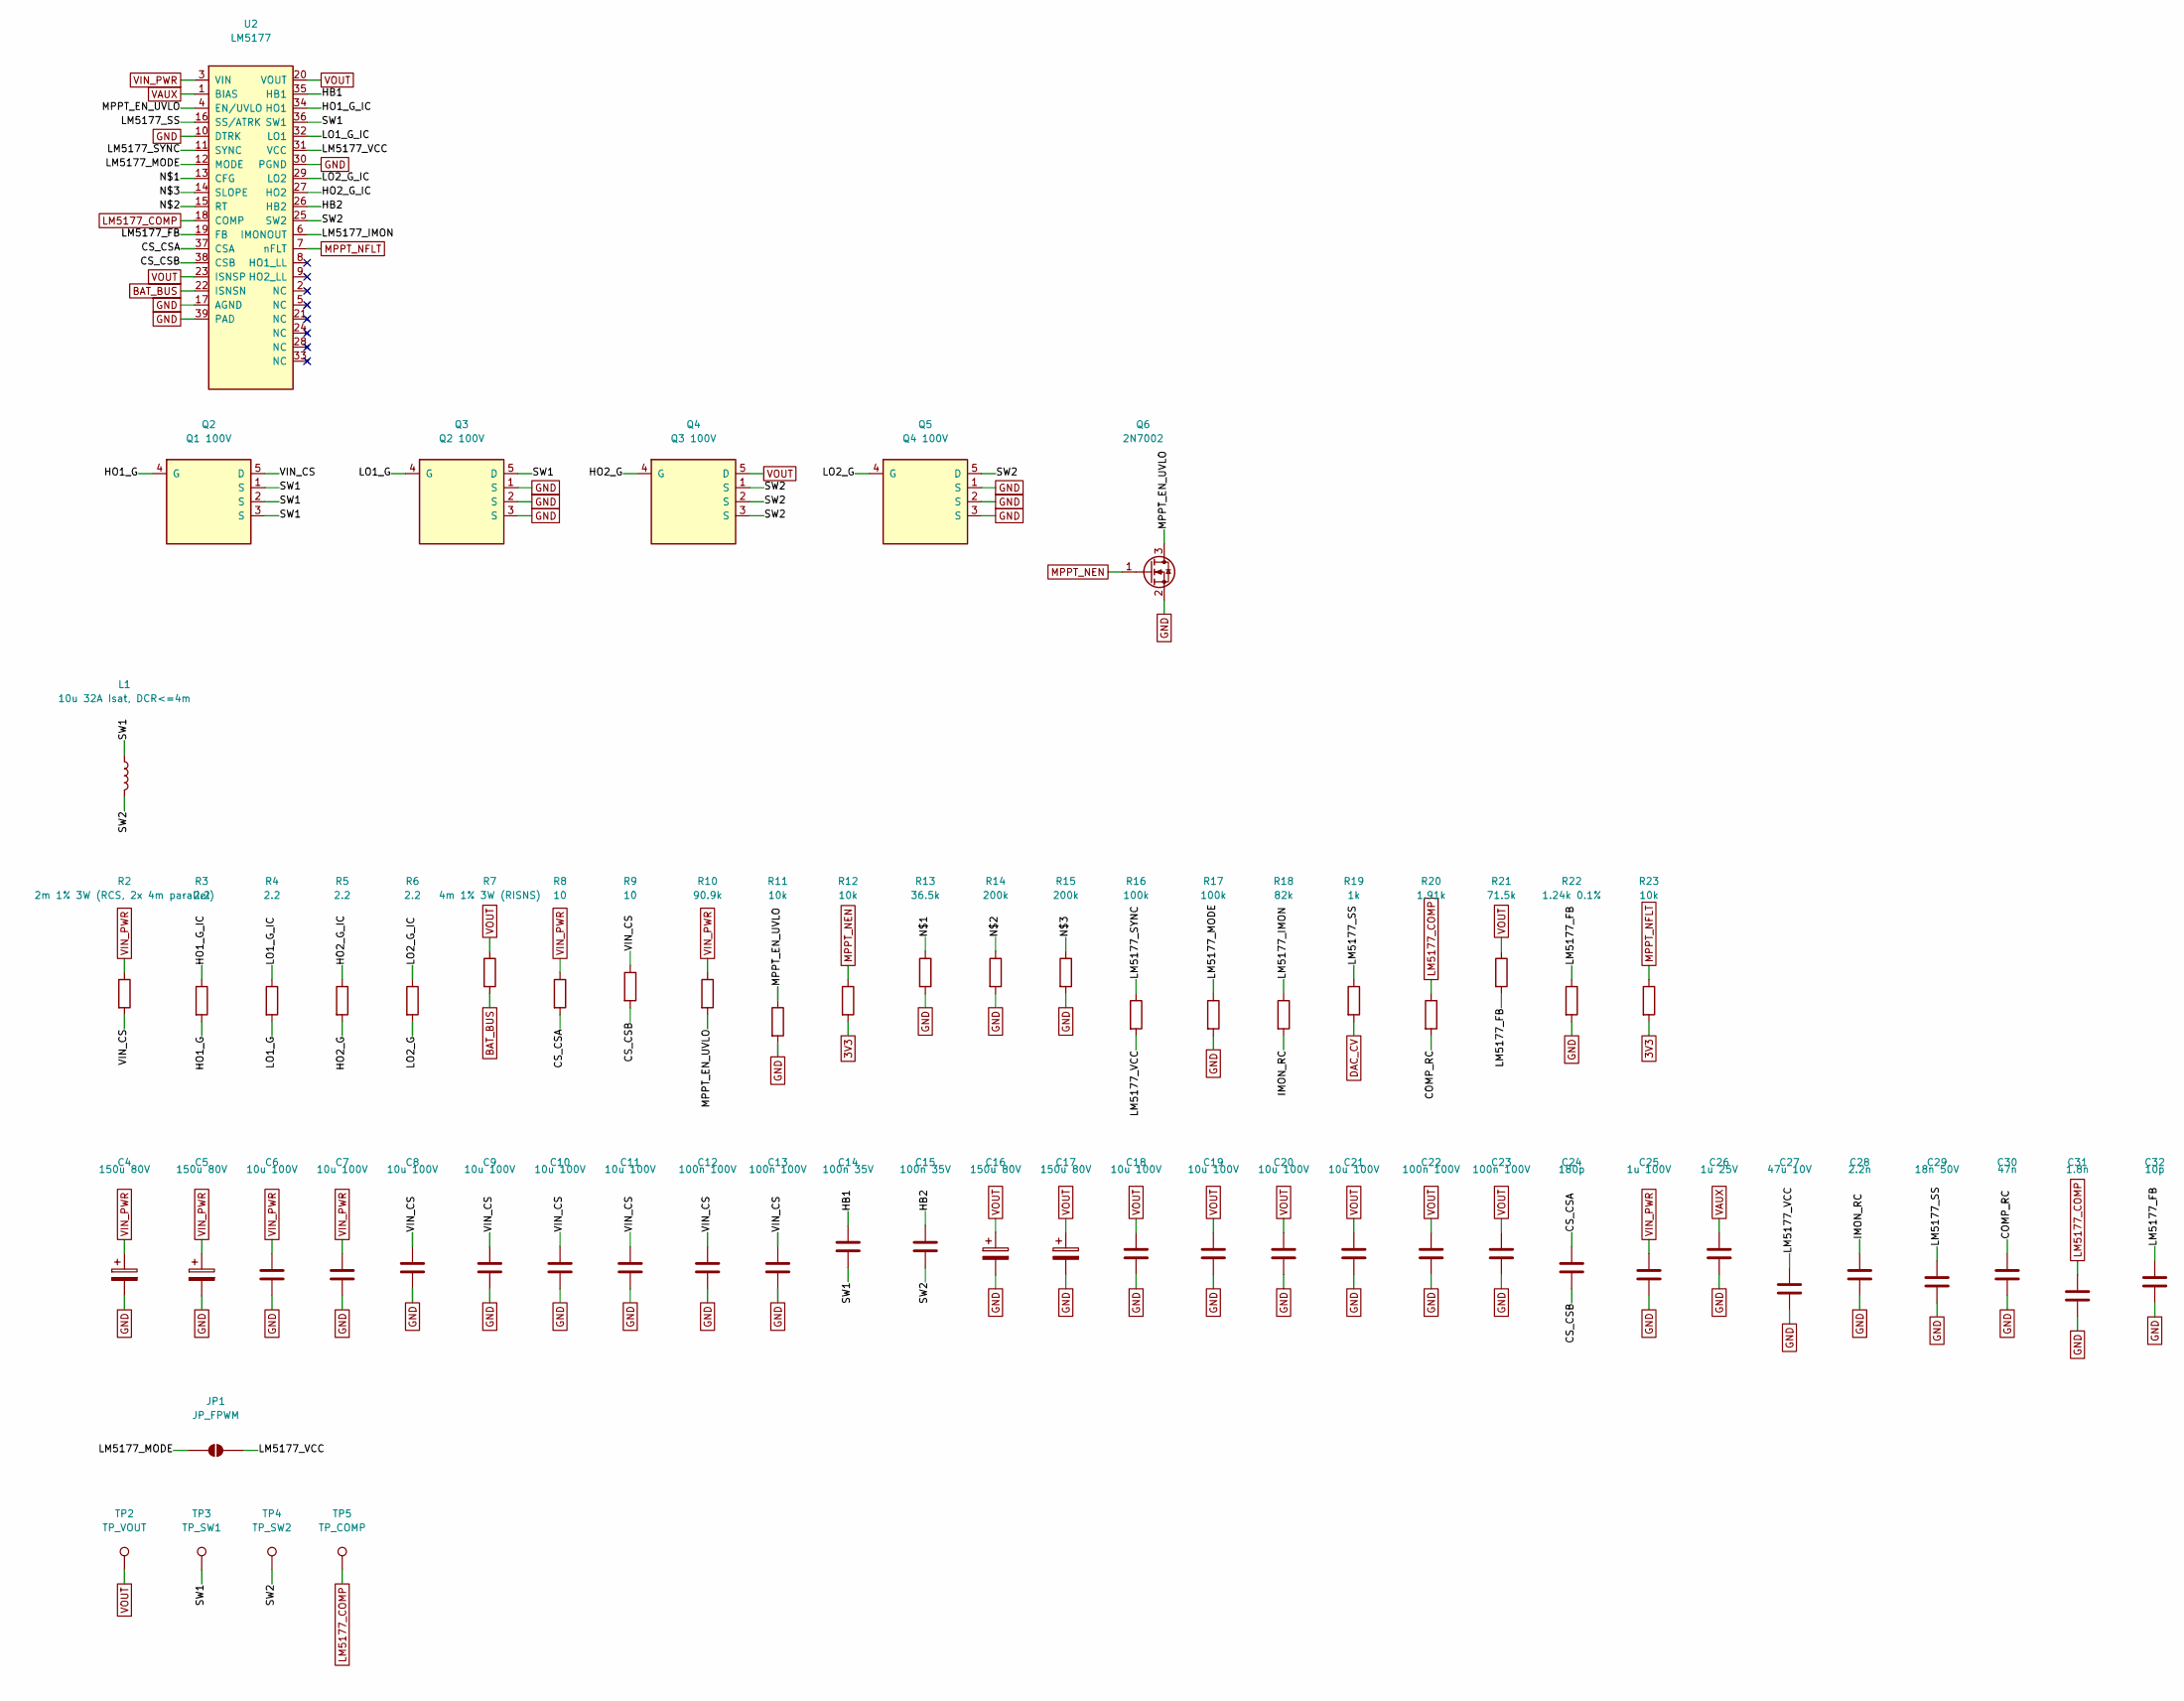
[picture p42: schematic mppt_controller_mppt_stage.kicad_sch, mppt_stage]

Parts:
C4, C5, C16, C17: 150u 80V; CP_Elec_10x10.5
C6, C7, C8, C9, C10, C11, C18, C19, C20, C21: 10u 100V; C_1210_3225Metric
C12, C13, C22, C23: 100n 100V; C_0805_2012Metric
C14, C15: 100n 35V; C_0603_1608Metric
C24: 180p; C_0603_1608Metric
C25: 1u 100V; C_0805_2012Metric
C26: 1u 25V; C_0603_1608Metric
C27: 47u 10V; C_1206_3216Metric
C28: 2.2n; C_0603_1608Metric
C29: 18n 50V; C_0603_1608Metric
C30: 47n; C_0603_1608Metric
C31: 1.8n; C_0603_1608Metric
C32: 10p; C_0603_1608Metric
JP1: JP_FPWM; SolderJumper-2_P1.3mm_Open_Pad1.0x1.5mm
L1: 10u 32A Isat, DCR<=4m; L_Toroid_Vertical_L24.6mm_W15.5mm_P11.44mm_Pulse_KM-4
Q2: Q1 100V; TDSON-8-1
Q3: Q2 100V; TDSON-8-1
Q4: Q3 100V; TDSON-8-1
Q5: Q4 100V; TDSON-8-1
Q6: 2N7002; SOT-23
R2: 2m 1% 3W (RCS, 2x 4m parallel); R_2512_6332Metric
R3, R4, R5, R6: 2.2; R_0603_1608Metric
R7: 4m 1% 3W (RISNS); R_2512_6332Metric
R8, R9: 10; R_0603_1608Metric
R10: 90.9k; R_0603_1608Metric
R11, R12, R23: 10k; R_0603_1608Metric
R13: 36.5k; R_0603_1608Metric
R14, R15: 200k; R_0603_1608Metric
R16, R17: 100k; R_0603_1608Metric
R18: 82k; R_0603_1608Metric
R19: 1k; R_0603_1608Metric
R20: 1.91k; R_0603_1608Metric
R21: 71.5k; R_0603_1608Metric
R22: 1.24k 0.1%; R_0603_1608Metric
TP2: TP_VOUT; TestPoint_Pad_D1.5mm
TP3: TP_SW1; TestPoint_Pad_D1.5mm
TP4: TP_SW2; TestPoint_Pad_D1.5mm
TP5: TP_COMP; TestPoint_Pad_D1.5mm
U2: LM5177; HTSSOP-38-1EP_4.4x9.7mm_P0.5mm_EP2.74x4.75mm

Connections:
3V3: R12.2, R23.2; also elsewhere on the board
/mppt_stage/COMP_RC: C30.1, R20.2
/mppt_stage/CS_CSA: C24.1, R8.2, U2.37 (CSA)
/mppt_stage/CS_CSB: C24.2, R9.2, U2.38 (CSB)
/mppt_stage/HB1: C14.1, U2.35 (HB1)
/mppt_stage/HB2: C15.1, U2.26 (HB2)
/mppt_stage/HO1_G: Q2.4 (G), R3.2
/mppt_stage/HO1_G_IC: R3.1, U2.34 (HO1)
/mppt_stage/HO2_G: Q4.4 (G), R5.2
/mppt_stage/HO2_G_IC: R5.1, U2.27 (HO2)
/mppt_stage/IMON_RC: C28.1, R18.2
/mppt_stage/LM5177_FB: C32.1, R21.2, R22.1, U2.19 (FB)
/mppt_stage/LM5177_IMON: R18.1, U2.6 (IMONOUT)
/mppt_stage/LM5177_MODE: JP1.1 (A), R17.1, U2.12 (MODE)
/mppt_stage/LM5177_SS: C29.1, R19.1, U2.16 (SS/ATRK)
/mppt_stage/LM5177_SYNC: R16.1, U2.11 (SYNC)
/mppt_stage/LM5177_VCC: C27.1, JP1.2 (B), R16.2, U2.31 (VCC)
/mppt_stage/LO1_G: Q3.4 (G), R4.2
/mppt_stage/LO1_G_IC: R4.1, U2.32 (LO1)
/mppt_stage/LO2_G: Q5.4 (G), R6.2
/mppt_stage/LO2_G_IC: R6.1, U2.29 (LO2)
/mppt_stage/MPPT_EN_UVLO: Q6.3 (D), R10.2, R11.1, U2.4 (EN/UVLO)
/mppt_stage/N$1: R13.1, U2.13 (CFG)
/mppt_stage/N$2: R14.1, U2.15 (RT)
/mppt_stage/N$3: R15.1, U2.14 (SLOPE)
/mppt_stage/SW1: C14.2, L1.1, Q2.1 (S), Q2.2 (S), Q2.3 (S), Q3.5 (D), TP3.1, U2.36 (SW1)
/mppt_stage/SW2: C15.2, L1.2, Q4.1 (S), Q4.2 (S), Q4.3 (S), Q5.5 (D), TP4.1, U2.25 (SW2)
/mppt_stage/VIN_CS: C8.1, C9.1, C10.1, C11.1, C12.1, C13.1, Q2.5 (D), R2.2, R9.1
BAT_BUS: R7.2, U2.22 (ISNSN); also elsewhere on the board
DAC_CV: R19.2; also elsewhere on the board
GND: C4.2, C5.2, C6.2, C7.2, C8.2, C9.2, C10.2, C11.2, C12.2, C13.2, C16.2, C17.2, C18.2, C19.2, C20.2, C21.2, C22.2, C23.2, C25.2, C26.2, C27.2, C28.2, C29.2, C30.2, C31.2, C32.2, Q3.1 (S), Q3.2 (S), Q3.3 (S), Q5.1 (S), Q5.2 (S), Q5.3 (S), Q6.2 (S), R11.2, R13.2, R14.2, R15.2, R17.2, R22.2, U2.10 (DTRK), U2.17 (AGND), U2.30 (PGND), U2.39 (PAD); also elsewhere on the board
LM5177_COMP: C31.1, R20.1, TP5.1, U2.18 (COMP); also elsewhere on the board
MPPT_NEN: Q6.1 (G), R12.1; also elsewhere on the board
MPPT_NFLT: R23.1, U2.7 (nFLT); also elsewhere on the board
VAUX: C26.1, U2.1 (BIAS); also elsewhere on the board
VIN_PWR: C4.1, C5.1, C6.1, C7.1, C25.1, R2.1, R8.1, R10.1, U2.3 (VIN); also elsewhere on the board
VOUT: C16.1, C17.1, C18.1, C19.1, C20.1, C21.1, C22.1, C23.1, Q4.5 (D), R7.1, R21.1, TP2.1, U2.20 (VOUT), U2.23 (ISNSP); also elsewhere on the board

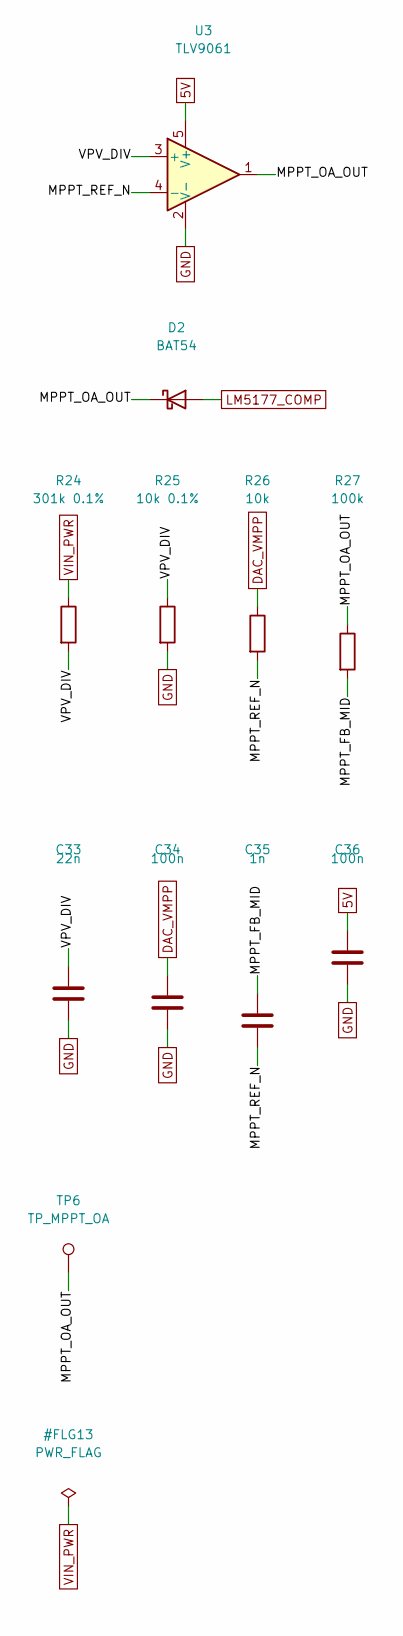
[picture p43: schematic mppt_controller_mppt_loop.kicad_sch, mppt_loop]

Parts:
C33: 22n; C_0603_1608Metric
C34, C36: 100n; C_0603_1608Metric
C35: 1n; C_0603_1608Metric
D2: BAT54; D_SOD-123
R24: 301k 0.1%; R_0603_1608Metric
R25: 10k 0.1%; R_0603_1608Metric
R26: 10k; R_0603_1608Metric
R27: 100k; R_0603_1608Metric
TP6: TP_MPPT_OA; TestPoint_Pad_D1.5mm
U3: TLV9061; SOT-23-5

Connections:
5V: C36.1, U3.5 (V+); also elsewhere on the board
/mppt_loop/MPPT_FB_MID: C35.1, R27.2
/mppt_loop/MPPT_OA_OUT: D2.1 (K), R27.1, TP6.1, U3.1
/mppt_loop/MPPT_REF_N: C35.2, R26.2, U3.4 (-)
/mppt_loop/VPV_DIV: C33.1, R24.2, R25.1, U3.3 (+)
DAC_VMPP: C34.1, R26.1; also elsewhere on the board
GND: C33.2, C34.2, C36.2, R25.2, U3.2 (V-); also elsewhere on the board
LM5177_COMP: D2.2 (A); also elsewhere on the board
VIN_PWR: R24.1; also elsewhere on the board

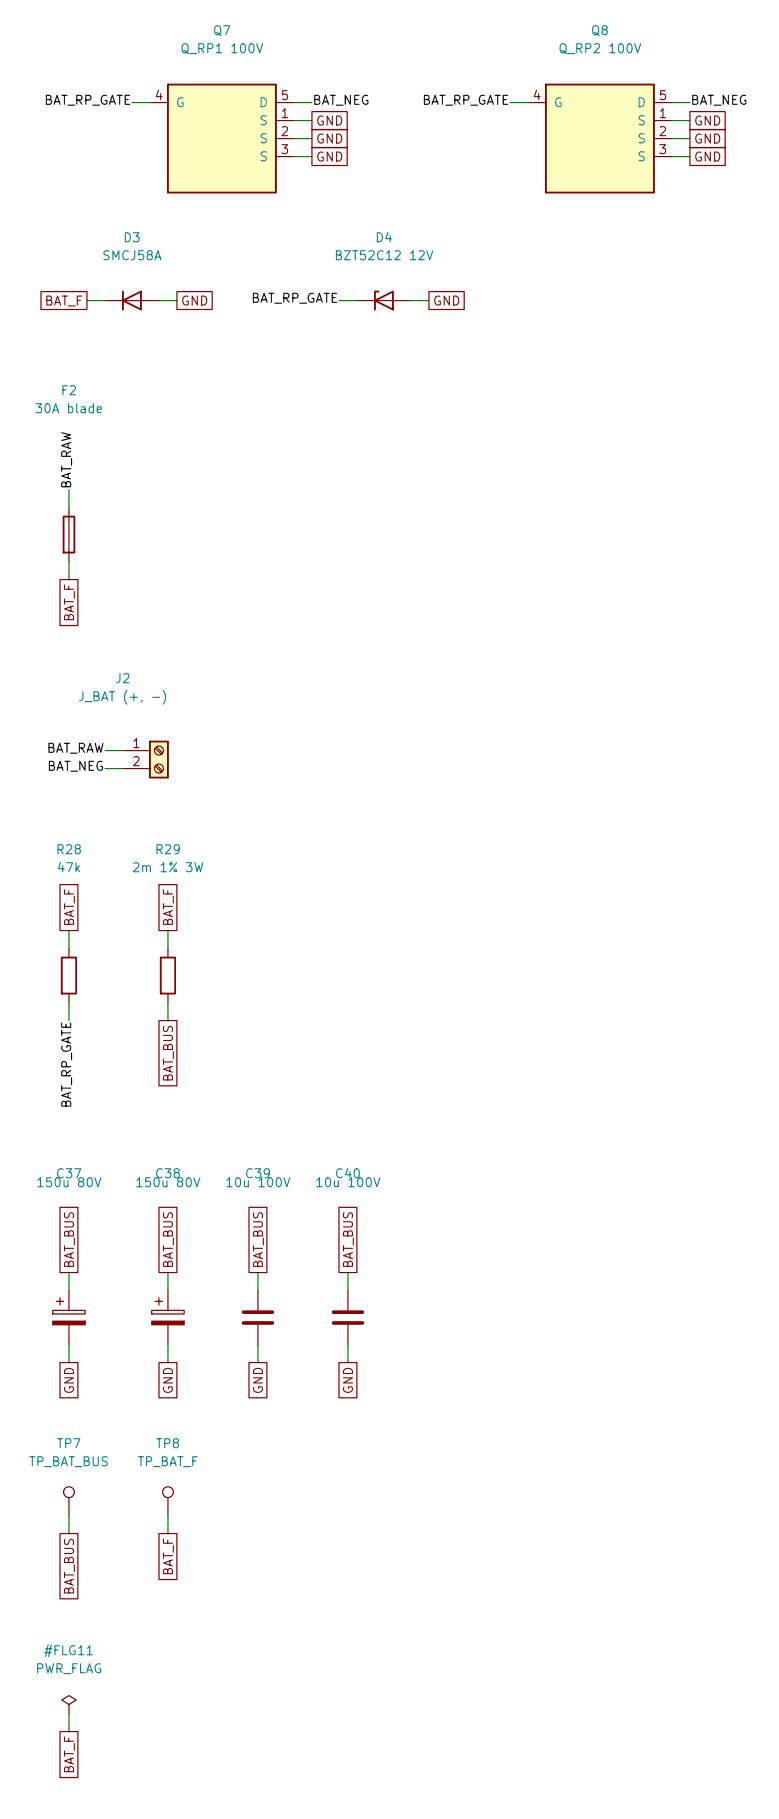
[picture p44: schematic mppt_controller_battery.kicad_sch, battery]

Parts:
C37, C38: 150u 80V; CP_Elec_10x10.5
C39, C40: 10u 100V; C_1210_3225Metric
D3: SMCJ58A; D_SMC
D4: BZT52C12 12V; D_SOD-123
F2: 30A blade; Fuseholder_Blade_ATO_Littelfuse_Pudenz_2_Pin
J2: J_BAT (+, -); TerminalBlock_Phoenix_MKDS-3-2-5.08_1x02_P5.08mm_Horizontal
Q7: Q_RP1 100V; TDSON-8-1
Q8: Q_RP2 100V; TDSON-8-1
R28: 47k; R_1206_3216Metric
R29: 2m 1% 3W; R_2512_6332Metric
TP7: TP_BAT_BUS; TestPoint_Pad_D1.5mm
TP8: TP_BAT_F; TestPoint_Pad_D1.5mm

Connections:
/battery/BAT_NEG: J2.2, Q7.5 (D), Q8.5 (D)
/battery/BAT_RAW: F2.1, J2.1
/battery/BAT_RP_GATE: D4.1 (K), Q7.4 (G), Q8.4 (G), R28.2
BAT_BUS: C37.1, C38.1, C39.1, C40.1, R29.2, TP7.1; also elsewhere on the board
BAT_F: D3.1 (K), F2.2, R28.1, R29.1, TP8.1; also elsewhere on the board
GND: C37.2, C38.2, C39.2, C40.2, D3.2 (A), D4.2 (A), Q7.1 (S), Q7.2 (S), Q7.3 (S), Q8.1 (S), Q8.2 (S), Q8.3 (S); also elsewhere on the board

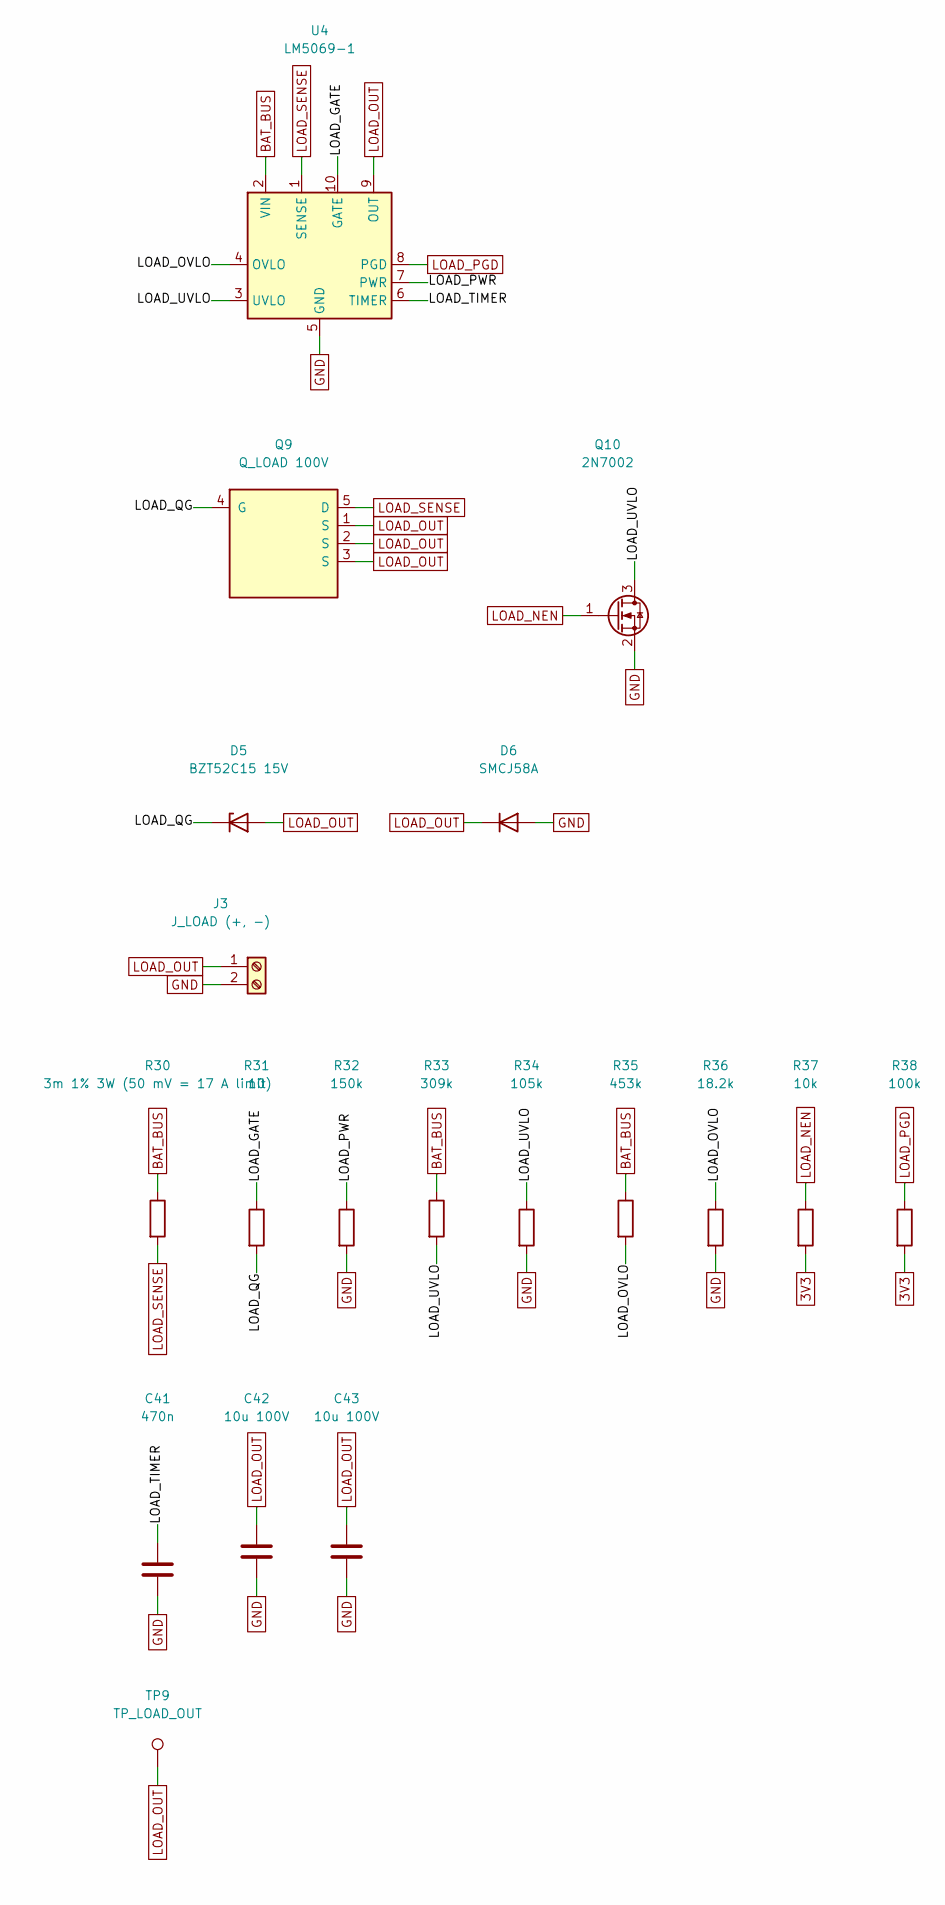
[picture p45: schematic mppt_controller_load_switch.kicad_sch, load_switch]

Parts:
C41: 470n; C_0603_1608Metric
C42, C43: 10u 100V; C_1210_3225Metric
D5: BZT52C15 15V; D_SOD-123
D6: SMCJ58A; D_SMC
J3: J_LOAD (+, -); TerminalBlock_Phoenix_MKDS-3-2-5.08_1x02_P5.08mm_Horizontal
Q9: Q_LOAD 100V; TDSON-8-1
Q10: 2N7002; SOT-23
R30: 3m 1% 3W (50 mV = 17 A limit); R_2512_6332Metric
R31: 10; R_0603_1608Metric
R32: 150k; R_0603_1608Metric
R33: 309k; R_0603_1608Metric
R34: 105k; R_0603_1608Metric
R35: 453k; R_0603_1608Metric
R36: 18.2k; R_0603_1608Metric
R37: 10k; R_0603_1608Metric
R38: 100k; R_0603_1608Metric
TP9: TP_LOAD_OUT; TestPoint_Pad_D1.5mm
U4: LM5069-1; MSOP-10_3x3mm_P0.5mm

Connections:
3V3: R37.2, R38.2; also elsewhere on the board
/load_switch/LOAD_GATE: R31.1, U4.10 (GATE)
/load_switch/LOAD_OVLO: R35.2, R36.1, U4.4 (OVLO)
/load_switch/LOAD_PWR: R32.1, U4.7 (PWR)
/load_switch/LOAD_QG: D5.1 (K), Q9.4 (G), R31.2
/load_switch/LOAD_TIMER: C41.1, U4.6 (TIMER)
/load_switch/LOAD_UVLO: Q10.3 (D), R33.2, R34.1, U4.3 (UVLO)
BAT_BUS: R30.1, R33.1, R35.1, U4.2 (VIN); also elsewhere on the board
GND: C41.2, C42.2, C43.2, D6.2 (A), J3.2, Q10.2 (S), R32.2, R34.2, R36.2, U4.5 (GND); also elsewhere on the board
LOAD_NEN: Q10.1 (G), R37.1; also elsewhere on the board
LOAD_OUT: C42.1, C43.1, D5.2 (A), D6.1 (K), J3.1, Q9.1 (S), Q9.2 (S), Q9.3 (S), TP9.1, U4.9 (OUT); also elsewhere on the board
LOAD_PGD: R38.1, U4.8 (PGD); also elsewhere on the board
LOAD_SENSE: Q9.5 (D), R30.2, U4.1 (SENSE); also elsewhere on the board

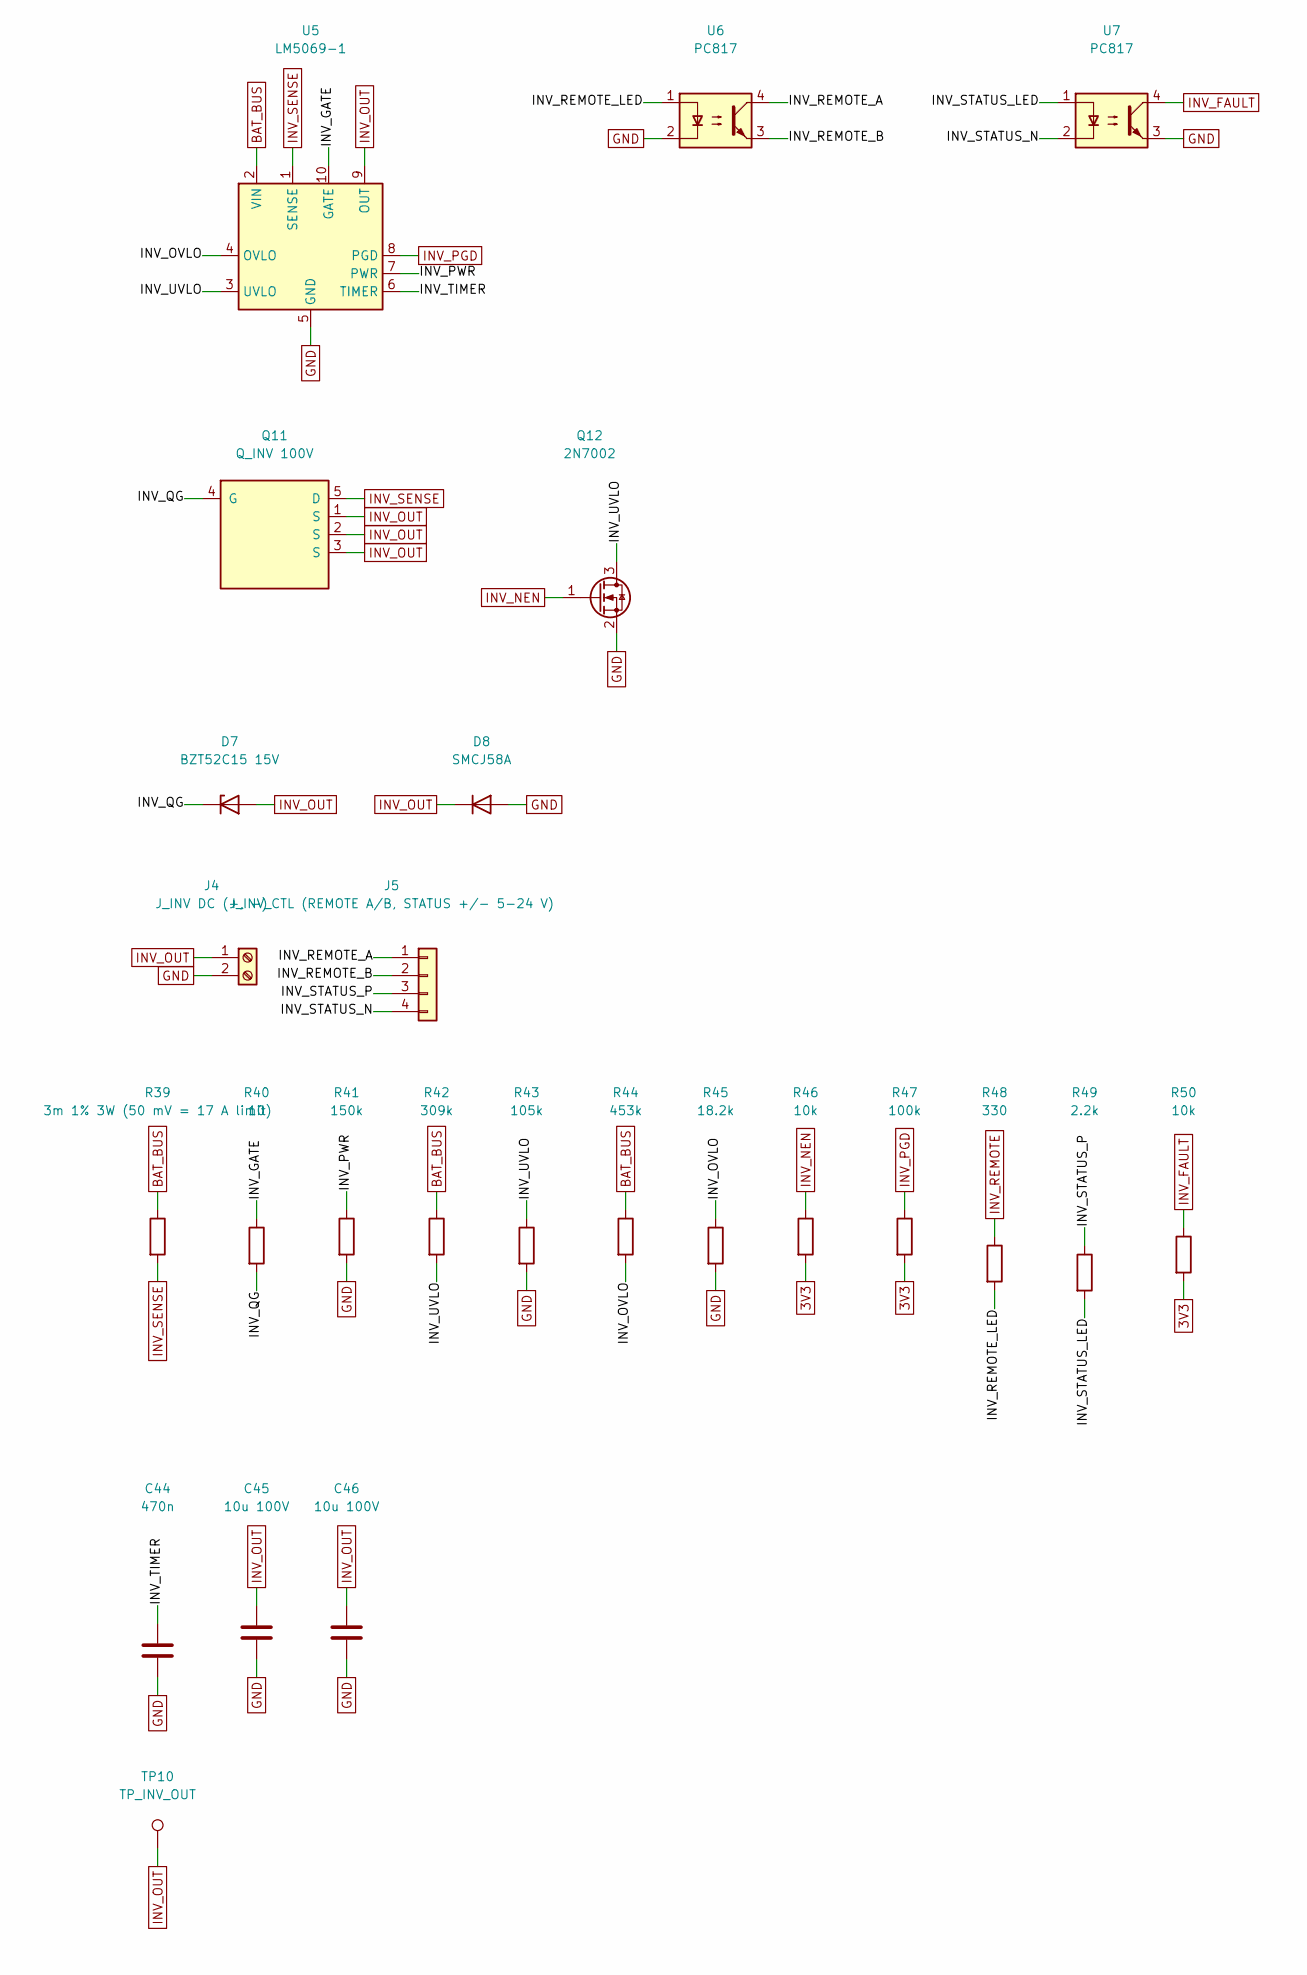
[picture p46: schematic mppt_controller_inverter_feed.kicad_sch, inverter_feed]

Parts:
C44: 470n; C_0603_1608Metric
C45, C46: 10u 100V; C_1210_3225Metric
D7: BZT52C15 15V; D_SOD-123
D8: SMCJ58A; D_SMC
J4: J_INV DC (+, -); TerminalBlock_Phoenix_MKDS-3-2-5.08_1x02_P5.08mm_Horizontal
J5: J_INV_CTL (REMOTE A/B, STATUS +/- 5-24 V); TerminalBlock_Phoenix_PT-1,5-4-3.5-H_1x04_P3.50mm_Horizontal
Q11: Q_INV 100V; TDSON-8-1
Q12: 2N7002; SOT-23
R39: 3m 1% 3W (50 mV = 17 A limit); R_2512_6332Metric
R40: 10; R_0603_1608Metric
R41: 150k; R_0603_1608Metric
R42: 309k; R_0603_1608Metric
R43: 105k; R_0603_1608Metric
R44: 453k; R_0603_1608Metric
R45: 18.2k; R_0603_1608Metric
R46, R50: 10k; R_0603_1608Metric
R47: 100k; R_0603_1608Metric
R48: 330; R_0603_1608Metric
R49: 2.2k; R_0603_1608Metric
TP10: TP_INV_OUT; TestPoint_Pad_D1.5mm
U5: LM5069-1; MSOP-10_3x3mm_P0.5mm
U6, U7: PC817; SMDIP-4_W9.53mm

Connections:
3V3: R46.2, R47.2, R50.2; also elsewhere on the board
/inverter_feed/INV_GATE: R40.1, U5.10 (GATE)
/inverter_feed/INV_OVLO: R44.2, R45.1, U5.4 (OVLO)
/inverter_feed/INV_PWR: R41.1, U5.7 (PWR)
/inverter_feed/INV_QG: D7.1 (K), Q11.4 (G), R40.2
/inverter_feed/INV_REMOTE_A: J5.1, U6.4
/inverter_feed/INV_REMOTE_B: J5.2, U6.3
/inverter_feed/INV_REMOTE_LED: R48.2, U6.1
/inverter_feed/INV_STATUS_LED: R49.2, U7.1
/inverter_feed/INV_STATUS_N: J5.4, U7.2
/inverter_feed/INV_STATUS_P: J5.3, R49.1
/inverter_feed/INV_TIMER: C44.1, U5.6 (TIMER)
/inverter_feed/INV_UVLO: Q12.3 (D), R42.2, R43.1, U5.3 (UVLO)
BAT_BUS: R39.1, R42.1, R44.1, U5.2 (VIN); also elsewhere on the board
GND: C44.2, C45.2, C46.2, D8.2 (A), J4.2, Q12.2 (S), R41.2, R43.2, R45.2, U5.5 (GND), U6.2, U7.3; also elsewhere on the board
INV_FAULT: R50.1, U7.4; also elsewhere on the board
INV_NEN: Q12.1 (G), R46.1; also elsewhere on the board
INV_OUT: C45.1, C46.1, D7.2 (A), D8.1 (K), J4.1, Q11.1 (S), Q11.2 (S), Q11.3 (S), TP10.1, U5.9 (OUT); also elsewhere on the board
INV_PGD: R47.1, U5.8 (PGD); also elsewhere on the board
INV_REMOTE: R48.1; also elsewhere on the board
INV_SENSE: Q11.5 (D), R39.2, U5.1 (SENSE); also elsewhere on the board

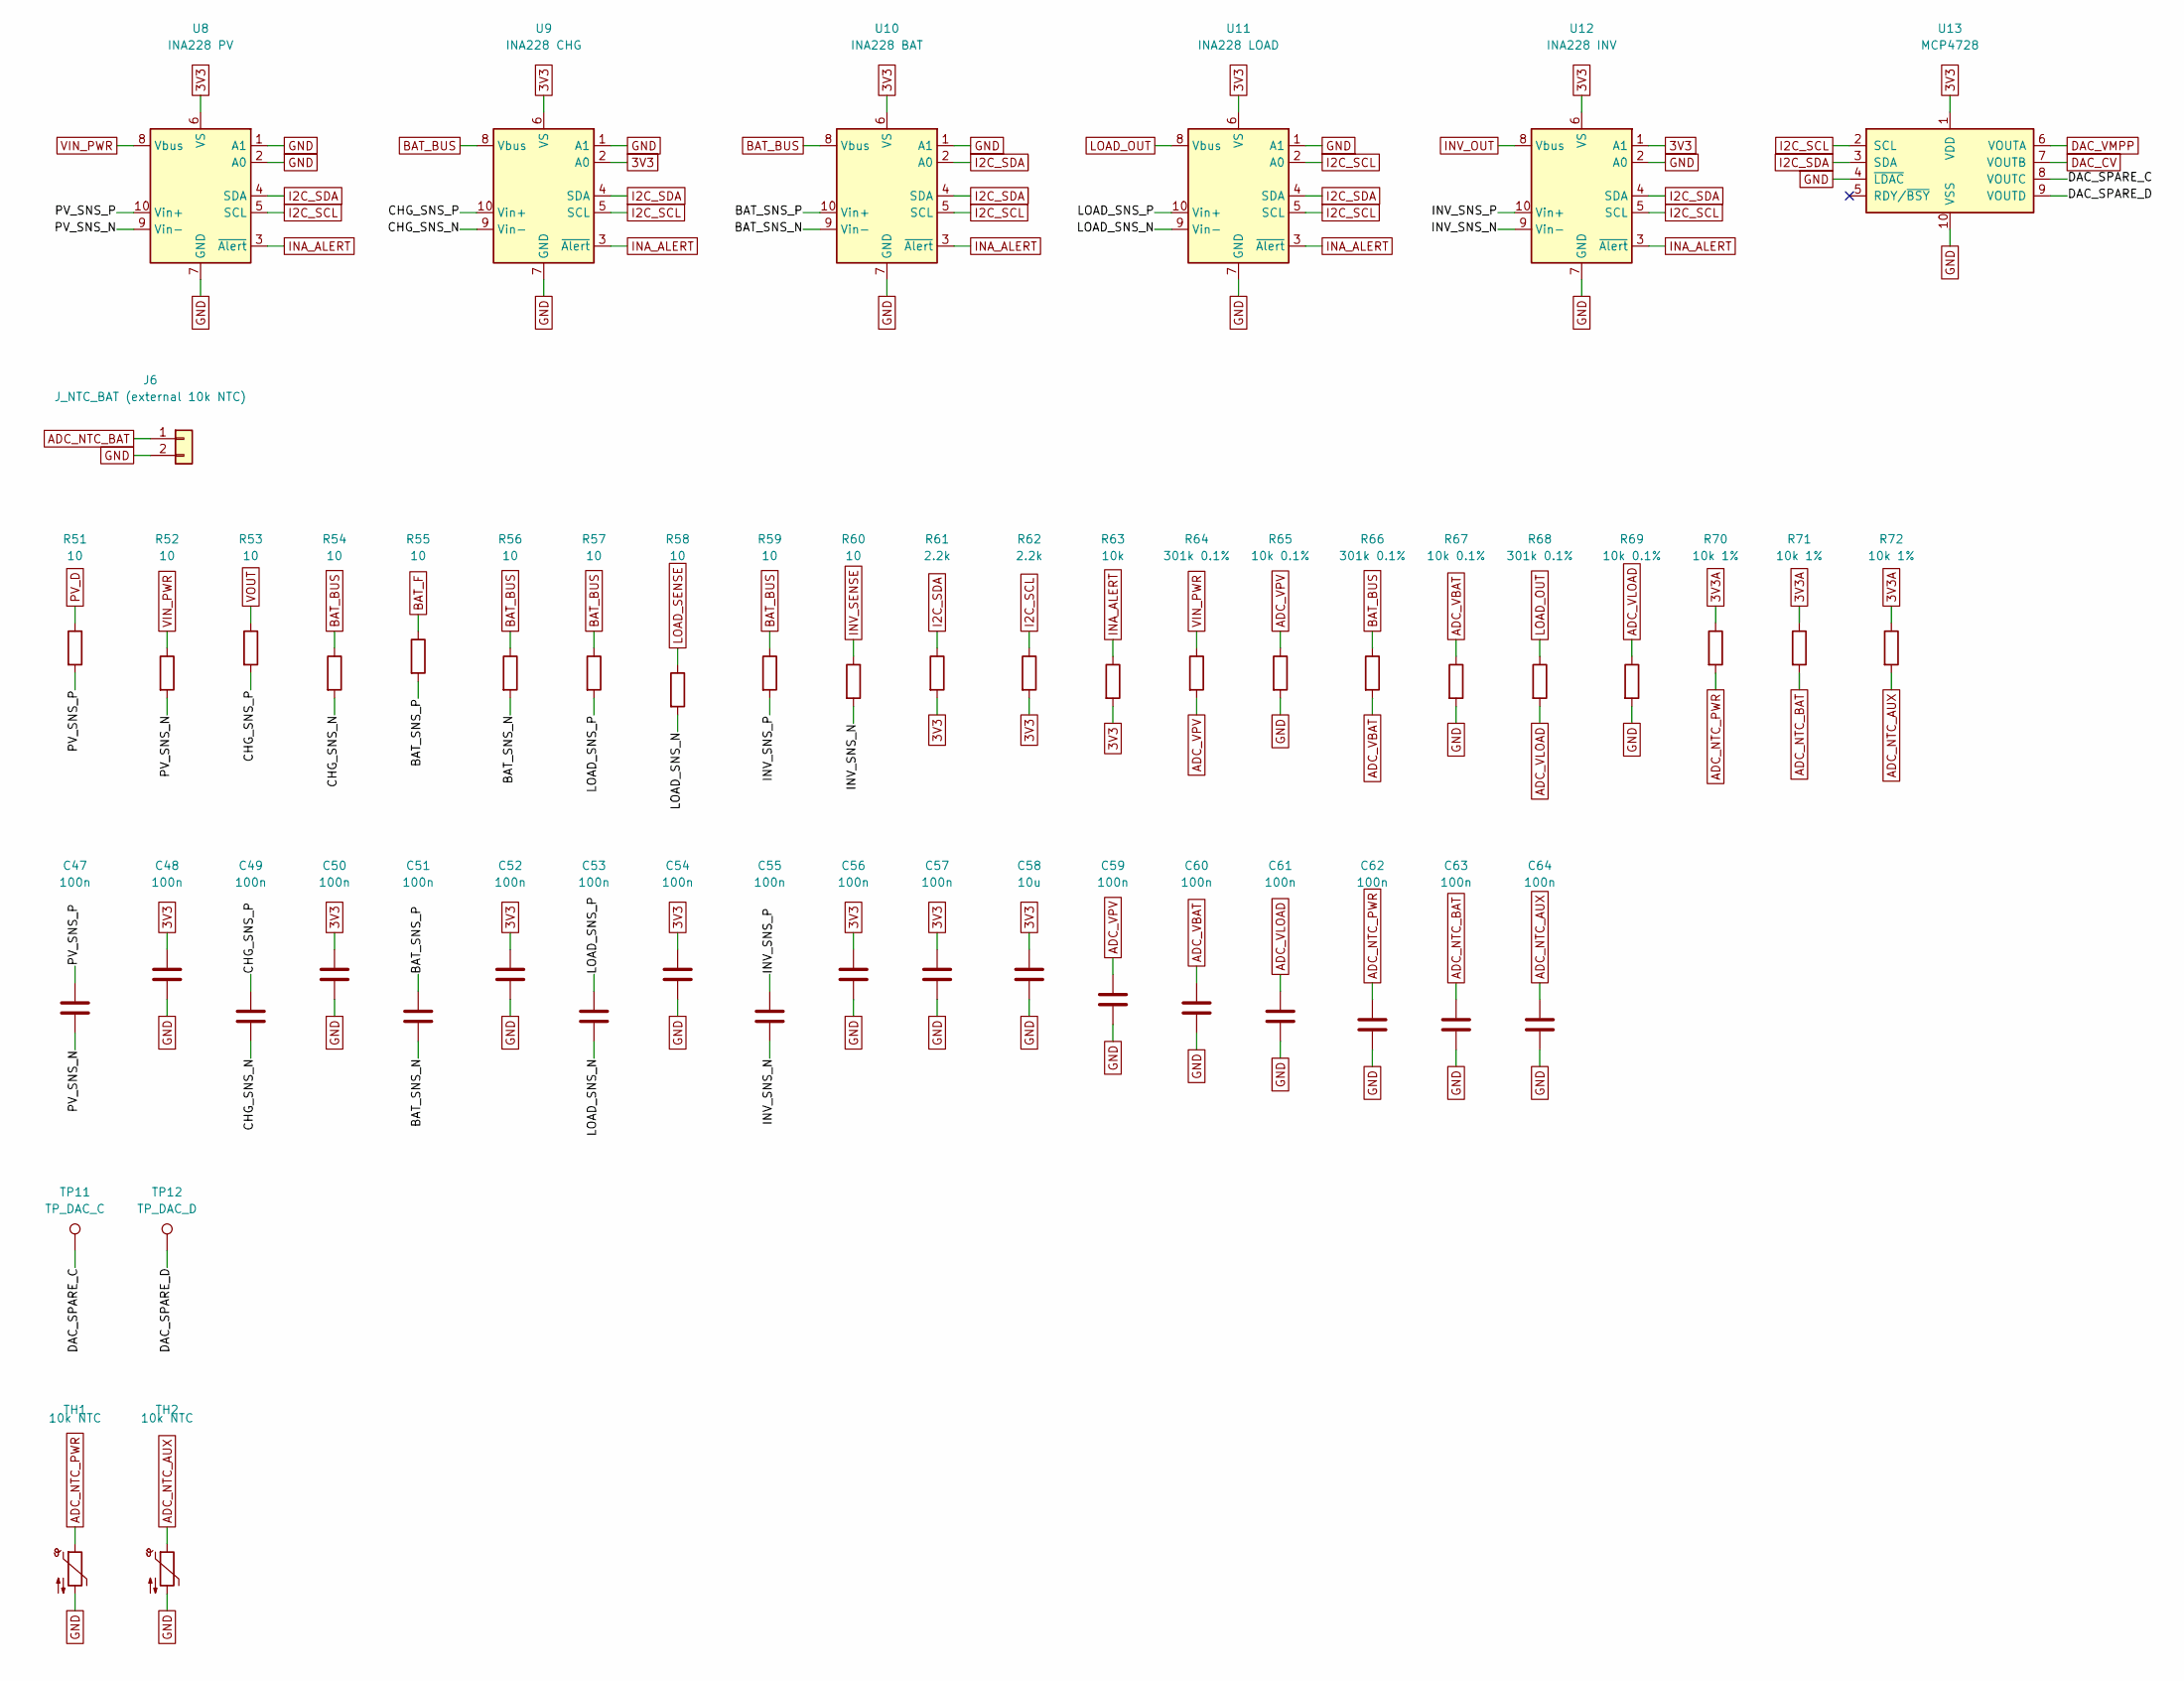
[picture p47: schematic mppt_controller_sensing.kicad_sch, sensing]

Parts:
C47, C48, C49, C50, C51, C52, C53, C54, C55, C56, C57, C59, C60, C61, C62, C63, C64: 100n; C_0603_1608Metric
C58: 10u; C_0805_2012Metric
J6: J_NTC_BAT (external 10k NTC); PinHeader_1x02_P2.54mm_Vertical
R51, R52, R53, R54, R55, R56, R57, R58, R59, R60: 10; R_0603_1608Metric
R61, R62: 2.2k; R_0603_1608Metric
R63: 10k; R_0603_1608Metric
R64, R66, R68: 301k 0.1%; R_0603_1608Metric
R65, R67, R69: 10k 0.1%; R_0603_1608Metric
R70, R71, R72: 10k 1%; R_0603_1608Metric
TH1, TH2: 10k NTC; R_0603_1608Metric
TP11: TP_DAC_C; TestPoint_Pad_D1.5mm
TP12: TP_DAC_D; TestPoint_Pad_D1.5mm
U8: INA228 PV; MSOP-10_3x3mm_P0.5mm
U9: INA228 CHG; MSOP-10_3x3mm_P0.5mm
U10: INA228 BAT; MSOP-10_3x3mm_P0.5mm
U11: INA228 LOAD; MSOP-10_3x3mm_P0.5mm
U12: INA228 INV; MSOP-10_3x3mm_P0.5mm
U13: MCP4728; MSOP-10_3x3mm_P0.5mm

Connections:
3V3: C48.1, C50.1, C52.1, C54.1, C56.1, C57.1, C58.1, R61.2, R62.2, R63.2, U8.6 (VS), U9.2 (A0), U9.6 (VS), U10.6 (VS), U11.6 (VS), U12.1 (A1), U12.6 (VS), U13.1 (VDD); also elsewhere on the board
3V3A: R70.1, R71.1, R72.1; also elsewhere on the board
/sensing/BAT_SNS_N: C51.2, R56.2, U10.9 (Vin-)
/sensing/BAT_SNS_P: C51.1, R55.2, U10.10 (Vin+)
/sensing/CHG_SNS_N: C49.2, R54.2, U9.9 (Vin-)
/sensing/CHG_SNS_P: C49.1, R53.2, U9.10 (Vin+)
/sensing/DAC_SPARE_C: TP11.1, U13.8 (VOUTC)
/sensing/DAC_SPARE_D: TP12.1, U13.9 (VOUTD)
/sensing/INV_SNS_N: C55.2, R60.2, U12.9 (Vin-)
/sensing/INV_SNS_P: C55.1, R59.2, U12.10 (Vin+)
/sensing/LOAD_SNS_N: C53.2, R58.2, U11.9 (Vin-)
/sensing/LOAD_SNS_P: C53.1, R57.2, U11.10 (Vin+)
/sensing/PV_SNS_N: C47.2, R52.2, U8.9 (Vin-)
/sensing/PV_SNS_P: C47.1, R51.2, U8.10 (Vin+)
ADC_NTC_AUX: C64.1, R72.2, TH2.1; also elsewhere on the board
ADC_NTC_BAT: C63.1, J6.1, R71.2; also elsewhere on the board
ADC_NTC_PWR: C62.1, R70.2, TH1.1; also elsewhere on the board
ADC_VBAT: C60.1, R66.2, R67.1; also elsewhere on the board
ADC_VLOAD: C61.1, R68.2, R69.1; also elsewhere on the board
ADC_VPV: C59.1, R64.2, R65.1; also elsewhere on the board
BAT_BUS: R54.1, R56.1, R57.1, R59.1, R66.1, U9.8 (Vbus), U10.8 (Vbus); also elsewhere on the board
BAT_F: R55.1; also elsewhere on the board
DAC_CV: U13.7 (VOUTB); also elsewhere on the board
DAC_VMPP: U13.6 (VOUTA); also elsewhere on the board
GND: C48.2, C50.2, C52.2, C54.2, C56.2, C57.2, C58.2, C59.2, C60.2, C61.2, C62.2, C63.2, C64.2, J6.2, R65.2, R67.2, R69.2, TH1.2, TH2.2, U8.1 (A1), U8.2 (A0), U8.7 (GND), U9.1 (A1), U9.7 (GND), U10.1 (A1), U10.7 (GND), U11.1 (A1), U11.7 (GND), U12.2 (A0), U12.7 (GND), U13.4 (~LDAC), U13.10 (VSS); also elsewhere on the board
I2C_SCL: R62.1, U8.5 (SCL), U9.5 (SCL), U10.5 (SCL), U11.2 (A0), U11.5 (SCL), U12.5 (SCL), U13.2 (SCL); also elsewhere on the board
I2C_SDA: R61.1, U8.4 (SDA), U9.4 (SDA), U10.2 (A0), U10.4 (SDA), U11.4 (SDA), U12.4 (SDA), U13.3 (SDA); also elsewhere on the board
INA_ALERT: R63.1, U8.3 (~Alert), U9.3 (~Alert), U10.3 (~Alert), U11.3 (~Alert), U12.3 (~Alert); also elsewhere on the board
INV_OUT: U12.8 (Vbus); also elsewhere on the board
INV_SENSE: R60.1; also elsewhere on the board
LOAD_OUT: R68.1, U11.8 (Vbus); also elsewhere on the board
LOAD_SENSE: R58.1; also elsewhere on the board
PV_D: R51.1; also elsewhere on the board
VIN_PWR: R52.1, R64.1, U8.8 (Vbus); also elsewhere on the board
VOUT: R53.1; also elsewhere on the board
