mtilocca/mppt-controller/hardware/mppt_controller.kicad_pcb

## KiCad design hardware/mppt_controller.kicad_pcb (continued)

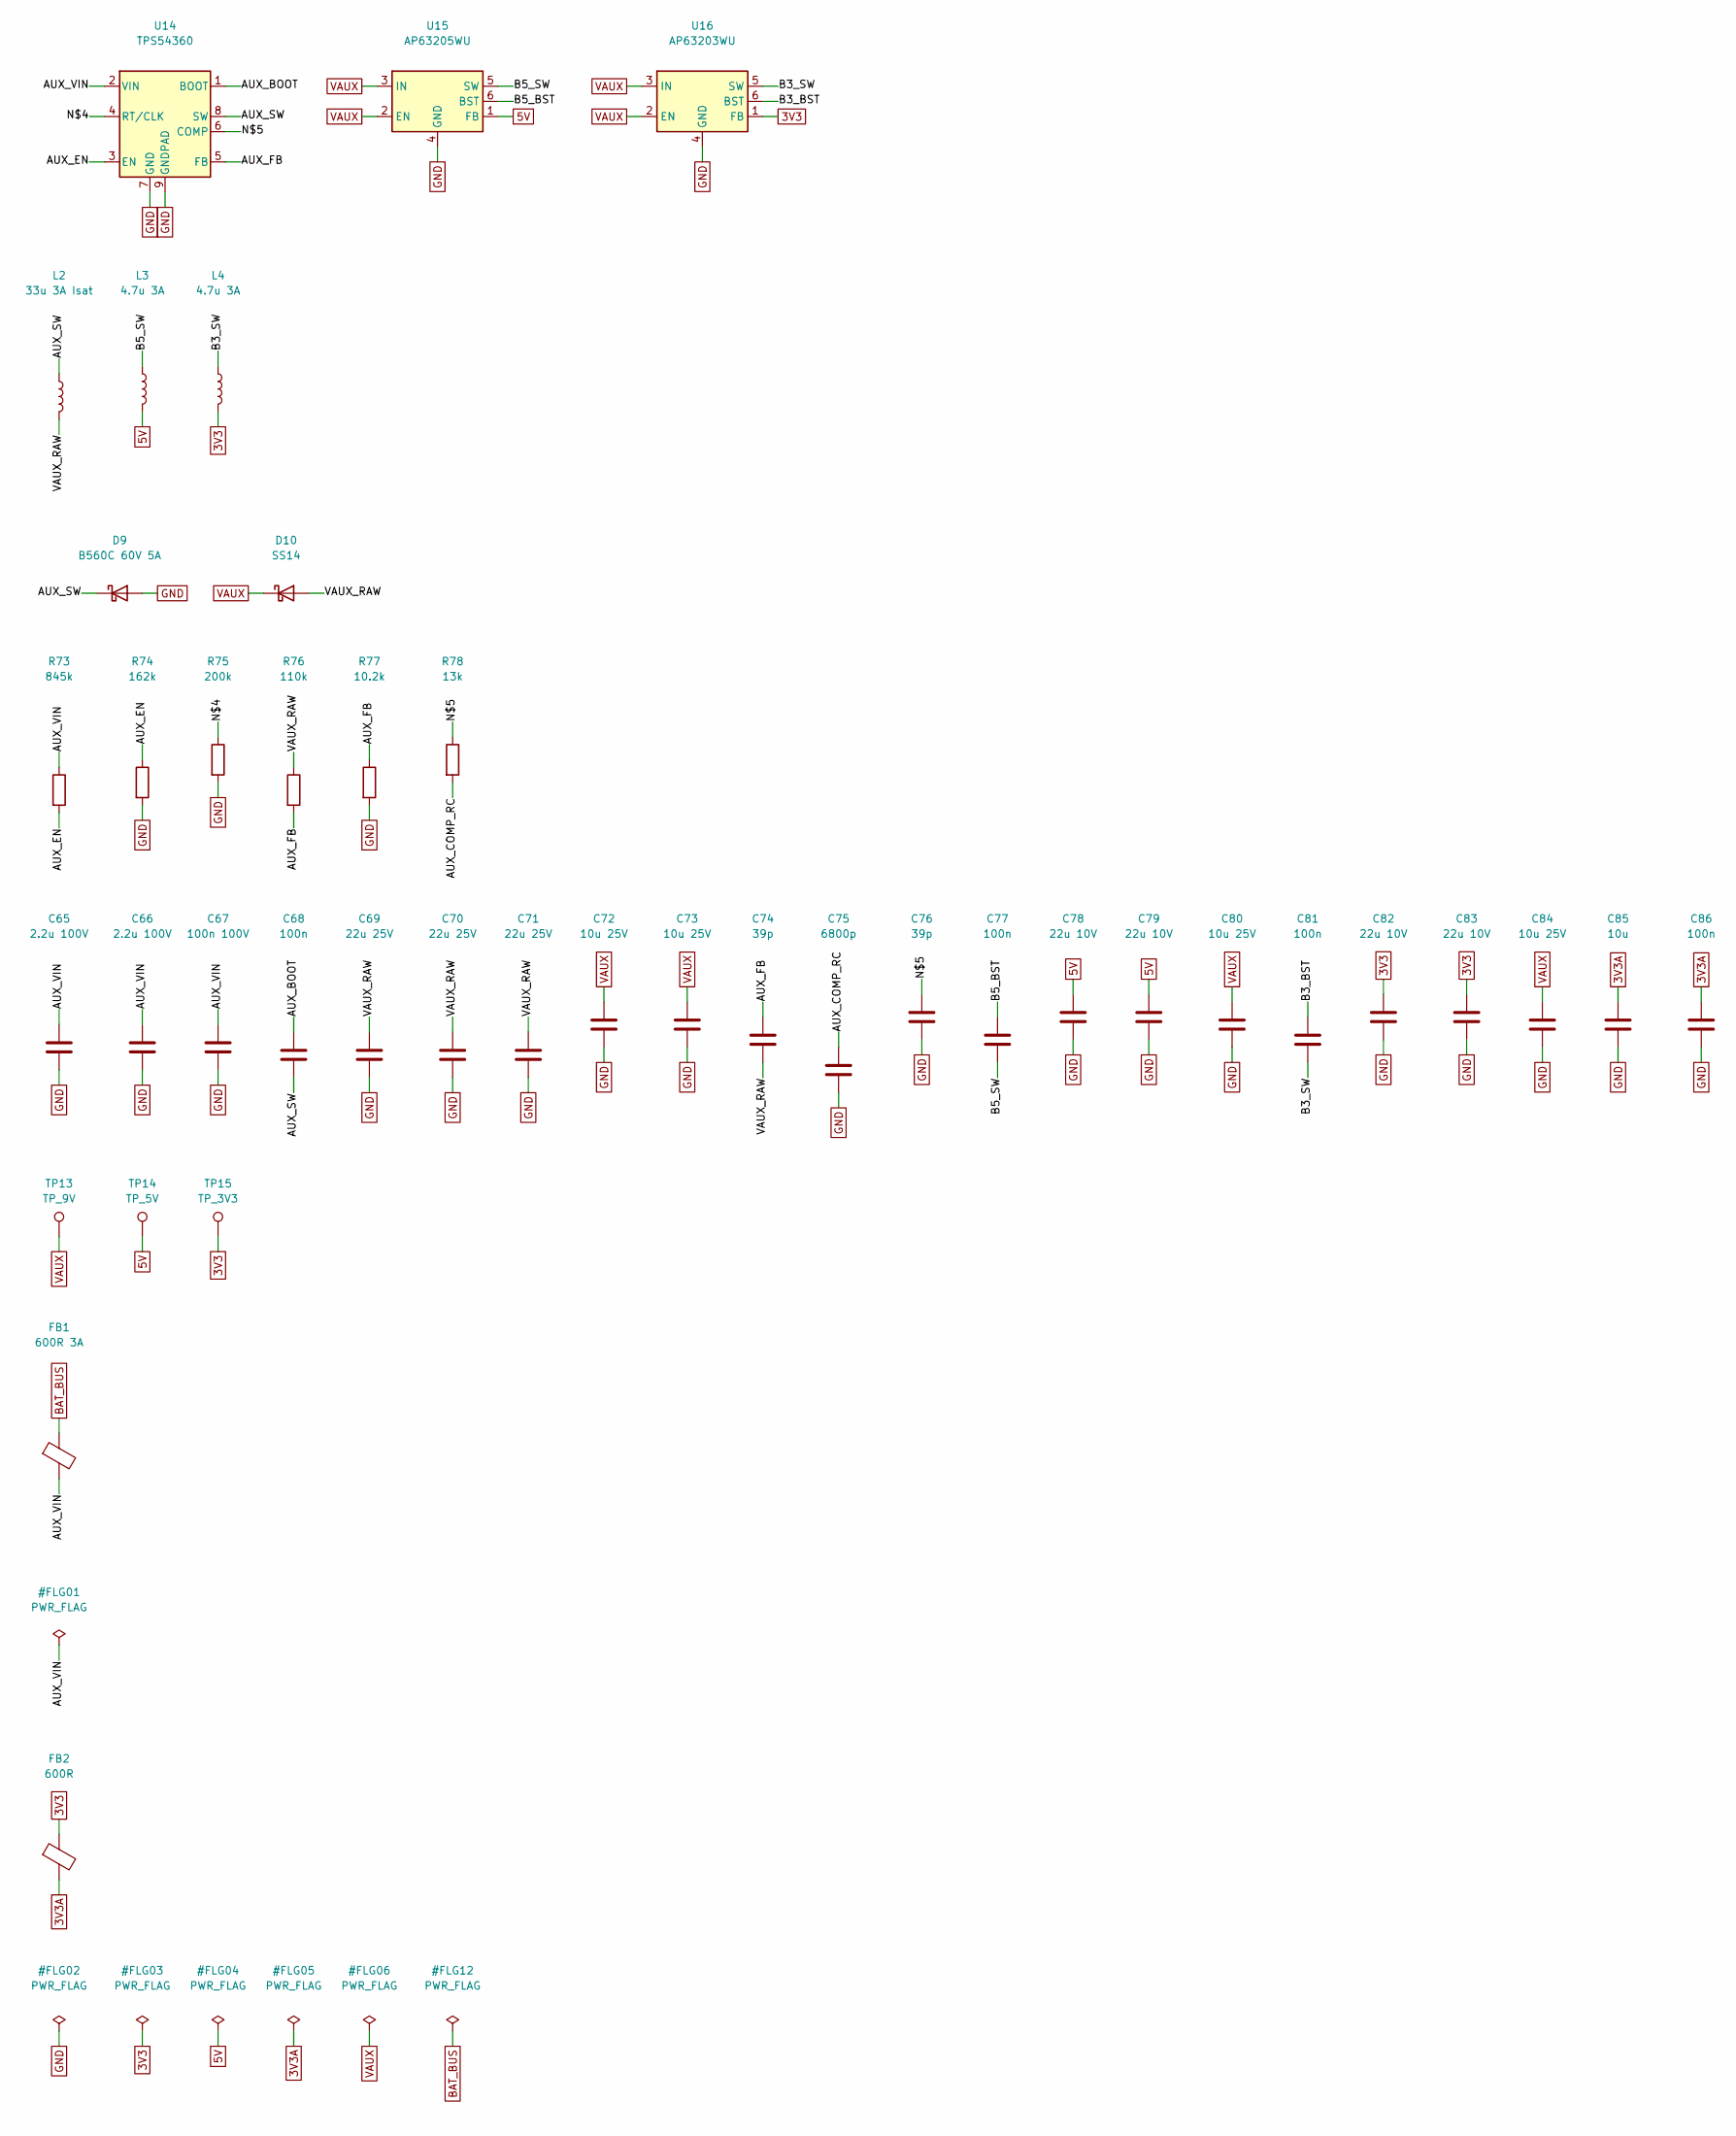
[picture p48: schematic mppt_controller_aux_power.kicad_sch, aux_power]

Parts:
C65, C66: 2.2u 100V; C_1210_3225Metric
C67: 100n 100V; C_0805_2012Metric
C68, C77, C81, C86: 100n; C_0603_1608Metric
C69, C70, C71: 22u 25V; C_1210_3225Metric
C72, C73, C80, C84: 10u 25V; C_1206_3216Metric
C74, C76: 39p; C_0603_1608Metric
C75: 6800p; C_0603_1608Metric
C78, C79, C82, C83: 22u 10V; C_1206_3216Metric
C85: 10u; C_0805_2012Metric
D9: B560C 60V 5A; D_SMC
D10: SS14; D_SMA
FB1: 600R 3A; L_1206_3216Metric
FB2: 600R; L_0603_1608Metric
L2: 33u 3A Isat; L_Bourns_SRP1245A
L3, L4: 4.7u 3A; L_Bourns_SRP5030T
R73: 845k; R_0603_1608Metric
R74: 162k; R_0603_1608Metric
R75: 200k; R_0603_1608Metric
R76: 110k; R_0603_1608Metric
R77: 10.2k; R_0603_1608Metric
R78: 13k; R_0603_1608Metric
TP13: TP_9V; TestPoint_Pad_D1.5mm
TP14: TP_5V; TestPoint_Pad_D1.5mm
TP15: TP_3V3; TestPoint_Pad_D1.5mm
U14: TPS54360; HSOP-8-1EP_3.9x4.9mm_P1.27mm_EP2.41x3.1mm
U15: AP63205WU; TSOT-23-6
U16: AP63203WU; TSOT-23-6

Connections:
3V3: C82.1, C83.1, FB2.1, L4.2, TP15.1, U16.1 (FB); also elsewhere on the board
3V3A: C85.1, C86.1, FB2.2; also elsewhere on the board
5V: C78.1, C79.1, L3.2, TP14.1, U15.1 (FB); also elsewhere on the board
/aux_power/AUX_BOOT: C68.1, U14.1 (BOOT)
/aux_power/AUX_COMP_RC: C75.1, R78.2
/aux_power/AUX_EN: R73.2, R74.1, U14.3 (EN)
/aux_power/AUX_FB: C74.1, R76.2, R77.1, U14.5 (FB)
/aux_power/AUX_SW: C68.2, D9.1 (K), L2.1, U14.8 (SW)
/aux_power/AUX_VIN: C65.1, C66.1, C67.1, FB1.2, R73.1, U14.2 (VIN)
/aux_power/B3_BST: C81.1, U16.6 (BST)
/aux_power/B3_SW: C81.2, L4.1, U16.5 (SW)
/aux_power/B5_BST: C77.1, U15.6 (BST)
/aux_power/B5_SW: C77.2, L3.1, U15.5 (SW)
/aux_power/N$4: R75.1, U14.4 (RT/CLK)
/aux_power/N$5: C76.1, R78.1, U14.6 (COMP)
/aux_power/VAUX_RAW: C69.1, C70.1, C71.1, C74.2, D10.2 (A), L2.2, R76.1
BAT_BUS: FB1.1; also elsewhere on the board
GND: C65.2, C66.2, C67.2, C69.2, C70.2, C71.2, C72.2, C73.2, C75.2, C76.2, C78.2, C79.2, C80.2, C82.2, C83.2, C84.2, C85.2, C86.2, D9.2 (A), R74.2, R75.2, R77.2, U14.7 (GND), U14.9 (GNDPAD), U15.4 (GND), U16.4 (GND); also elsewhere on the board
VAUX: C72.1, C73.1, C80.1, C84.1, D10.1 (K), TP13.1, U15.2 (EN), U15.3 (IN), U16.2 (EN), U16.3 (IN); also elsewhere on the board

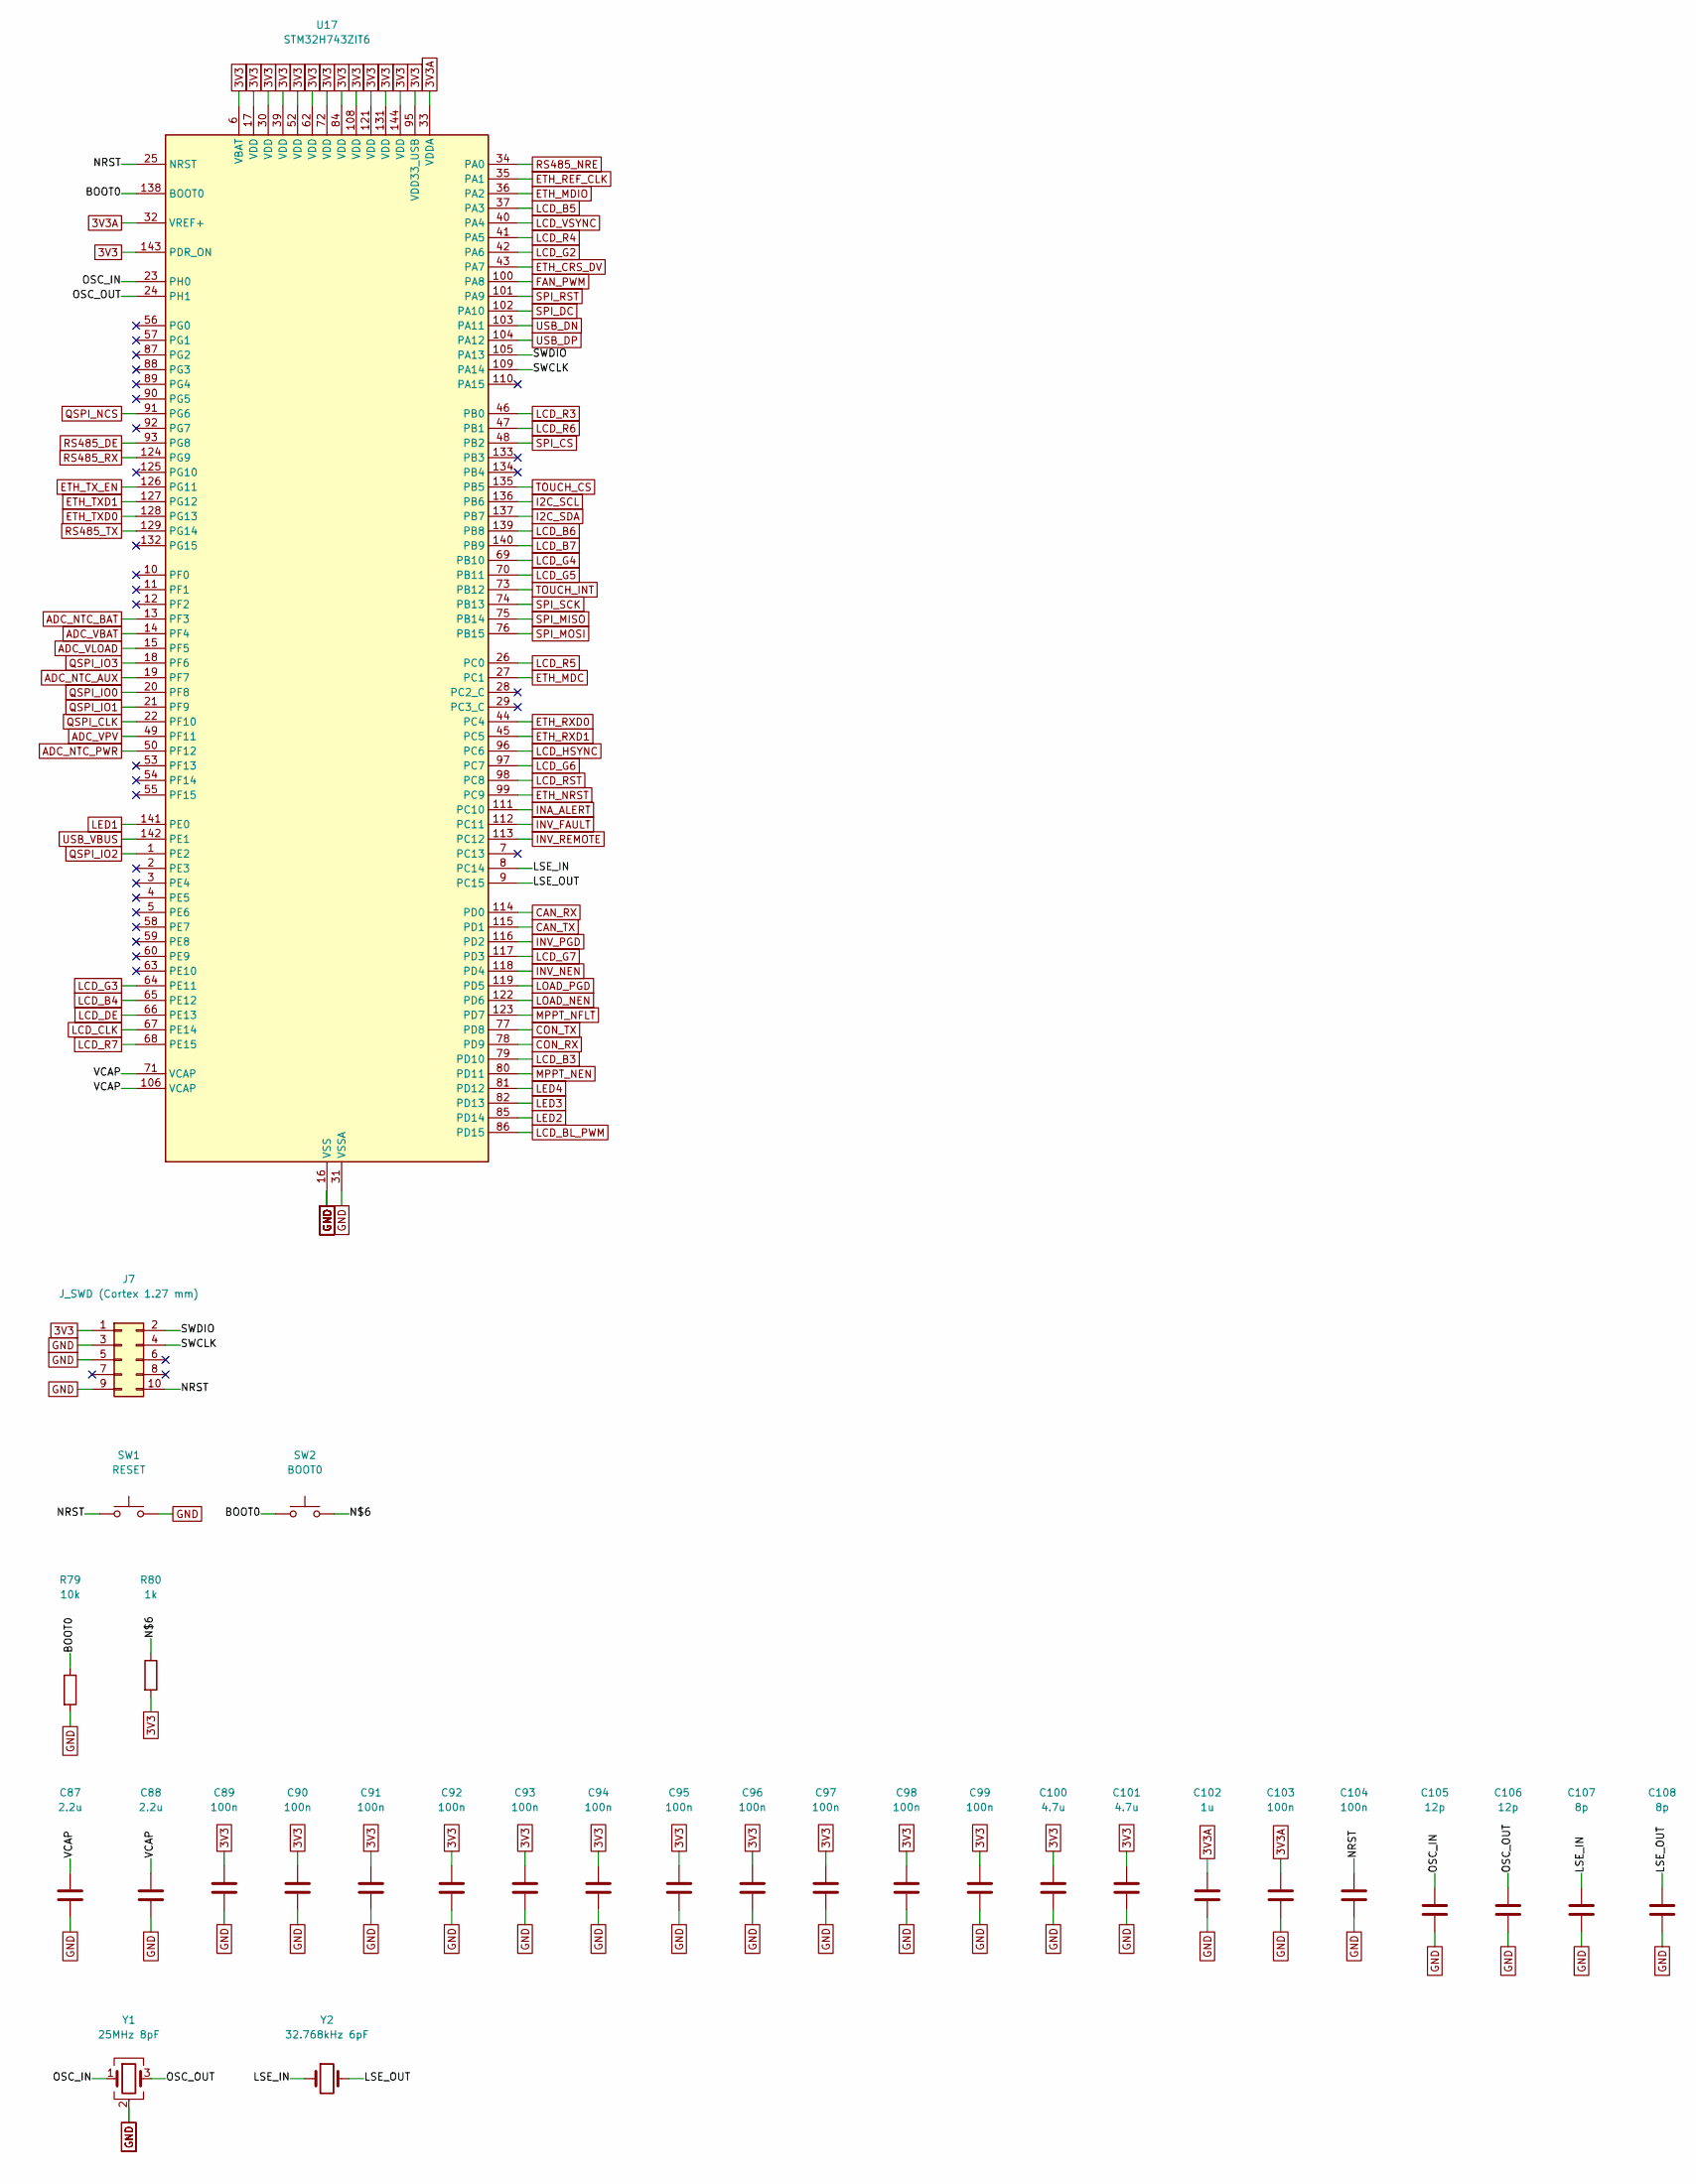
[picture p49: schematic mppt_controller_mcu.kicad_sch, mcu]

Parts:
C87, C88: 2.2u; C_0603_1608Metric
C89, C90, C91, C92, C93, C94, C95, C96, C97, C98, C99, C103, C104: 100n; C_0603_1608Metric
C100, C101: 4.7u; C_0805_2012Metric
C102: 1u; C_0603_1608Metric
C105, C106: 12p; C_0603_1608Metric
C107, C108: 8p; C_0603_1608Metric
J7: J_SWD (Cortex 1.27 mm); PinHeader_2x05_P1.27mm_Vertical
R79: 10k; R_0603_1608Metric
R80: 1k; R_0603_1608Metric
SW1: RESET; SW_SPST_PTS645Sx43SMTR92
SW2: BOOT0; SW_SPST_PTS645Sx43SMTR92
U17: STM32H743ZIT6; LQFP-144_20x20mm_P0.5mm
Y1: 25MHz 8pF; Crystal_SMD_3225-4Pin_3.2x2.5mm
Y2: 32.768kHz 6pF; Crystal_SMD_3215-2Pin_3.2x1.5mm

Connections:
3V3: C89.1, C90.1, C91.1, C92.1, C93.1, C94.1, C95.1, C96.1, C97.1, C98.1, C99.1, C100.1, C101.1, J7.1, R80.2, U17.6 (VBAT), U17.17 (VDD), U17.30 (VDD), U17.39 (VDD), U17.52 (VDD), U17.62 (VDD), U17.72 (VDD), U17.84 (VDD), U17.95 (VDD33_USB), U17.108 (VDD), U17.121 (VDD), U17.131 (VDD), U17.143 (PDR_ON), U17.144 (VDD); also elsewhere on the board
3V3A: C102.1, C103.1, U17.32 (VREF+), U17.33 (VDDA); also elsewhere on the board
/mcu/BOOT0: R79.1, SW2.1, U17.138 (BOOT0)
/mcu/LSE_IN: C107.1, U17.8 (PC14), Y2.1
/mcu/LSE_OUT: C108.1, U17.9 (PC15), Y2.2
/mcu/N$6: R80.1, SW2.2
/mcu/NRST: C104.1, J7.10, SW1.1, U17.25 (NRST)
/mcu/OSC_IN: C105.1, U17.23 (PH0), Y1.1
/mcu/OSC_OUT: C106.1, U17.24 (PH1), Y1.3
/mcu/SWCLK: J7.4, U17.109 (PA14)
/mcu/SWDIO: J7.2, U17.105 (PA13)
/mcu/VCAP: C87.1, C88.1, U17.71 (VCAP), U17.106 (VCAP)
ADC_NTC_AUX: U17.19 (PF7); also elsewhere on the board
ADC_NTC_BAT: U17.13 (PF3); also elsewhere on the board
ADC_NTC_PWR: U17.50 (PF12); also elsewhere on the board
ADC_VBAT: U17.14 (PF4); also elsewhere on the board
ADC_VLOAD: U17.15 (PF5); also elsewhere on the board
ADC_VPV: U17.49 (PF11); also elsewhere on the board
CAN_RX: U17.114 (PD0); also elsewhere on the board
CAN_TX: U17.115 (PD1); also elsewhere on the board
CON_RX: U17.78 (PD9); also elsewhere on the board
CON_TX: U17.77 (PD8); also elsewhere on the board
ETH_CRS_DV: U17.43 (PA7); also elsewhere on the board
ETH_MDC: U17.27 (PC1); also elsewhere on the board
ETH_MDIO: U17.36 (PA2); also elsewhere on the board
ETH_NRST: U17.99 (PC9); also elsewhere on the board
ETH_REF_CLK: U17.35 (PA1); also elsewhere on the board
ETH_RXD0: U17.44 (PC4); also elsewhere on the board
ETH_RXD1: U17.45 (PC5); also elsewhere on the board
ETH_TXD0: U17.128 (PG13); also elsewhere on the board
ETH_TXD1: U17.127 (PG12); also elsewhere on the board
ETH_TX_EN: U17.126 (PG11); also elsewhere on the board
FAN_PWM: U17.100 (PA8); also elsewhere on the board
GND: C87.2, C88.2, C89.2, C90.2, C91.2, C92.2, C93.2, C94.2, C95.2, C96.2, C97.2, C98.2, C99.2, C100.2, C101.2, C102.2, C103.2, C104.2, C105.2, C106.2, C107.2, C108.2, J7.3, J7.5, J7.9, R79.2, SW1.2, U17.16 (VSS), U17.31 (VSSA), U17.38 (VSS), U17.51 (VSS), U17.61 (VSS), U17.83 (VSS), U17.94 (VSS), U17.107 (VSS), U17.120 (VSS), U17.130 (VSS), Y1.2 (G), Y1.4 (G); also elsewhere on the board
I2C_SCL: U17.136 (PB6); also elsewhere on the board
I2C_SDA: U17.137 (PB7); also elsewhere on the board
INA_ALERT: U17.111 (PC10); also elsewhere on the board
INV_FAULT: U17.112 (PC11); also elsewhere on the board
INV_NEN: U17.118 (PD4); also elsewhere on the board
INV_PGD: U17.116 (PD2); also elsewhere on the board
INV_REMOTE: U17.113 (PC12); also elsewhere on the board
LCD_B3: U17.79 (PD10); also elsewhere on the board
LCD_B4: U17.65 (PE12); also elsewhere on the board
LCD_B5: U17.37 (PA3); also elsewhere on the board
LCD_B6: U17.139 (PB8); also elsewhere on the board
LCD_B7: U17.140 (PB9); also elsewhere on the board
LCD_BL_PWM: U17.86 (PD15); also elsewhere on the board
LCD_CLK: U17.67 (PE14); also elsewhere on the board
LCD_DE: U17.66 (PE13); also elsewhere on the board
LCD_G2: U17.42 (PA6); also elsewhere on the board
LCD_G3: U17.64 (PE11); also elsewhere on the board
LCD_G4: U17.69 (PB10); also elsewhere on the board
LCD_G5: U17.70 (PB11); also elsewhere on the board
LCD_G6: U17.97 (PC7); also elsewhere on the board
LCD_G7: U17.117 (PD3); also elsewhere on the board
LCD_HSYNC: U17.96 (PC6); also elsewhere on the board
LCD_R3: U17.46 (PB0); also elsewhere on the board
LCD_R4: U17.41 (PA5); also elsewhere on the board
LCD_R5: U17.26 (PC0); also elsewhere on the board
LCD_R6: U17.47 (PB1); also elsewhere on the board
LCD_R7: U17.68 (PE15); also elsewhere on the board
LCD_RST: U17.98 (PC8); also elsewhere on the board
LCD_VSYNC: U17.40 (PA4); also elsewhere on the board
LED1: U17.141 (PE0); also elsewhere on the board
LED2: U17.85 (PD14); also elsewhere on the board
LED3: U17.82 (PD13); also elsewhere on the board
LED4: U17.81 (PD12); also elsewhere on the board
LOAD_NEN: U17.122 (PD6); also elsewhere on the board
LOAD_PGD: U17.119 (PD5); also elsewhere on the board
MPPT_NEN: U17.80 (PD11); also elsewhere on the board
MPPT_NFLT: U17.123 (PD7); also elsewhere on the board
QSPI_CLK: U17.22 (PF10); also elsewhere on the board
QSPI_IO0: U17.20 (PF8); also elsewhere on the board
QSPI_IO1: U17.21 (PF9); also elsewhere on the board
QSPI_IO2: U17.1 (PE2); also elsewhere on the board
QSPI_IO3: U17.18 (PF6); also elsewhere on the board
QSPI_NCS: U17.91 (PG6); also elsewhere on the board
RS485_DE: U17.93 (PG8); also elsewhere on the board
RS485_NRE: U17.34 (PA0); also elsewhere on the board
RS485_RX: U17.124 (PG9); also elsewhere on the board
RS485_TX: U17.129 (PG14); also elsewhere on the board
SPI_CS: U17.48 (PB2); also elsewhere on the board
SPI_DC: U17.102 (PA10); also elsewhere on the board
SPI_MISO: U17.75 (PB14); also elsewhere on the board
SPI_MOSI: U17.76 (PB15); also elsewhere on the board
SPI_RST: U17.101 (PA9); also elsewhere on the board
SPI_SCK: U17.74 (PB13); also elsewhere on the board
TOUCH_CS: U17.135 (PB5); also elsewhere on the board
TOUCH_INT: U17.73 (PB12); also elsewhere on the board
USB_DN: U17.103 (PA11); also elsewhere on the board
USB_DP: U17.104 (PA12); also elsewhere on the board
USB_VBUS: U17.142 (PE1); also elsewhere on the board

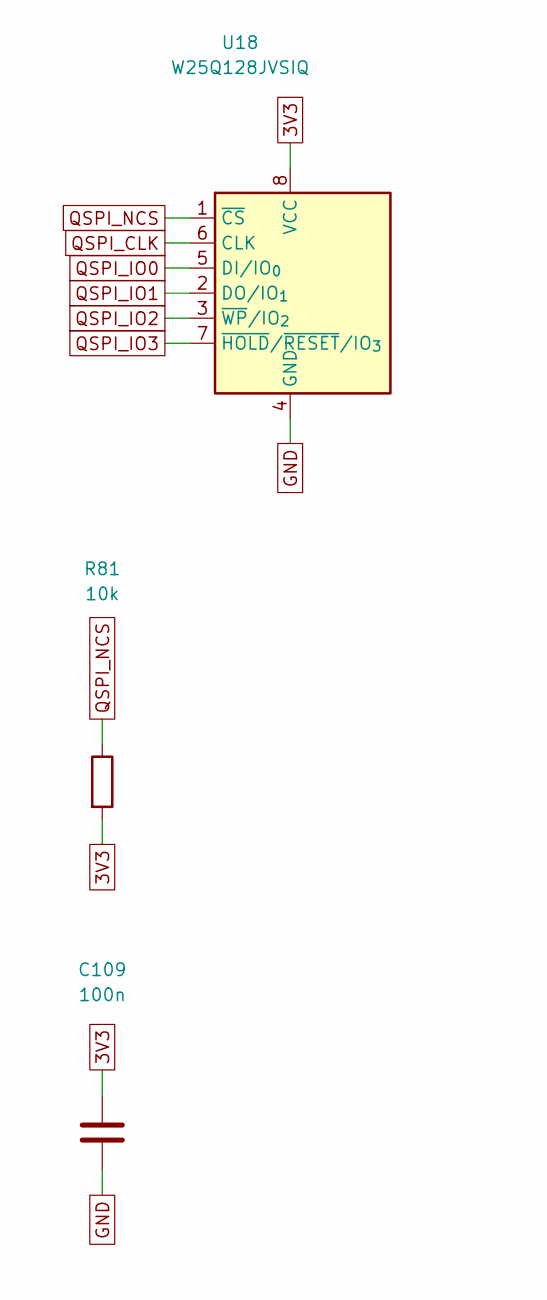
[picture p50: schematic mppt_controller_flash.kicad_sch, flash]

Parts:
C109: 100n; C_0603_1608Metric
R81: 10k; R_0603_1608Metric
U18: W25Q128JVSIQ; SOIC-8_5.3x5.3mm_P1.27mm

Connections:
3V3: C109.1, R81.2, U18.8 (VCC); also elsewhere on the board
GND: C109.2, U18.4 (GND); also elsewhere on the board
QSPI_CLK: U18.6 (CLK); also elsewhere on the board
QSPI_IO0: U18.5 (DI/IO_{0}); also elsewhere on the board
QSPI_IO1: U18.2 (DO/IO_{1}); also elsewhere on the board
QSPI_IO2: U18.3 (~WP/IO_{2}); also elsewhere on the board
QSPI_IO3: U18.7 (~HOLD/~RESET/IO_{3}); also elsewhere on the board
QSPI_NCS: R81.1, U18.1 (~CS); also elsewhere on the board

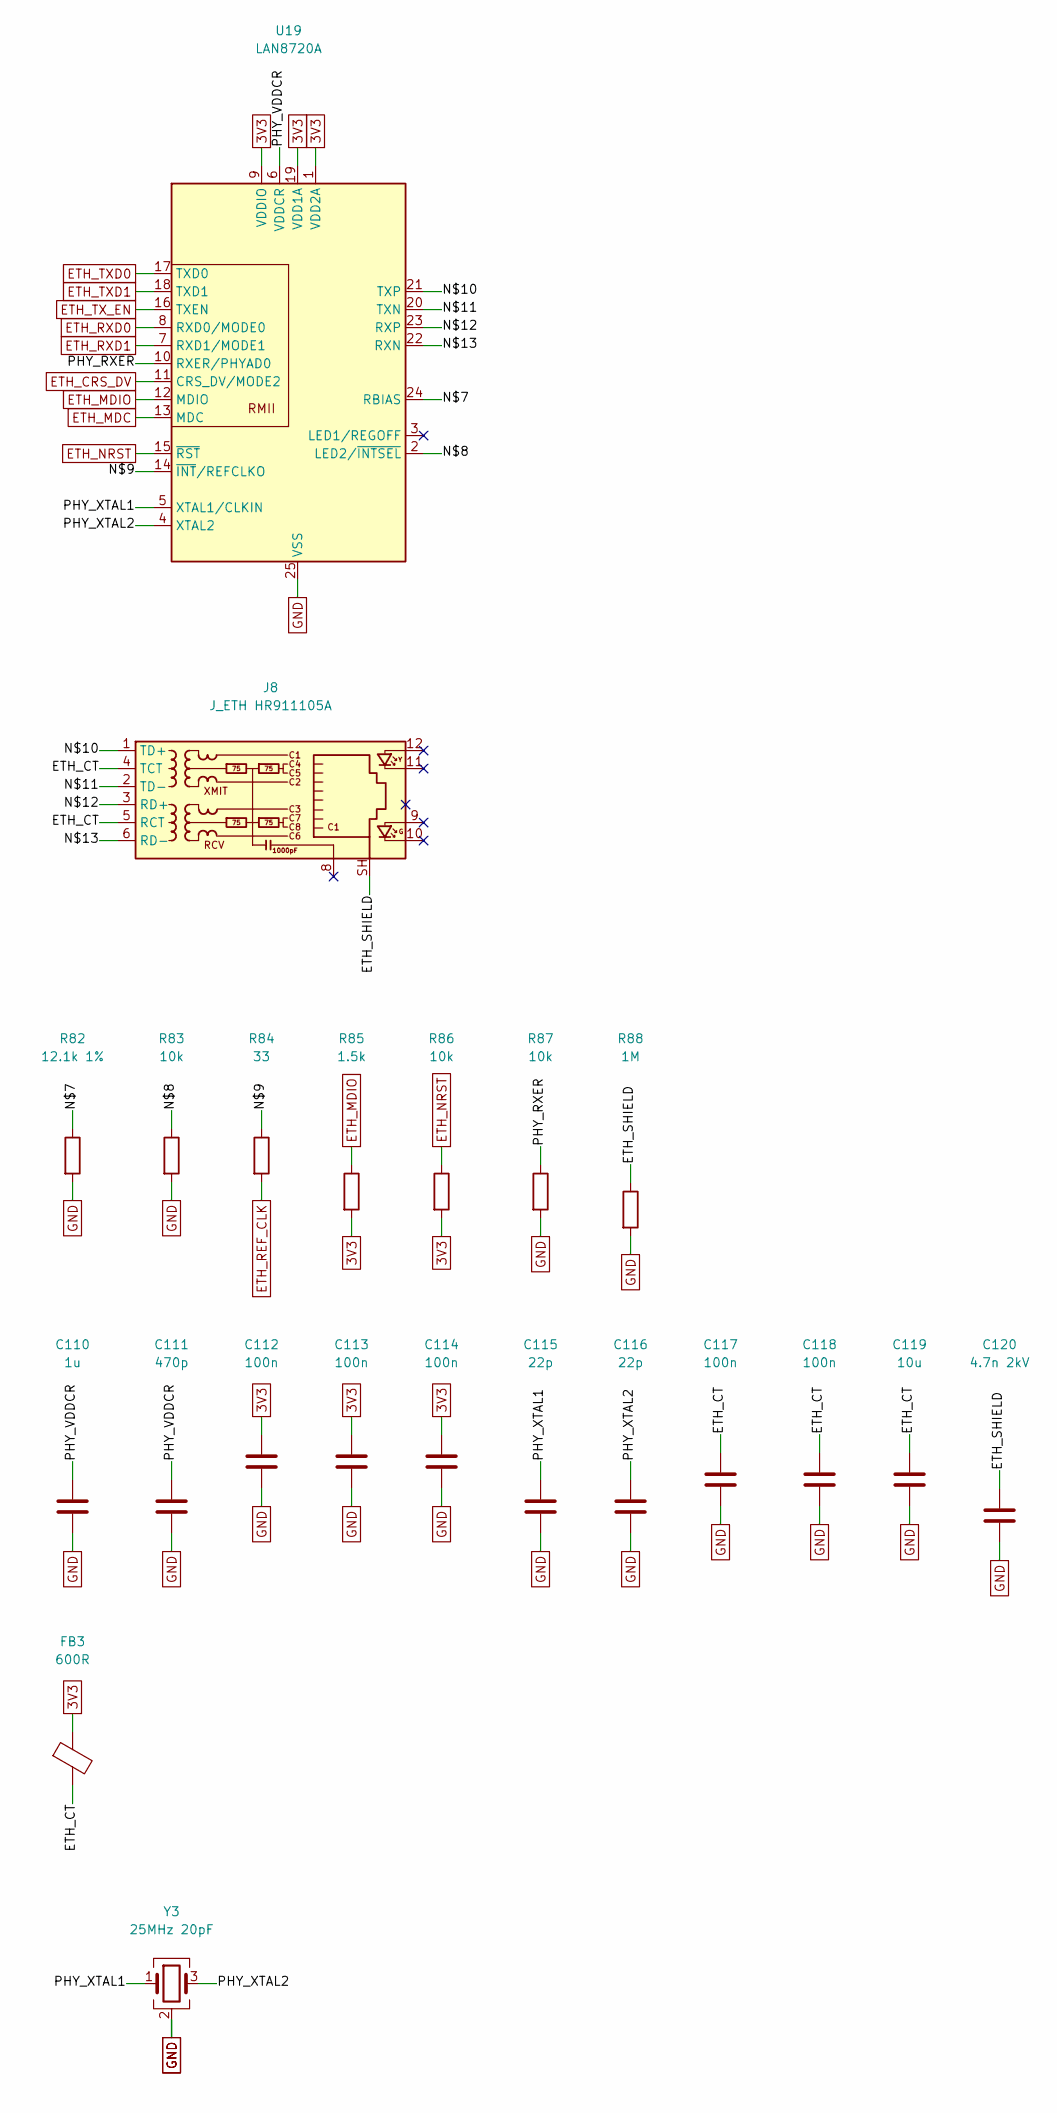
[picture p51: schematic mppt_controller_ethernet.kicad_sch, ethernet]

Parts:
C110: 1u; C_0603_1608Metric
C111: 470p; C_0603_1608Metric
C112, C113, C114, C117, C118: 100n; C_0603_1608Metric
C115, C116: 22p; C_0603_1608Metric
C119: 10u; C_0805_2012Metric
C120: 4.7n 2kV; C_1206_3216Metric
FB3: 600R; L_0603_1608Metric
J8: J_ETH HR911105A; RJ45_Hanrun_HR911105A_Horizontal
R82: 12.1k 1%; R_0603_1608Metric
R83, R86, R87: 10k; R_0603_1608Metric
R84: 33; R_0603_1608Metric
R85: 1.5k; R_0603_1608Metric
R88: 1M; R_0603_1608Metric
U19: LAN8720A; QFN-24-1EP_4x4mm_P0.5mm_EP2.6x2.6mm
Y3: 25MHz 20pF; Crystal_SMD_3225-4Pin_3.2x2.5mm

Connections:
3V3: C112.1, C113.1, C114.1, FB3.1, R85.2, R86.2, U19.1 (VDD2A), U19.9 (VDDIO), U19.19 (VDD1A); also elsewhere on the board
/ethernet/ETH_CT: C117.1, C118.1, C119.1, FB3.2, J8.4 (TCT), J8.5 (RCT)
/ethernet/ETH_SHIELD: C120.1, J8.SH, R88.1
/ethernet/N$7: R82.1, U19.24 (RBIAS)
/ethernet/N$8: R83.1, U19.2 (LED2/~INTSEL)
/ethernet/N$9: R84.1, U19.14 (~INT/REFCLKO)
/ethernet/N$10: J8.1 (TD+), U19.21 (TXP)
/ethernet/N$11: J8.2 (TD-), U19.20 (TXN)
/ethernet/N$12: J8.3 (RD+), U19.23 (RXP)
/ethernet/N$13: J8.6 (RD-), U19.22 (RXN)
/ethernet/PHY_RXER: R87.1, U19.10 (RXER/PHYAD0)
/ethernet/PHY_VDDCR: C110.1, C111.1, U19.6 (VDDCR)
/ethernet/PHY_XTAL1: C115.1, U19.5 (XTAL1/CLKIN), Y3.1
/ethernet/PHY_XTAL2: C116.1, U19.4 (XTAL2), Y3.3
ETH_CRS_DV: U19.11 (CRS_DV/MODE2); also elsewhere on the board
ETH_MDC: U19.13 (MDC); also elsewhere on the board
ETH_MDIO: R85.1, U19.12 (MDIO); also elsewhere on the board
ETH_NRST: R86.1, U19.15 (~RST); also elsewhere on the board
ETH_REF_CLK: R84.2; also elsewhere on the board
ETH_RXD0: U19.8 (RXD0/MODE0); also elsewhere on the board
ETH_RXD1: U19.7 (RXD1/MODE1); also elsewhere on the board
ETH_TXD0: U19.17 (TXD0); also elsewhere on the board
ETH_TXD1: U19.18 (TXD1); also elsewhere on the board
ETH_TX_EN: U19.16 (TXEN); also elsewhere on the board
GND: C110.2, C111.2, C112.2, C113.2, C114.2, C115.2, C116.2, C117.2, C118.2, C119.2, C120.2, R82.2, R83.2, R87.2, R88.2, U19.25 (VSS), Y3.2 (G), Y3.4 (G); also elsewhere on the board

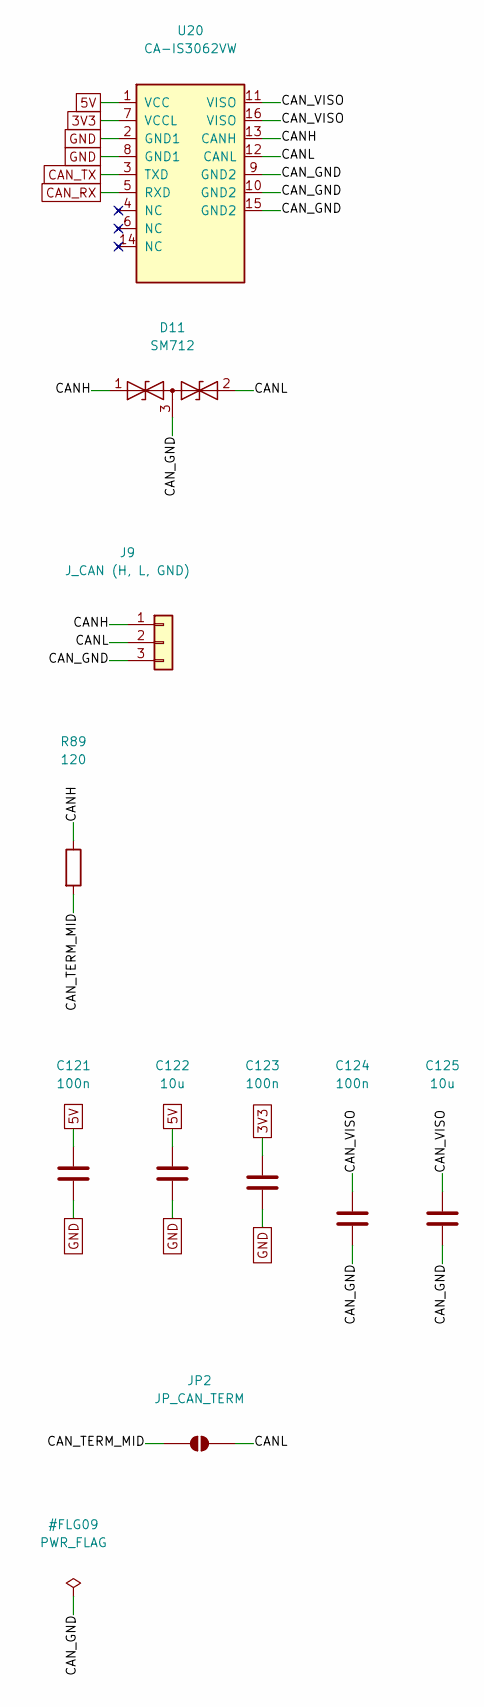
[picture p52: schematic mppt_controller_can.kicad_sch, can]

Parts:
C121, C123, C124: 100n; C_0603_1608Metric
C122, C125: 10u; C_0805_2012Metric
D11: SM712; SOT-23
J9: J_CAN (H, L, GND); TerminalBlock_Phoenix_PT-1,5-3-3.5-H_1x03_P3.50mm_Horizontal
JP2: JP_CAN_TERM; SolderJumper-2_P1.3mm_Open_Pad1.0x1.5mm
R89: 120; R_0603_1608Metric
U20: CA-IS3062VW; SOIC-16W_7.5x10.3mm_P1.27mm

Connections:
3V3: C123.1, U20.7 (VCCL); also elsewhere on the board
5V: C121.1, C122.1, U20.1 (VCC); also elsewhere on the board
/can/CANH: D11.1 (A1), J9.1, R89.1, U20.13 (CANH)
/can/CANL: D11.2 (A2), J9.2, JP2.2 (B), U20.12 (CANL)
/can/CAN_GND: C124.2, C125.2, D11.3 (common), J9.3, U20.9 (GND2), U20.10 (GND2), U20.15 (GND2)
/can/CAN_TERM_MID: JP2.1 (A), R89.2
/can/CAN_VISO: C124.1, C125.1, U20.11 (VISO), U20.16 (VISO)
CAN_RX: U20.5 (RXD); also elsewhere on the board
CAN_TX: U20.3 (TXD); also elsewhere on the board
GND: C121.2, C122.2, C123.2, U20.2 (GND1), U20.8 (GND1); also elsewhere on the board

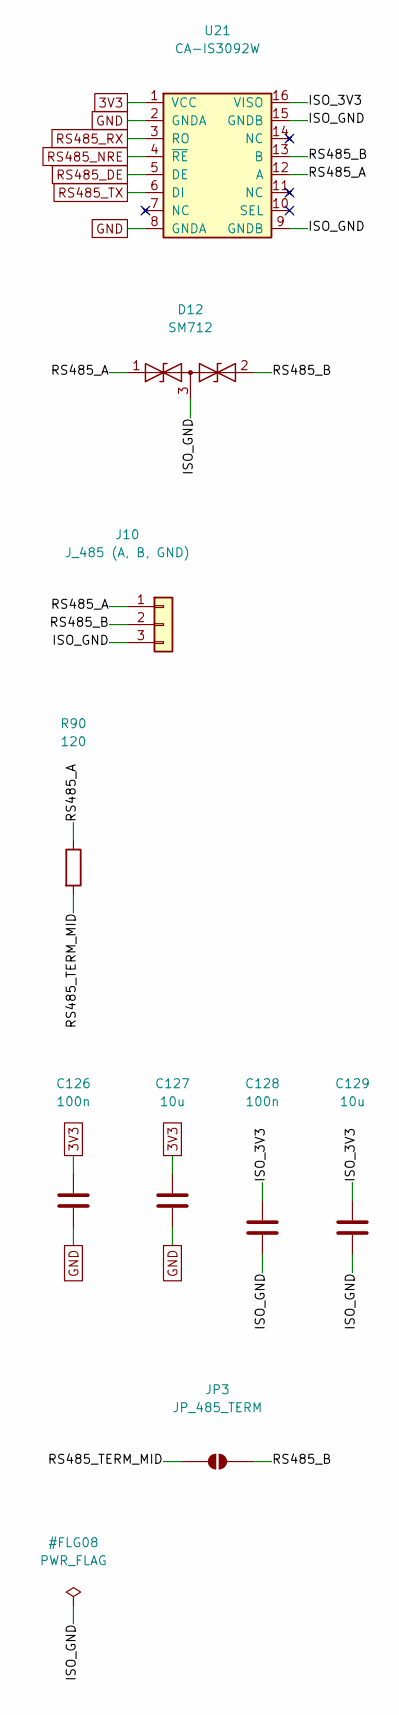
[picture p53: schematic mppt_controller_rs485.kicad_sch, rs485]

Parts:
C126, C128: 100n; C_0603_1608Metric
C127, C129: 10u; C_0805_2012Metric
D12: SM712; SOT-23
J10: J_485 (A, B, GND); TerminalBlock_Phoenix_PT-1,5-3-3.5-H_1x03_P3.50mm_Horizontal
JP3: JP_485_TERM; SolderJumper-2_P1.3mm_Open_Pad1.0x1.5mm
R90: 120; R_0603_1608Metric
U21: CA-IS3092W; SOIC-16W_7.5x10.3mm_P1.27mm

Connections:
3V3: C126.1, C127.1, U21.1 (VCC); also elsewhere on the board
/rs485/ISO_3V3: C128.1, C129.1, U21.16 (VISO)
/rs485/ISO_GND: C128.2, C129.2, D12.3 (common), J10.3, U21.9 (GNDB), U21.15 (GNDB)
/rs485/RS485_A: D12.1 (A1), J10.1, R90.1, U21.12 (A)
/rs485/RS485_B: D12.2 (A2), J10.2, JP3.2 (B), U21.13 (B)
/rs485/RS485_TERM_MID: JP3.1 (A), R90.2
GND: C126.2, C127.2, U21.2 (GNDA), U21.8 (GNDA); also elsewhere on the board
RS485_DE: U21.5 (DE); also elsewhere on the board
RS485_NRE: U21.4 (~RE); also elsewhere on the board
RS485_RX: U21.3 (RO); also elsewhere on the board
RS485_TX: U21.6 (DI); also elsewhere on the board

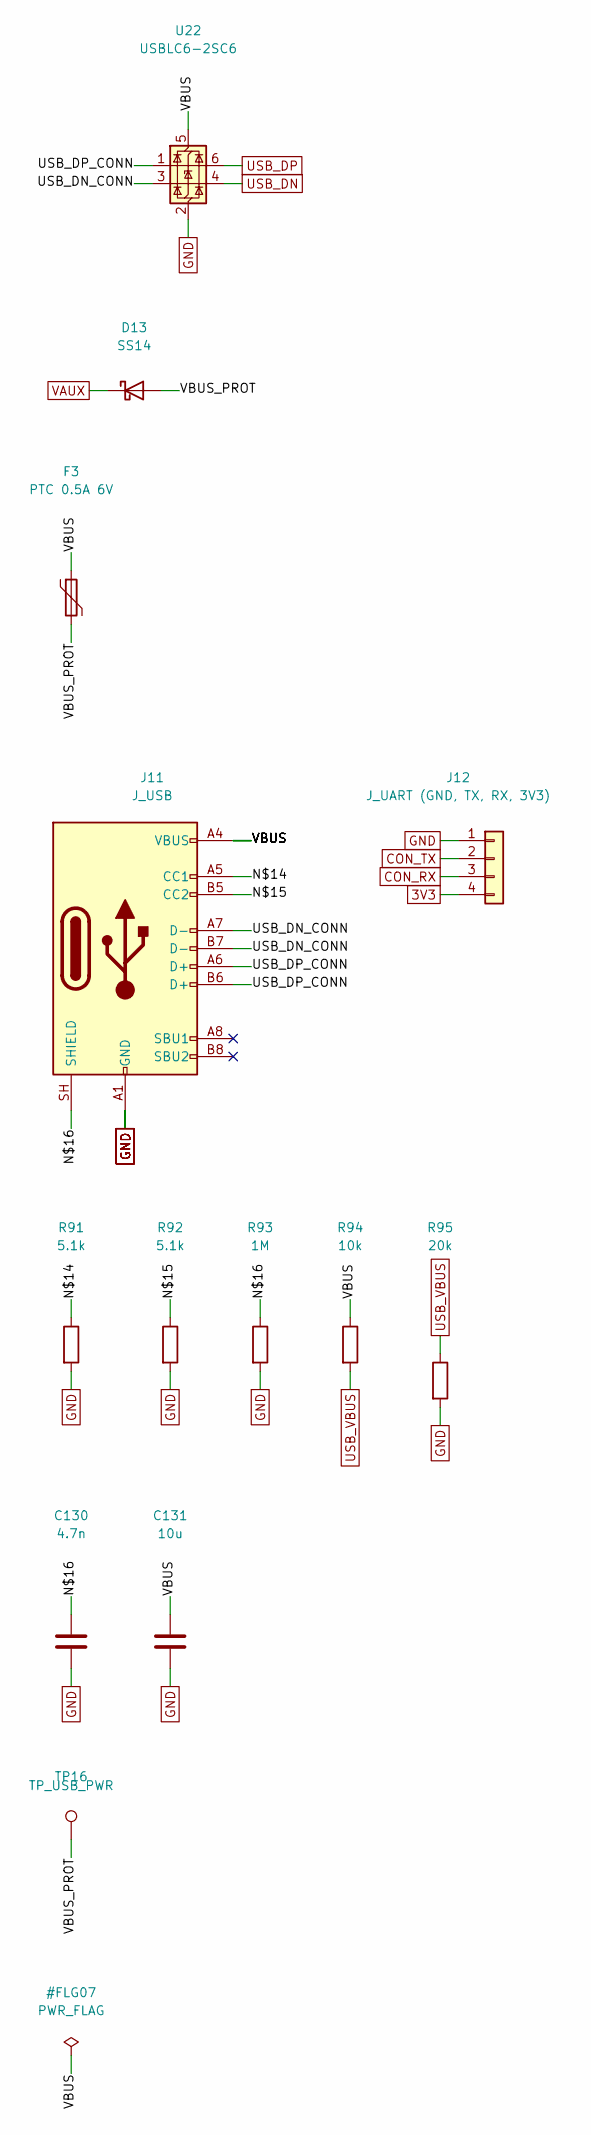
[picture p54: schematic mppt_controller_usb_uart.kicad_sch, usb_uart]

Parts:
C130: 4.7n; C_0603_1608Metric
C131: 10u; C_1206_3216Metric
D13: SS14; D_SMA
F3: PTC 0.5A 6V; Fuse_1206_3216Metric
J11: J_USB; USB_C_Receptacle_HRO_TYPE-C-31-M-12
J12: J_UART (GND, TX, RX, 3V3); PinHeader_1x04_P2.54mm_Vertical
R91, R92: 5.1k; R_0603_1608Metric
R93: 1M; R_0603_1608Metric
R94: 10k; R_0603_1608Metric
R95: 20k; R_0603_1608Metric
TP16: TP_USB_PWR; TestPoint_Pad_D1.5mm
U22: USBLC6-2SC6; SOT-23-6

Connections:
3V3: J12.4; also elsewhere on the board
/usb_uart/N$14: J11.A5 (CC1), R91.1
/usb_uart/N$15: J11.B5 (CC2), R92.1
/usb_uart/N$16: C130.1, J11.SH (SHIELD), R93.1
/usb_uart/USB_DN_CONN: J11.A7 (D-), J11.B7 (D-), U22.3 (I/O2)
/usb_uart/USB_DP_CONN: J11.A6 (D+), J11.B6 (D+), U22.1 (I/O1)
/usb_uart/VBUS: C131.1, F3.1, J11.A4 (VBUS), J11.A9 (VBUS), J11.B4 (VBUS), J11.B9 (VBUS), R94.1, U22.5 (VBUS)
/usb_uart/VBUS_PROT: D13.2 (A), F3.2, TP16.1
CON_RX: J12.3; also elsewhere on the board
CON_TX: J12.2; also elsewhere on the board
GND: C130.2, C131.2, J11.A1 (GND), J11.A12 (GND), J11.B1 (GND), J11.B12 (GND), J12.1, R91.2, R92.2, R93.2, R95.2, U22.2 (GND); also elsewhere on the board
USB_DN: U22.4 (I/O2); also elsewhere on the board
USB_DP: U22.6 (I/O1); also elsewhere on the board
USB_VBUS: R94.2, R95.1; also elsewhere on the board
VAUX: D13.1 (K); also elsewhere on the board
