mtilocca/mppt-controller/hardware/mppt_controller.kicad_pcb

## KiCad design hardware/mppt_controller.kicad_pcb (continued)

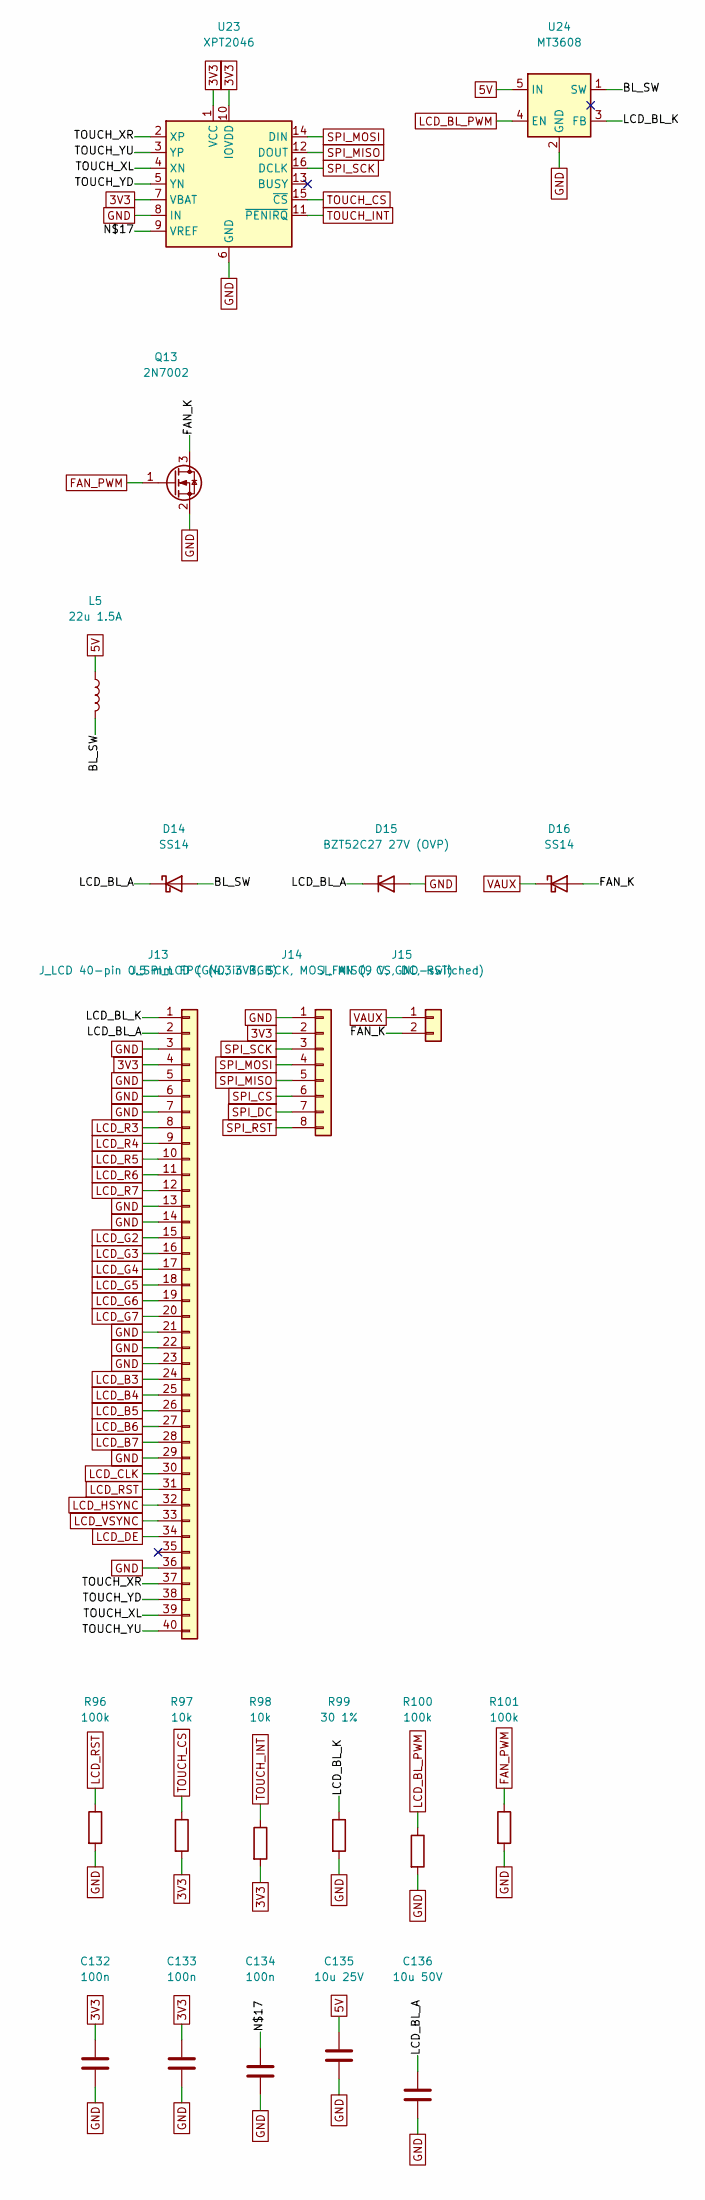
[picture p55: schematic mppt_controller_display.kicad_sch, display]

Parts:
C132, C133, C134: 100n; C_0603_1608Metric
C135: 10u 25V; C_1206_3216Metric
C136: 10u 50V; C_1206_3216Metric
D14, D16: SS14; D_SMA
D15: BZT52C27 27V (OVP); D_SOD-123
J13: J_LCD 40-pin 0.5 mm FPC (4.3in RGB); Hirose_FH12-40S-0.5SH_1x40-1MP_P0.50mm_Horizontal
J14: J_SPI_LCD (GND, 3V3, SCK, MOSI, MISO, CS, DC, RST); PinHeader_1x08_P2.54mm_Vertical
J15: J_FAN (9 V, GND-switched); PinHeader_1x02_P2.54mm_Vertical
L5: 22u 1.5A; L_Bourns_SRP5030T
Q13: 2N7002; SOT-23
R96, R100, R101: 100k; R_0603_1608Metric
R97, R98: 10k; R_0603_1608Metric
R99: 30 1%; R_0603_1608Metric
U23: XPT2046; TSSOP-16_4.4x5mm_P0.65mm
U24: MT3608; SOT-23-6

Connections:
3V3: C132.1, C133.1, J13.4, J14.2, R97.2, R98.2, U23.1 (VCC), U23.7 (VBAT), U23.10 (IOVDD); also elsewhere on the board
5V: C135.1, L5.1, U24.5 (IN); also elsewhere on the board
/display/BL_SW: D14.2 (A), L5.2, U24.1 (SW)
/display/FAN_K: D16.2 (A), J15.2, Q13.3 (D)
/display/LCD_BL_A: C136.1, D14.1 (K), D15.1 (K), J13.2
/display/LCD_BL_K: J13.1, R99.1, U24.3 (FB)
/display/N$17: C134.1, U23.9 (VREF)
/display/TOUCH_XL: J13.39, U23.4 (XN)
/display/TOUCH_XR: J13.37, U23.2 (XP)
/display/TOUCH_YD: J13.38, U23.5 (YN)
/display/TOUCH_YU: J13.40, U23.3 (YP)
FAN_PWM: Q13.1 (G), R101.1; also elsewhere on the board
GND: C132.2, C133.2, C134.2, C135.2, C136.2, D15.2 (A), J13.3, J13.5, J13.6, J13.7, J13.13, J13.14, J13.21, J13.22, J13.23, J13.29, J13.36, J14.1, Q13.2 (S), R96.2, R99.2, R100.2, R101.2, U23.6 (GND), U23.8 (IN), U24.2 (GND); also elsewhere on the board
LCD_B3: J13.24; also elsewhere on the board
LCD_B4: J13.25; also elsewhere on the board
LCD_B5: J13.26; also elsewhere on the board
LCD_B6: J13.27; also elsewhere on the board
LCD_B7: J13.28; also elsewhere on the board
LCD_BL_PWM: R100.1, U24.4 (EN); also elsewhere on the board
LCD_CLK: J13.30; also elsewhere on the board
LCD_DE: J13.34; also elsewhere on the board
LCD_G2: J13.15; also elsewhere on the board
LCD_G3: J13.16; also elsewhere on the board
LCD_G4: J13.17; also elsewhere on the board
LCD_G5: J13.18; also elsewhere on the board
LCD_G6: J13.19; also elsewhere on the board
LCD_G7: J13.20; also elsewhere on the board
LCD_HSYNC: J13.32; also elsewhere on the board
LCD_R3: J13.8; also elsewhere on the board
LCD_R4: J13.9; also elsewhere on the board
LCD_R5: J13.10; also elsewhere on the board
LCD_R6: J13.11; also elsewhere on the board
LCD_R7: J13.12; also elsewhere on the board
LCD_RST: J13.31, R96.1; also elsewhere on the board
LCD_VSYNC: J13.33; also elsewhere on the board
SPI_CS: J14.6; also elsewhere on the board
SPI_DC: J14.7; also elsewhere on the board
SPI_MISO: J14.5, U23.12 (DOUT); also elsewhere on the board
SPI_MOSI: J14.4, U23.14 (DIN); also elsewhere on the board
SPI_RST: J14.8; also elsewhere on the board
SPI_SCK: J14.3, U23.16 (DCLK); also elsewhere on the board
TOUCH_CS: R97.1, U23.15 (~CS); also elsewhere on the board
TOUCH_INT: R98.1, U23.11 (~PENIRQ); also elsewhere on the board
VAUX: D16.1 (K), J15.1; also elsewhere on the board

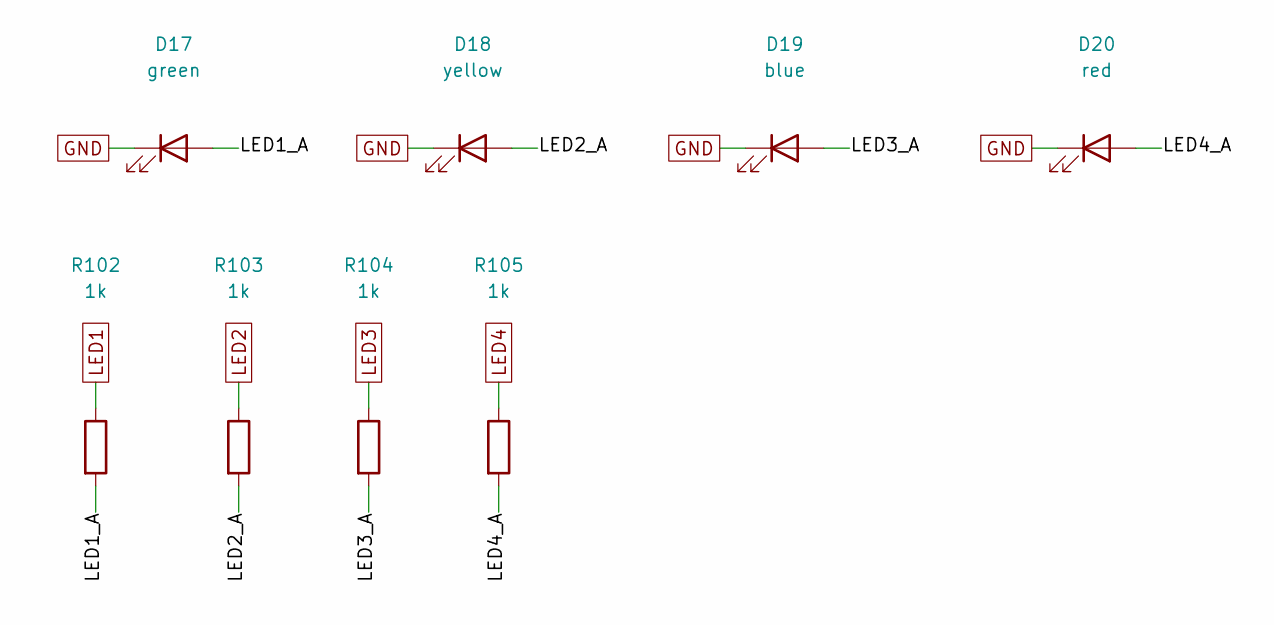
[picture p56: schematic mppt_controller_leds.kicad_sch, leds]

Parts:
D17: green; LED_0603_1608Metric
D18: yellow; LED_0603_1608Metric
D19: blue; LED_0603_1608Metric
D20: red; LED_0603_1608Metric
R102, R103, R104, R105: 1k; R_0603_1608Metric

Connections:
/leds/LED1_A: D17.2 (A), R102.2
/leds/LED2_A: D18.2 (A), R103.2
/leds/LED3_A: D19.2 (A), R104.2
/leds/LED4_A: D20.2 (A), R105.2
GND: D17.1 (K), D18.1 (K), D19.1 (K), D20.1 (K); also elsewhere on the board
LED1: R102.1; also elsewhere on the board
LED2: R103.1; also elsewhere on the board
LED3: R104.1; also elsewhere on the board
LED4: R105.1; also elsewhere on the board

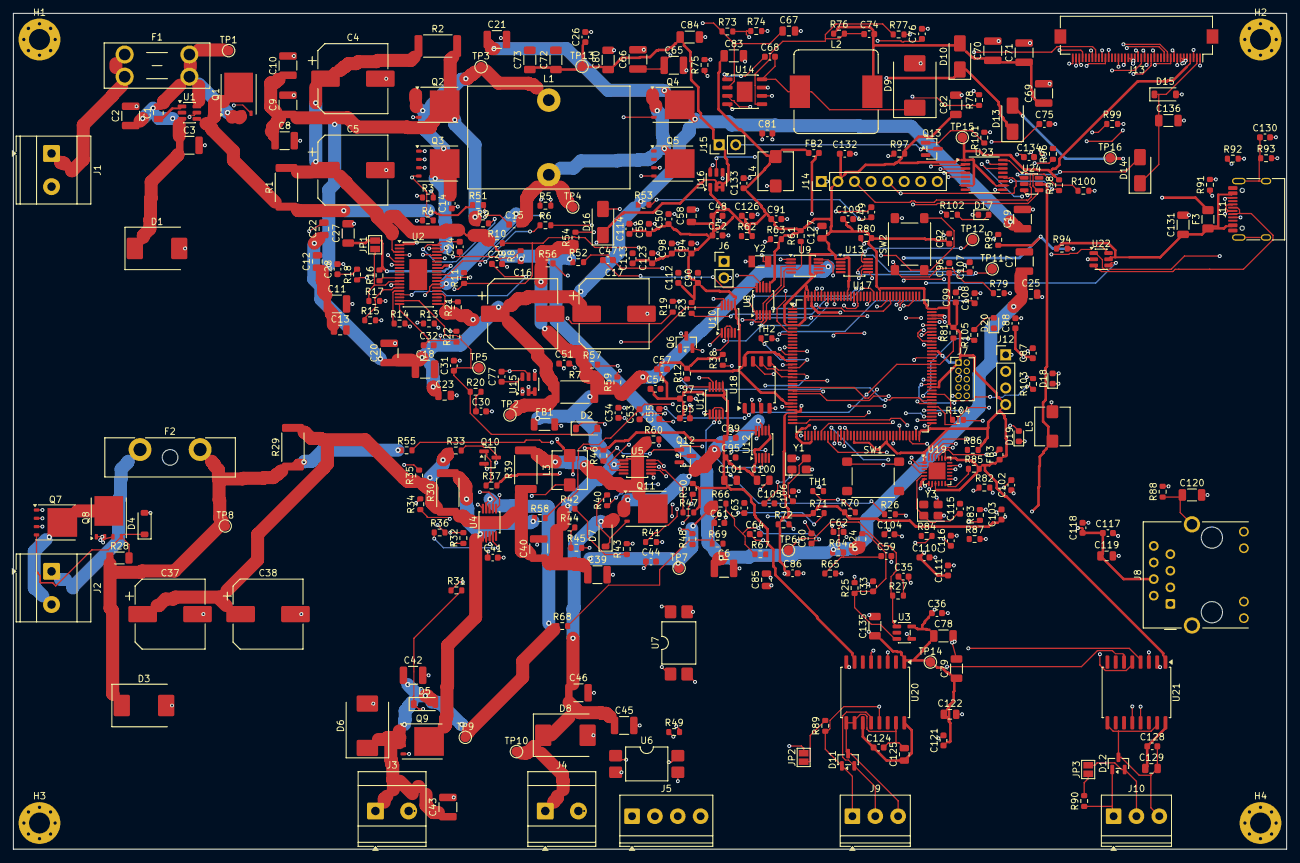
[picture p57: board mppt_controller.kicad_pcb from above]

Board: 4 copper layers, 195.0 x 128.0 mm, 354 parts (0 on the bottom side), 230 nets.

Other parts of the board:
H1, H2, H3, H4: MountingHole_3.2mm_M3_Pad_Via
