mtilocca/mppt-controller/hardware/mppt_controller_sklib.py

from collections import defaultdict
from skidl import Pin, Part, Alias, SchLib, SKIDL, TEMPLATE

from skidl.pin import pin_types

SKIDL_lib_version = '0.0.1'

mppt_controller = SchLib(tool=SKIDL).add_parts(*[
        Part(**{ 'name':'Screw_Terminal_01x02', 'dest':TEMPLATE, 'tool':SKIDL, 'aliases':Alias({'Screw_Terminal_01x02'}), 'ref_prefix':'J', 'fplist':[''], 'footprint':'TerminalBlock_Phoenix:TerminalBlock_Phoenix_MKDS-3-2-5.08_1x02_P5.08mm_Horizontal', 'keywords':'screw terminal', 'description':'Generic screw terminal, single row, 01x02, script generated (kicad-library-utils/schlib/autogen/connector/)', 'datasheet':'', 'pins':[
            Pin(num='1',name='Pin_1',func=pin_types.PASSIVE,unit=1),
            Pin(num='2',name='Pin_2',func=pin_types.PASSIVE,unit=1)], 'unit_defs':[] }),
        Part(**{ 'name':'Fuse', 'dest':TEMPLATE, 'tool':SKIDL, 'aliases':Alias({'Fuse'}), 'ref_prefix':'F', 'fplist':[''], 'footprint':'Fuse:Fuseholder_Blade_Mini_Keystone_3568', 'keywords':'fuse', 'description':'Fuse', 'datasheet':'', 'pins':[
            Pin(num='1',func=pin_types.PASSIVE,unit=1),
            Pin(num='2',func=pin_types.PASSIVE,unit=1)], 'unit_defs':[] }),
        Part(**{ 'name':'D', 'dest':TEMPLATE, 'tool':SKIDL, 'aliases':Alias({'D'}), 'ref_prefix':'D', 'fplist':[''], 'footprint':'Diode_SMD:D_SMC', 'keywords':'diode', 'description':'Diode', 'datasheet':'', 'pins':[
            Pin(num='1',name='K',func=pin_types.PASSIVE,unit=1),
            Pin(num='2',name='A',func=pin_types.PASSIVE,unit=1)], 'unit_defs':[] }),
        Part(**{ 'name':'LM74700', 'dest':TEMPLATE, 'tool':SKIDL, 'aliases':Alias({'LM74700'}), 'ref_prefix':'U', 'fplist':['Package_TO_SOT_SMD:SOT-23-6'], 'footprint':'Package_TO_SOT_SMD:SOT-23-6', 'keywords':'ideal-diode or-ing', 'description':'Low Iq reverse battery protection ideal diode controller, SOT-23-6', 'datasheet':'http://www.ti.com/lit/gpn/LM74700-Q1', 'pins':[
            Pin(num='1',name='VCAP',func=pin_types.PASSIVE,unit=1),
            Pin(num='2',name='GND',func=pin_types.PWRIN,unit=1),
            Pin(num='3',name='EN',func=pin_types.INPUT,unit=1),
            Pin(num='4',name='CATHODE',func=pin_types.INPUT,unit=1),
            Pin(num='5',name='GATE',func=pin_types.OUTPUT,unit=1),
            Pin(num='6',name='ANODE',func=pin_types.PWRIN,unit=1)], 'unit_defs':[] }),
        Part(**{ 'name':'Q_NMOS_PWR', 'dest':TEMPLATE, 'tool':SKIDL, 'aliases':Alias({'Q_NMOS_PWR'}), 'ref_prefix':'Q', 'fplist':['Package_TO_SOT_SMD:TDSON-8-1'], 'footprint':'Package_TO_SOT_SMD:TDSON-8-1', 'keywords':'', 'description':'N-channel power MOSFET, TDSON-8 / LFPAK56 pad order: 1-3 source, 4 gate, 5 drain', 'datasheet':'', 'pins':[
            Pin(num='4',name='G',func=pin_types.PASSIVE,unit=1),
            Pin(num='5',name='D',func=pin_types.PASSIVE,unit=1),
            Pin(num='1',name='S',func=pin_types.PASSIVE,unit=1),
            Pin(num='2',name='S',func=pin_types.PASSIVE,unit=1),
            Pin(num='3',name='S',func=pin_types.PASSIVE,unit=1)], 'unit_defs':[] }),
        Part(**{ 'name':'C', 'dest':TEMPLATE, 'tool':SKIDL, 'aliases':Alias({'C'}), 'ref_prefix':'C', 'fplist':[''], 'footprint':'Capacitor_SMD:C_0805_2012Metric', 'keywords':'cap capacitor', 'description':'Unpolarized capacitor', 'datasheet':'', 'pins':[
            Pin(num='1',func=pin_types.PASSIVE,unit=1),
            Pin(num='2',func=pin_types.PASSIVE,unit=1)], 'unit_defs':[] }),
        Part(**{ 'name':'R', 'dest':TEMPLATE, 'tool':SKIDL, 'aliases':Alias({'R'}), 'ref_prefix':'R', 'fplist':[''], 'footprint':'Resistor_SMD:R_2512_6332Metric', 'keywords':'R res resistor', 'description':'Resistor', 'datasheet':'', 'pins':[
            Pin(num='1',func=pin_types.PASSIVE,unit=1),
            Pin(num='2',func=pin_types.PASSIVE,unit=1)], 'unit_defs':[] }),
        Part(**{ 'name':'TestPoint', 'dest':TEMPLATE, 'tool':SKIDL, 'aliases':Alias({'TestPoint'}), 'ref_prefix':'TP', 'fplist':[''], 'footprint':'TestPoint:TestPoint_Pad_D1.5mm', 'keywords':'test point tp', 'description':'test point', 'datasheet':'', 'pins':[
            Pin(num='1',name='1',func=pin_types.PASSIVE,unit=1)], 'unit_defs':[] }),
        Part(**{ 'name':'LM5177', 'dest':TEMPLATE, 'tool':SKIDL, 'aliases':Alias({'LM5177'}), 'ref_prefix':'U', 'fplist':['Package_SO:HTSSOP-38-1EP_4.4x9.7mm_P0.5mm_EP2.74x4.75mm'], 'footprint':'Package_SO:HTSSOP-38-1EP_4.4x9.7mm_P0.5mm_EP2.74x4.75mm', 'keywords':'', 'description':'TI LM5177 60 V 4-switch buck-boost controller, HTSSOP-38 (DCP), pins from SNVSBU4F Table 4-1', 'datasheet':'', 'pins':[
            Pin(num='3',name='VIN',func=pin_types.PWRIN,unit=1),
            Pin(num='1',name='BIAS',func=pin_types.PASSIVE,unit=1),
            Pin(num='4',name='EN/UVLO',func=pin_types.INPUT,unit=1),
            Pin(num='16',name='SS/ATRK',func=pin_types.BIDIR,unit=1),
            Pin(num='10',name='DTRK',func=pin_types.INPUT,unit=1),
            Pin(num='11',name='SYNC',func=pin_types.INPUT,unit=1),
            Pin(num='12',name='MODE',func=pin_types.INPUT,unit=1),
            Pin(num='13',name='CFG',func=pin_types.PASSIVE,unit=1),
            Pin(num='14',name='SLOPE',func=pin_types.PASSIVE,unit=1),
            Pin(num='15',name='RT',func=pin_types.PASSIVE,unit=1),
            Pin(num='18',name='COMP',func=pin_types.OUTPUT,unit=1),
            Pin(num='19',name='FB',func=pin_types.INPUT,unit=1),
            Pin(num='37',name='CSA',func=pin_types.INPUT,unit=1),
            Pin(num='38',name='CSB',func=pin_types.INPUT,unit=1),
            Pin(num='23',name='ISNSP',func=pin_types.INPUT,unit=1),
            Pin(num='22',name='ISNSN',func=pin_types.INPUT,unit=1),
            Pin(num='17',name='AGND',func=pin_types.PWRIN,unit=1),
            Pin(num='39',name='PAD',func=pin_types.PWRIN,unit=1),
            Pin(num='20',name='VOUT',func=pin_types.INPUT,unit=1),
            Pin(num='35',name='HB1',func=pin_types.PASSIVE,unit=1),
            Pin(num='34',name='HO1',func=pin_types.OUTPUT,unit=1),
            Pin(num='36',name='SW1',func=pin_types.PASSIVE,unit=1),
            Pin(num='32',name='LO1',func=pin_types.OUTPUT,unit=1),
            Pin(num='31',name='VCC',func=pin_types.PASSIVE,unit=1),
            Pin(num='30',name='PGND',func=pin_types.PWRIN,unit=1),
            Pin(num='29',name='LO2',func=pin_types.OUTPUT,unit=1),
            Pin(num='27',name='HO2',func=pin_types.OUTPUT,unit=1),
            Pin(num='26',name='HB2',func=pin_types.PASSIVE,unit=1),
            Pin(num='25',name='SW2',func=pin_types.PASSIVE,unit=1),
            Pin(num='6',name='IMONOUT',func=pin_types.OUTPUT,unit=1),
            Pin(num='7',name='nFLT',func=pin_types.OUTPUT,unit=1),
            Pin(num='8',name='HO1_LL',func=pin_types.OUTPUT,unit=1),
            Pin(num='9',name='HO2_LL',func=pin_types.OUTPUT,unit=1),
            Pin(num='2',name='NC',func=pin_types.NOCONNECT,unit=1),
            Pin(num='5',name='NC',func=pin_types.NOCONNECT,unit=1),
            Pin(num='21',name='NC',func=pin_types.NOCONNECT,unit=1),
            Pin(num='24',name='NC',func=pin_types.NOCONNECT,unit=1),
            Pin(num='28',name='NC',func=pin_types.NOCONNECT,unit=1),
            Pin(num='33',name='NC',func=pin_types.NOCONNECT,unit=1)], 'unit_defs':[] }),
        Part(**{ 'name':'C_Polarized', 'dest':TEMPLATE, 'tool':SKIDL, 'aliases':Alias({'C_Polarized'}), 'ref_prefix':'C', 'fplist':[''], 'footprint':'Capacitor_SMD:CP_Elec_10x10.5', 'keywords':'cap capacitor', 'description':'Polarized capacitor', 'datasheet':'', 'pins':[
            Pin(num='1',func=pin_types.PASSIVE,unit=1),
            Pin(num='2',func=pin_types.PASSIVE,unit=1)], 'unit_defs':[] }),
        Part(**{ 'name':'L', 'dest':TEMPLATE, 'tool':SKIDL, 'aliases':Alias({'L'}), 'ref_prefix':'L', 'fplist':[''], 'footprint':'Inductor_THT:L_Toroid_Vertical_L24.6mm_W15.5mm_P11.44mm_Pulse_KM-4', 'keywords':'inductor choke coil reactor magnetic', 'description':'Inductor', 'datasheet':'', 'pins':[
            Pin(num='1',name='1',func=pin_types.PASSIVE,unit=1),
            Pin(num='2',name='2',func=pin_types.PASSIVE,unit=1)], 'unit_defs':[] }),
        Part(**{ 'name':'2N7002', 'dest':TEMPLATE, 'tool':SKIDL, 'aliases':Alias({'2N7002'}), 'ref_prefix':'Q', 'fplist':['', 'Package_TO_SOT_SMD:SOT-23'], 'footprint':'Package_TO_SOT_SMD:SOT-23', 'keywords':'N-Channel Switching MOSFET', 'description':'0.115A Id, 60V Vds, N-Channel MOSFET, SOT-23', 'datasheet':'https://www.onsemi.com/pub/Collateral/NDS7002A-D.PDF', 'pins':[
            Pin(num='1',name='G',func=pin_types.INPUT,unit=1),
            Pin(num='2',name='S',func=pin_types.PASSIVE,unit=1),
            Pin(num='3',name='D',func=pin_types.PASSIVE,unit=1)], 'unit_defs':[] }),
        Part(**{ 'name':'SolderJumper_2_Open', 'dest':TEMPLATE, 'tool':SKIDL, 'aliases':Alias({'SolderJumper_2_Open'}), 'ref_prefix':'JP', 'fplist':[''], 'footprint':'Jumper:SolderJumper-2_P1.3mm_Open_Pad1.0x1.5mm', 'keywords':'solder jumper SPST', 'description':'Solder Jumper, 2-pole, open', 'datasheet':'', 'pins':[
            Pin(num='1',name='A',func=pin_types.PASSIVE,unit=1),
            Pin(num='2',name='B',func=pin_types.PASSIVE,unit=1)], 'unit_defs':[] }),
        Part(**{ 'name':'TLV9061xDBV', 'dest':TEMPLATE, 'tool':SKIDL, 'aliases':Alias({'TLV9061xDBV'}), 'ref_prefix':'U', 'fplist':['Package_TO_SOT_SMD:SOT-23-5', 'Package_TO_SOT_SMD:SOT-23-5'], 'footprint':'Package_TO_SOT_SMD:SOT-23-5', 'keywords':'single opamp rail to rail input output', 'description':'10-MHz, RRIO, CMOS Operational Amplifiers for Cost-Sensitive Systems, SOT-23-5', 'datasheet':'https://www.ti.com/lit/ds/symlink/tlv9061.pdf', 'pins':[
            Pin(num='2',name='V-',func=pin_types.PWRIN),
            Pin(num='5',name='V+',func=pin_types.PWRIN),
            Pin(num='1',func=pin_types.OUTPUT,unit=1),
            Pin(num='3',name='+',func=pin_types.INPUT,unit=1),
            Pin(num='4',name='-',func=pin_types.INPUT,unit=1)], 'unit_defs':[] }),
        Part(**{ 'name':'D_Schottky', 'dest':TEMPLATE, 'tool':SKIDL, 'aliases':Alias({'D_Schottky'}), 'ref_prefix':'D', 'fplist':[''], 'footprint':'Diode_SMD:D_SOD-123', 'keywords':'diode Schottky', 'description':'Schottky diode', 'datasheet':'', 'pins':[
            Pin(num='1',name='K',func=pin_types.PASSIVE,unit=1),
            Pin(num='2',name='A',func=pin_types.PASSIVE,unit=1)], 'unit_defs':[] }),
        Part(**{ 'name':'D_Zener', 'dest':TEMPLATE, 'tool':SKIDL, 'aliases':Alias({'D_Zener'}), 'ref_prefix':'D', 'fplist':[''], 'footprint':'Diode_SMD:D_SOD-123', 'keywords':'diode', 'description':'Zener diode', 'datasheet':'', 'pins':[
            Pin(num='1',name='K',func=pin_types.PASSIVE,unit=1),
            Pin(num='2',name='A',func=pin_types.PASSIVE,unit=1)], 'unit_defs':[] }),
        Part(**{ 'name':'LM5069MM-1', 'dest':TEMPLATE, 'tool':SKIDL, 'aliases':Alias({'LM5069MM-1'}), 'ref_prefix':'U', 'fplist':['Package_SO:MSOP-10_3x3mm_P0.5mm'], 'footprint':'Package_SO:MSOP-10_3x3mm_P0.5mm', 'keywords':'high-voltage mosfet-driver efuse', 'description':'Hot swap & Inrush current controller with power limiting, latch off on fault, 9V to 80Vin, UVLO & OVLO, VSSOP-10', 'datasheet':'http://www.ti.com/lit/ds/symlink/lm5069.pdf', 'pins':[
            Pin(num='6',name='TIMER',func=pin_types.INPUT,unit=1),
            Pin(num='1',name='SENSE',func=pin_types.INPUT,unit=1),
            Pin(num='2',name='VIN',func=pin_types.PWRIN,unit=1),
            Pin(num='3',name='UVLO',func=pin_types.INPUT,unit=1),
            Pin(num='4',name='OVLO',func=pin_types.INPUT,unit=1),
            Pin(num='5',name='GND',func=pin_types.PWRIN,unit=1),
            Pin(num='7',name='PWR',func=pin_types.INPUT,unit=1),
            Pin(num='8',name='PGD',func=pin_types.OPENCOLL,unit=1),
            Pin(num='9',name='OUT',func=pin_types.INPUT,unit=1),
            Pin(num='10',name='GATE',func=pin_types.OUTPUT,unit=1)], 'unit_defs':[] }),
        Part(**{ 'name':'PC817', 'dest':TEMPLATE, 'tool':SKIDL, 'aliases':Alias({'PC817'}), 'ref_prefix':'U', 'fplist':['Package_DIP:DIP-4_W7.62mm'], 'footprint':'Package_DIP:SMDIP-4_W9.53mm', 'keywords':'NPN DC Optocoupler', 'description':'DC Optocoupler, Vce 35V, CTR 50-300%, DIP-4', 'datasheet':'http://www.soselectronic.cz/a_info/resource/d/pc817.pdf', 'pins':[
            Pin(num='1',func=pin_types.PASSIVE,unit=1),
            Pin(num='2',func=pin_types.PASSIVE,unit=1),
            Pin(num='3',func=pin_types.PASSIVE,unit=1),
            Pin(num='4',func=pin_types.PASSIVE,unit=1)], 'unit_defs':[] }),
        Part(**{ 'name':'Conn_01x04', 'dest':TEMPLATE, 'tool':SKIDL, 'aliases':Alias({'Conn_01x04'}), 'ref_prefix':'J', 'fplist':[''], 'footprint':'TerminalBlock_Phoenix:TerminalBlock_Phoenix_PT-1,5-4-3.5-H_1x04_P3.50mm_Horizontal', 'keywords':'connector', 'description':'Generic connector, single row, 01x04, script generated (kicad-library-utils/schlib/autogen/connector/)', 'datasheet':'', 'pins':[
            Pin(num='1',name='Pin_1',func=pin_types.PASSIVE,unit=1),
            Pin(num='2',name='Pin_2',func=pin_types.PASSIVE,unit=1),
            Pin(num='3',name='Pin_3',func=pin_types.PASSIVE,unit=1),
            Pin(num='4',name='Pin_4',func=pin_types.PASSIVE,unit=1)], 'unit_defs':[] }),
        Part(**{ 'name':'INA228', 'dest':TEMPLATE, 'tool':SKIDL, 'aliases':Alias({'INA228'}), 'ref_prefix':'U', 'fplist':['Package_SO:TSSOP-10_3x3mm_P0.5mm', 'Package_SO:TSSOP-10_3x3mm_P0.5mm'], 'footprint':'Package_SO:MSOP-10_3x3mm_P0.5mm', 'keywords':'ADC I2C 20-Bit Oversampling Current Shunt', 'description':'High-Side or Low-Side Measurement, Bi-Directional Current and Power Monitor (0-85V) with I2C, SMBus-, and PMBus-Compatible Interface, TSSOP-10 (Texas DGS0010A / VSSOP)', 'datasheet':'https://www.ti.com/lit/ds/symlink/ina228.pdf', 'pins':[
            Pin(num='1',name='A1',func=pin_types.INPUT,unit=1),
            Pin(num='2',name='A0',func=pin_types.INPUT,unit=1),
            Pin(num='3',name='~{Alert}',func=pin_types.OPENCOLL,unit=1),
            Pin(num='4',name='SDA',func=pin_types.BIDIR,unit=1),
            Pin(num='5',name='SCL',func=pin_types.INPUT,unit=1),
            Pin(num='6',name='VS',func=pin_types.PWRIN,unit=1),
            Pin(num='7',name='GND',func=pin_types.PWRIN,unit=1),
            Pin(num='8',name='Vbus',func=pin_types.INPUT,unit=1),
            Pin(num='9',name='Vin-',func=pin_types.INPUT,unit=1),
            Pin(num='10',name='Vin+',func=pin_types.INPUT,unit=1)], 'unit_defs':[] }),
        Part(**{ 'name':'MCP4728', 'dest':TEMPLATE, 'tool':SKIDL, 'aliases':Alias({'MCP4728'}), 'ref_prefix':'U', 'fplist':['Package_SO:MSOP-10_3x3mm_P0.5mm'], 'footprint':'Package_SO:MSOP-10_3x3mm_P0.5mm', 'keywords':'dac i2c', 'description':'12-bit digital to analog converter, quad output, 2.048V internal reference, integrated EEPROM, I2C interface', 'datasheet':'http://ww1.microchip.com/downloads/en/DeviceDoc/22187E.pdf', 'pins':[
            Pin(num='1',name='VDD',func=pin_types.PWRIN,unit=1),
            Pin(num='2',name='SCL',func=pin_types.INPUT,unit=1),
            Pin(num='3',name='SDA',func=pin_types.BIDIR,unit=1),
            Pin(num='4',name='~{LDAC}',func=pin_types.INPUT,unit=1),
            Pin(num='5',name='RDY/~{BSY}',func=pin_types.OUTPUT,unit=1),
            Pin(num='6',name='VOUTA',func=pin_types.OUTPUT,unit=1),
            Pin(num='7',name='VOUTB',func=pin_types.OUTPUT,unit=1),
            Pin(num='8',name='VOUTC',func=pin_types.OUTPUT,unit=1),
            Pin(num='9',name='VOUTD',func=pin_types.OUTPUT,unit=1),
            Pin(num='10',name='VSS',func=pin_types.PWRIN,unit=1)], 'unit_defs':[] }),
        Part(**{ 'name':'Thermistor_NTC', 'dest':TEMPLATE, 'tool':SKIDL, 'aliases':Alias({'Thermistor_NTC'}), 'ref_prefix':'TH', 'fplist':[''], 'footprint':'Resistor_SMD:R_0603_1608Metric', 'keywords':'thermistor NTC resistor sensor RTD', 'description':'Temperature dependent resistor, negative temperature coefficient', 'datasheet':'', 'pins':[
            Pin(num='1',func=pin_types.PASSIVE,unit=1),
            Pin(num='2',func=pin_types.PASSIVE,unit=1)], 'unit_defs':[] }),
        Part(**{ 'name':'Conn_01x02', 'dest':TEMPLATE, 'tool':SKIDL, 'aliases':Alias({'Conn_01x02'}), 'ref_prefix':'J', 'fplist':[''], 'footprint':'Connector_PinHeader_2.54mm:PinHeader_1x02_P2.54mm_Vertical', 'keywords':'connector', 'description':'Generic connector, single row, 01x02, script generated (kicad-library-utils/schlib/autogen/connector/)', 'datasheet':'', 'pins':[
            Pin(num='1',name='Pin_1',func=pin_types.PASSIVE,unit=1),
            Pin(num='2',name='Pin_2',func=pin_types.PASSIVE,unit=1)], 'unit_defs':[] }),
        Part(**{ 'name':'TPS54360DDA', 'dest':TEMPLATE, 'tool':SKIDL, 'aliases':Alias({'TPS54360DDA'}), 'ref_prefix':'U', 'fplist':['Package_SO:TI_SO-PowerPAD-8_ThermalVias'], 'footprint':'Package_SO:HSOP-8-1EP_3.9x4.9mm_P1.27mm_EP2.41x3.1mm', 'keywords':'Step-Down DC-DC Switching Regulator High Voltage High Frequency', 'description':'3.5A, Step Down DC-DC Converter with Eco-mode, 4.5-60V Input Voltage, PowerSO-8', 'datasheet':'http://www.ti.com/lit/ds/symlink/tps54360.pdf', 'pins':[
            Pin(num='1',name='BOOT',func=pin_types.INPUT,unit=1),
            Pin(num='2',name='VIN',func=pin_types.PWRIN,unit=1),
            Pin(num='3',name='EN',func=pin_types.INPUT,unit=1),
            Pin(num='4',name='RT/CLK',func=pin_types.INPUT,unit=1),
            Pin(num='5',name='FB',func=pin_types.INPUT,unit=1),
            Pin(num='6',name='COMP',func=pin_types.PASSIVE,unit=1),
            Pin(num='7',name='GND',func=pin_types.PWRIN,unit=1),
            Pin(num='8',name='SW',func=pin_types.OUTPUT,unit=1),
            Pin(num='9',name='GNDPAD',func=pin_types.PWRIN,unit=1)], 'unit_defs':[] }),
        Part(**{ 'name':'FerriteBead', 'dest':TEMPLATE, 'tool':SKIDL, 'aliases':Alias({'FerriteBead'}), 'ref_prefix':'FB', 'fplist':[''], 'footprint':'Inductor_SMD:L_1206_3216Metric', 'keywords':'L ferrite bead inductor filter', 'description':'Ferrite bead', 'datasheet':'', 'pins':[
            Pin(num='1',func=pin_types.PASSIVE,unit=1),
            Pin(num='2',func=pin_types.PASSIVE,unit=1)], 'unit_defs':[] }),
        Part(**{ 'name':'AP63205WU', 'dest':TEMPLATE, 'tool':SKIDL, 'aliases':Alias({'AP63205WU'}), 'ref_prefix':'U', 'fplist':['Package_TO_SOT_SMD:TSOT-23-6', 'Package_TO_SOT_SMD:TSOT-23-6'], 'footprint':'Package_TO_SOT_SMD:TSOT-23-6', 'keywords':'2A Buck DC/DC', 'description':'2A, 1.1MHz Buck DC/DC Converter, fixed 5.0V output voltage, TSOT-23-6', 'datasheet':'https://www.diodes.com/assets/Datasheets/AP63200-AP63201-AP63203-AP63205.pdf', 'pins':[
            Pin(num='1',name='FB',func=pin_types.INPUT,unit=1),
            Pin(num='2',name='EN',func=pin_types.INPUT,unit=1),
            Pin(num='3',name='IN',func=pin_types.PWRIN,unit=1),
            Pin(num='4',name='GND',func=pin_types.PWRIN,unit=1),
            Pin(num='5',name='SW',func=pin_types.OUTPUT,unit=1),
            Pin(num='6',name='BST',func=pin_types.PASSIVE,unit=1)], 'unit_defs':[] }),
        Part(**{ 'name':'AP63203WU', 'dest':TEMPLATE, 'tool':SKIDL, 'aliases':Alias({'AP63203WU'}), 'ref_prefix':'U', 'fplist':['Package_TO_SOT_SMD:TSOT-23-6', 'Package_TO_SOT_SMD:TSOT-23-6'], 'footprint':'Package_TO_SOT_SMD:TSOT-23-6', 'keywords':'2A Buck DC/DC', 'description':'2A, 1.1MHz Buck DC/DC Converter, fixed 3.3V output voltage, TSOT-23-6', 'datasheet':'https://www.diodes.com/assets/Datasheets/AP63200-AP63201-AP63203-AP63205.pdf', 'pins':[
            Pin(num='1',name='FB',func=pin_types.INPUT,unit=1),
            Pin(num='2',name='EN',func=pin_types.INPUT,unit=1),
            Pin(num='3',name='IN',func=pin_types.PWRIN,unit=1),
            Pin(num='4',name='GND',func=pin_types.PWRIN,unit=1),
            Pin(num='5',name='SW',func=pin_types.OUTPUT,unit=1),
            Pin(num='6',name='BST',func=pin_types.PASSIVE,unit=1)], 'unit_defs':[] }),
        Part(**{ 'name':'STM32H743ZITx', 'dest':TEMPLATE, 'tool':SKIDL, 'aliases':Alias({'STM32H743ZITx'}), 'ref_prefix':'U', 'fplist':['Package_QFP:LQFP-144_20x20mm_P0.5mm'], 'footprint':'Package_QFP:LQFP-144_20x20mm_P0.5mm', 'keywords':'Arm Cortex-M7 STM32H7 STM32H743/753', 'description':'STMicroelectronics Arm Cortex-M7 MCU, 2048KB flash, 1024KB RAM, 480 MHz, 1.62-3.6V, 114 GPIO, LQFP144', 'datasheet':'https://www.st.com/resource/en/datasheet/stm32h743zi.pdf', 'pins':[
            Pin(num='1',name='PE2',func=pin_types.BIDIR,unit=1),
            Pin(num='2',name='PE3',func=pin_types.BIDIR,unit=1),
            Pin(num='3',name='PE4',func=pin_types.BIDIR,unit=1),
            Pin(num='4',name='PE5',func=pin_types.BIDIR,unit=1),
            Pin(num='5',name='PE6',func=pin_types.BIDIR,unit=1),
            Pin(num='6',name='VBAT',func=pin_types.PWRIN,unit=1),
            Pin(num='7',name='PC13',func=pin_types.BIDIR,unit=1),
            Pin(num='8',name='PC14',func=pin_types.BIDIR,unit=1),
            Pin(num='9',name='PC15',func=pin_types.BIDIR,unit=1),
            Pin(num='10',name='PF0',func=pin_types.BIDIR,unit=1),
            Pin(num='11',name='PF1',func=pin_types.BIDIR,unit=1),
            Pin(num='12',name='PF2',func=pin_types.BIDIR,unit=1),
            Pin(num='13',name='PF3',func=pin_types.BIDIR,unit=1),
            Pin(num='14',name='PF4',func=pin_types.BIDIR,unit=1),
            Pin(num='15',name='PF5',func=pin_types.BIDIR,unit=1),
            Pin(num='16',name='VSS',func=pin_types.PWRIN,unit=1),
            Pin(num='17',name='VDD',func=pin_types.PWRIN,unit=1),
            Pin(num='18',name='PF6',func=pin_types.BIDIR,unit=1),
            Pin(num='19',name='PF7',func=pin_types.BIDIR,unit=1),
            Pin(num='20',name='PF8',func=pin_types.BIDIR,unit=1),
            Pin(num='21',name='PF9',func=pin_types.BIDIR,unit=1),
            Pin(num='22',name='PF10',func=pin_types.BIDIR,unit=1),
            Pin(num='23',name='PH0',func=pin_types.BIDIR,unit=1),
            Pin(num='24',name='PH1',func=pin_types.BIDIR,unit=1),
            Pin(num='25',name='NRST',func=pin_types.INPUT,unit=1),
            Pin(num='26',name='PC0',func=pin_types.BIDIR,unit=1),
            Pin(num='27',name='PC1',func=pin_types.BIDIR,unit=1),
            Pin(num='28',name='PC2_C',func=pin_types.BIDIR,unit=1),
            Pin(num='29',name='PC3_C',func=pin_types.BIDIR,unit=1),
            Pin(num='30',name='VDD',func=pin_types.PWRIN,unit=1),
            Pin(num='31',name='VSSA',func=pin_types.PWRIN,unit=1),
            Pin(num='32',name='VREF+',func=pin_types.INPUT,unit=1),
            Pin(num='33',name='VDDA',func=pin_types.PWRIN,unit=1),
            Pin(num='34',name='PA0',func=pin_types.BIDIR,unit=1),
            Pin(num='35',name='PA1',func=pin_types.BIDIR,unit=1),
            Pin(num='36',name='PA2',func=pin_types.BIDIR,unit=1),
            Pin(num='37',name='PA3',func=pin_types.BIDIR,unit=1),
            Pin(num='38',name='VSS',func=pin_types.PASSIVE,unit=1),
            Pin(num='39',name='VDD',func=pin_types.PWRIN,unit=1),
            Pin(num='40',name='PA4',func=pin_types.BIDIR,unit=1),
            Pin(num='41',name='PA5',func=pin_types.BIDIR,unit=1),
            Pin(num='42',name='PA6',func=pin_types.BIDIR,unit=1),
            Pin(num='43',name='PA7',func=pin_types.BIDIR,unit=1),
            Pin(num='44',name='PC4',func=pin_types.BIDIR,unit=1),
            Pin(num='45',name='PC5',func=pin_types.BIDIR,unit=1),
            Pin(num='46',name='PB0',func=pin_types.BIDIR,unit=1),
            Pin(num='47',name='PB1',func=pin_types.BIDIR,unit=1),
            Pin(num='48',name='PB2',func=pin_types.BIDIR,unit=1),
            Pin(num='49',name='PF11',func=pin_types.BIDIR,unit=1),
            Pin(num='50',name='PF12',func=pin_types.BIDIR,unit=1),
            Pin(num='51',name='VSS',func=pin_types.PASSIVE,unit=1),
            Pin(num='52',name='VDD',func=pin_types.PWRIN,unit=1),
            Pin(num='53',name='PF13',func=pin_types.BIDIR,unit=1),
            Pin(num='54',name='PF14',func=pin_types.BIDIR,unit=1),
            Pin(num='55',name='PF15',func=pin_types.BIDIR,unit=1),
            Pin(num='56',name='PG0',func=pin_types.BIDIR,unit=1),
            Pin(num='57',name='PG1',func=pin_types.BIDIR,unit=1),
            Pin(num='58',name='PE7',func=pin_types.BIDIR,unit=1),
            Pin(num='59',name='PE8',func=pin_types.BIDIR,unit=1),
            Pin(num='60',name='PE9',func=pin_types.BIDIR,unit=1),
            Pin(num='61',name='VSS',func=pin_types.PASSIVE,unit=1),
            Pin(num='62',name='VDD',func=pin_types.PWRIN,unit=1),
            Pin(num='63',name='PE10',func=pin_types.BIDIR,unit=1),
            Pin(num='64',name='PE11',func=pin_types.BIDIR,unit=1),
            Pin(num='65',name='PE12',func=pin_types.BIDIR,unit=1),
            Pin(num='66',name='PE13',func=pin_types.BIDIR,unit=1),
            Pin(num='67',name='PE14',func=pin_types.BIDIR,unit=1),
            Pin(num='68',name='PE15',func=pin_types.BIDIR,unit=1),
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
            Pin(num='131',name='VDD',func=pin_types.PWRIN,unit=1),
            Pin(num='132',name='PG15',func=pin_types.BIDIR,unit=1),
            Pin(num='133',name='PB3',func=pin_types.BIDIR,unit=1),
            Pin(num='134',name='PB4',func=pin_types.BIDIR,unit=1),
            Pin(num='135',name='PB5',func=pin_types.BIDIR,unit=1),
            Pin(num='136',name='PB6',func=pin_types.BIDIR,unit=1),
            Pin(num='137',name='PB7',func=pin_types.BIDIR,unit=1),
            Pin(num='138',name='BOOT0',func=pin_types.INPUT,unit=1),
            Pin(num='139',name='PB8',func=pin_types.BIDIR,unit=1),
            Pin(num='140',name='PB9',func=pin_types.BIDIR,unit=1),
            Pin(num='141',name='PE0',func=pin_types.BIDIR,unit=1),
            Pin(num='142',name='PE1',func=pin_types.BIDIR,unit=1),
            Pin(num='143',name='PDR_ON',func=pin_types.INPUT,unit=1),
            Pin(num='144',name='VDD',func=pin_types.PWRIN,unit=1)], 'unit_defs':[] }),
        Part(**{ 'name':'SW_Push', 'dest':TEMPLATE, 'tool':SKIDL, 'aliases':Alias({'SW_Push'}), 'ref_prefix':'SW', 'fplist':[''], 'footprint':'Button_Switch_SMD:SW_SPST_PTS645Sx43SMTR92', 'keywords':'switch normally-open pushbutton push-button', 'description':'Push button switch, generic, two pins', 'datasheet':'', 'pins':[
            Pin(num='1',name='1',func=pin_types.PASSIVE),
            Pin(num='2',name='2',func=pin_types.PASSIVE)], 'unit_defs':[] }),
        Part(**{ 'name':'Crystal_GND24', 'dest':TEMPLATE, 'tool':SKIDL, 'aliases':Alias({'Crystal_GND24'}), 'ref_prefix':'Y', 'fplist':[''], 'footprint':'Crystal:Crystal_SMD_3225-4Pin_3.2x2.5mm', 'keywords':'quartz ceramic resonator oscillator', 'description':'Four pin crystal, GND on pins 2 and 4', 'datasheet':'', 'pins':[
            Pin(num='1',name='1',func=pin_types.PASSIVE,unit=1),
            Pin(num='2',name='G',func=pin_types.PASSIVE,unit=1),
            Pin(num='3',name='3',func=pin_types.PASSIVE,unit=1),
            Pin(num='4',name='G',func=pin_types.PASSIVE,unit=1)], 'unit_defs':[] }),
        Part(**{ 'name':'Crystal', 'dest':TEMPLATE, 'tool':SKIDL, 'aliases':Alias({'Crystal'}), 'ref_prefix':'Y', 'fplist':[''], 'footprint':'Crystal:Crystal_SMD_3215-2Pin_3.2x1.5mm', 'keywords':'quartz ceramic resonator oscillator', 'description':'Two pin crystal', 'datasheet':'', 'pins':[
            Pin(num='1',name='1',func=pin_types.PASSIVE,unit=1),
            Pin(num='2',name='2',func=pin_types.PASSIVE,unit=1)], 'unit_defs':[] }),
        Part(**{ 'name':'Conn_02x05_Odd_Even', 'dest':TEMPLATE, 'tool':SKIDL, 'aliases':Alias({'Conn_02x05_Odd_Even'}), 'ref_prefix':'J', 'fplist':[''], 'footprint':'Connector_PinHeader_1.27mm:PinHeader_2x05_P1.27mm_Vertical', 'keywords':'connector', 'description':'Generic connector, double row, 02x05, odd/even pin numbering scheme (row 1 odd numbers, row 2 even numbers), script generated (kicad-library-utils/schlib/autogen/connector/)', 'datasheet':'', 'pins':[
            Pin(num='1',name='Pin_1',func=pin_types.PASSIVE,unit=1),
            Pin(num='2',name='Pin_2',func=pin_types.PASSIVE,unit=1),
            Pin(num='3',name='Pin_3',func=pin_types.PASSIVE,unit=1),
            Pin(num='4',name='Pin_4',func=pin_types.PASSIVE,unit=1),
            Pin(num='5',name='Pin_5',func=pin_types.PASSIVE,unit=1),
            Pin(num='6',name='Pin_6',func=pin_types.PASSIVE,unit=1),
            Pin(num='7',name='Pin_7',func=pin_types.PASSIVE,unit=1),
            Pin(num='8',name='Pin_8',func=pin_types.PASSIVE,unit=1),
            Pin(num='9',name='Pin_9',func=pin_types.PASSIVE,unit=1),
            Pin(num='10',name='Pin_10',func=pin_types.PASSIVE,unit=1)], 'unit_defs':[] }),
        Part(**{ 'name':'W25Q128JVS', 'dest':TEMPLATE, 'tool':SKIDL, 'aliases':Alias({'W25Q128JVS'}), 'ref_prefix':'U', 'fplist':['Package_SO:SOIC-8_5.3x5.3mm_P1.27mm', 'Package_SO:SOIC-8_5.3x5.3mm_P1.27mm'], 'footprint':'Package_SO:SOIC-8_5.3x5.3mm_P1.27mm', 'keywords':'flash memory SPI QPI DTR', 'description':'128Mbit / 16MiB Serial Flash Memory, Standard/Dual/Quad SPI, 2.7-3.6V, SOIC-8', 'datasheet':'https://www.winbond.com/resource-files/w25q128jv_dtr%20revc%2003272018%20plus.pdf', 'pins':[
            Pin(num='1',name='~{CS}',func=pin_types.INPUT,unit=1),
            Pin(num='2',name='DO/IO_{1}',func=pin_types.BIDIR,unit=1),
            Pin(num='3',name='~{WP}/IO_{2}',func=pin_types.BIDIR,unit=1),
            Pin(num='4',name='GND',func=pin_types.PWRIN,unit=1),
            Pin(num='5',name='DI/IO_{0}',func=pin_types.BIDIR,unit=1),
            Pin(num='6',name='CLK',func=pin_types.INPUT,unit=1),
            Pin(num='7',name='~{HOLD}/~{RESET}/IO_{3}',func=pin_types.BIDIR,unit=1),
            Pin(num='8',name='VCC',func=pin_types.PWRIN,unit=1)], 'unit_defs':[] }),
        Part(**{ 'name':'LAN8720A', 'dest':TEMPLATE, 'tool':SKIDL, 'aliases':Alias({'LAN8720A'}), 'ref_prefix':'U', 'fplist':['Package_DFN_QFN:VQFN-24-1EP_4x4mm_P0.5mm_EP2.5x2.5mm_ThermalVias'], 'footprint':'Package_DFN_QFN:QFN-24-1EP_4x4mm_P0.5mm_EP2.6x2.6mm', 'keywords':'ETH PHY RMII', 'description':'LAN8720 Ethernet PHY with RMII interface, QFN-24', 'datasheet':'http://ww1.microchip.com/downloads/en/DeviceDoc/8720a.pdf', 'pins':[
            Pin(num='1',name='VDD2A',func=pin_types.PWRIN,unit=1),
            Pin(num='2',name='LED2/~{INTSEL}',func=pin_types.BIDIR,unit=1),
            Pin(num='3',name='LED1/REGOFF',func=pin_types.BIDIR,unit=1),
            Pin(num='4',name='XTAL2',func=pin_types.OUTPUT,unit=1),
            Pin(num='5',name='XTAL1/CLKIN',func=pin_types.INPUT,unit=1),
            Pin(num='6',name='VDDCR',func=pin_types.PWRIN,unit=1),
            Pin(num='7',name='RXD1/MODE1',func=pin_types.BIDIR,unit=1),
            Pin(num='8',name='RXD0/MODE0',func=pin_types.BIDIR,unit=1),
            Pin(num='9',name='VDDIO',func=pin_types.PWRIN,unit=1),
            Pin(num='10',name='RXER/PHYAD0',func=pin_types.OUTPUT,unit=1),
            Pin(num='11',name='CRS_DV/MODE2',func=pin_types.BIDIR,unit=1),
            Pin(num='12',name='MDIO',func=pin_types.BIDIR,unit=1),
            Pin(num='13',name='MDC',func=pin_types.INPUT,unit=1),
            Pin(num='14',name='~{INT}/REFCLKO',func=pin_types.OUTPUT,unit=1),
            Pin(num='15',name='~{RST}',func=pin_types.INPUT,unit=1),
            Pin(num='16',name='TXEN',func=pin_types.INPUT,unit=1),
            Pin(num='17',name='TXD0',func=pin_types.INPUT,unit=1),
            Pin(num='18',name='TXD1',func=pin_types.INPUT,unit=1),
            Pin(num='19',name='VDD1A',func=pin_types.PWRIN,unit=1),
            Pin(num='20',name='TXN',func=pin_types.BIDIR,unit=1),
            Pin(num='21',name='TXP',func=pin_types.BIDIR,unit=1),
            Pin(num='22',name='RXN',func=pin_types.BIDIR,unit=1),
            Pin(num='23',name='RXP',func=pin_types.BIDIR,unit=1),
            Pin(num='24',name='RBIAS',func=pin_types.PASSIVE,unit=1),
            Pin(num='25',name='VSS',func=pin_types.PWRIN,unit=1)], 'unit_defs':[] }),
        Part(**{ 'name':'RJ45_Hanrun_HR911105A_Horizontal', 'dest':TEMPLATE, 'tool':SKIDL, 'aliases':Alias({'RJ45_Hanrun_HR911105A_Horizontal'}), 'ref_prefix':'J', 'fplist':['Connector_RJ:RJ45_Hanrun_HR911105A_Horizontal'], 'footprint':'Connector_RJ:RJ45_Hanrun_HR911105A_Horizontal', 'keywords':'RJ45 Magjack Socket', 'description':'1 Port RJ45 Magjack Connector Through Hole 10/100 Base-T, AutoMDIX', 'datasheet':'https://datasheet.lcsc.com/lcsc/1811141815_HANRUN-Zhongshan-HanRun-Elec-HR911105A_C12074.pdf', 'pins':[
            Pin(num='1',name='TD+',func=pin_types.PASSIVE,unit=1),
            Pin(num='2',name='TD-',func=pin_types.PASSIVE,unit=1),
            Pin(num='3',name='RD+',func=pin_types.PASSIVE,unit=1),
            Pin(num='4',name='TCT',func=pin_types.PASSIVE,unit=1),
            Pin(num='5',name='RCT',func=pin_types.PASSIVE,unit=1),
            Pin(num='6',name='RD-',func=pin_types.PASSIVE,unit=1),
            Pin(num='7',name='NC',func=pin_types.NOCONNECT,unit=1),
            Pin(num='8',func=pin_types.PWRIN,unit=1),
            Pin(num='9',func=pin_types.PASSIVE,unit=1),
            Pin(num='10',func=pin_types.PASSIVE,unit=1),
            Pin(num='11',func=pin_types.PASSIVE,unit=1),
            Pin(num='12',func=pin_types.PASSIVE,unit=1),
            Pin(num='SH',func=pin_types.PASSIVE,unit=1)], 'unit_defs':[] }),
        Part(**{ 'name':'CA-IS3062VW', 'dest':TEMPLATE, 'tool':SKIDL, 'aliases':Alias({'CA-IS3062VW'}), 'ref_prefix':'U', 'fplist':['Package_SO:SOIC-16W_7.5x10.3mm_P1.27mm'], 'footprint':'Package_SO:SOIC-16W_7.5x10.3mm_P1.27mm', 'keywords':'', 'description':'Chipanalog isolated CAN transceiver with integrated 5 V DC-DC, SOIC16-WB, separate VCCL logic supply (datasheet v1.04 table 6-1)', 'datasheet':'', 'pins':[
            Pin(num='1',name='VCC',func=pin_types.PWRIN,unit=1),
            Pin(num='7',name='VCCL',func=pin_types.PWRIN,unit=1),
            Pin(num='2',name='GND1',func=pin_types.PWRIN,unit=1),
            Pin(num='8',name='GND1',func=pin_types.PWRIN,unit=1),
            Pin(num='3',name='TXD',func=pin_types.INPUT,unit=1),
            Pin(num='5',name='RXD',func=pin_types.OUTPUT,unit=1),
            Pin(num='4',name='NC',func=pin_types.NOCONNECT,unit=1),
            Pin(num='6',name='NC',func=pin_types.NOCONNECT,unit=1),
            Pin(num='14',name='NC',func=pin_types.NOCONNECT,unit=1),
            Pin(num='11',name='VISO',func=pin_types.PASSIVE,unit=1),
            Pin(num='16',name='VISO',func=pin_types.PASSIVE,unit=1),
            Pin(num='13',name='CANH',func=pin_types.BIDIR,unit=1),
            Pin(num='12',name='CANL',func=pin_types.BIDIR,unit=1),
            Pin(num='9',name='GND2',func=pin_types.PWRIN,unit=1),
            Pin(num='10',name='GND2',func=pin_types.PWRIN,unit=1),
            Pin(num='15',name='GND2',func=pin_types.PWRIN,unit=1)], 'unit_defs':[] }),
        Part(**{ 'name':'SM712_SOT23', 'dest':TEMPLATE, 'tool':SKIDL, 'aliases':Alias({'SM712_SOT23'}), 'ref_prefix':'D', 'fplist':['Package_TO_SOT_SMD:SOT-23'], 'footprint':'Package_TO_SOT_SMD:SOT-23', 'keywords':'transient voltage suppressor thyrector transil', 'description':'7V/12V, 600W Asymmetrical TVS Diode Array, SOT-23', 'datasheet':'https://www.littelfuse.com/~/media/electronics/datasheets/tvs_diode_arrays/littelfuse_tvs_diode_array_sm712_datasheet.pdf.pdf', 'pins':[
            Pin(num='1',name='A1',func=pin_types.PASSIVE,unit=1),
            Pin(num='2',name='A2',func=pin_types.PASSIVE,unit=1),
            Pin(num='3',name='common',func=pin_types.INPUT,unit=1)], 'unit_defs':[] }),
        Part(**{ 'name':'Conn_01x03', 'dest':TEMPLATE, 'tool':SKIDL, 'aliases':Alias({'Conn_01x03'}), 'ref_prefix':'J', 'fplist':[''], 'footprint':'TerminalBlock_Phoenix:TerminalBlock_Phoenix_PT-1,5-3-3.5-H_1x03_P3.50mm_Horizontal', 'keywords':'connector', 'description':'Generic connector, single row, 01x03, script generated (kicad-library-utils/schlib/autogen/connector/)', 'datasheet':'', 'pins':[
            Pin(num='1',name='Pin_1',func=pin_types.PASSIVE,unit=1),
            Pin(num='2',name='Pin_2',func=pin_types.PASSIVE,unit=1),
            Pin(num='3',name='Pin_3',func=pin_types.PASSIVE,unit=1)], 'unit_defs':[] }),
        Part(**{ 'name':'CA-IS3092W', 'dest':TEMPLATE, 'tool':SKIDL, 'aliases':Alias({'CA-IS3092W'}), 'ref_prefix':'U', 'fplist':['Package_SO:SOIC-16W_7.5x10.3mm_P1.27mm'], 'footprint':'Package_SO:SOIC-16W_7.5x10.3mm_P1.27mm', 'keywords':'', 'description':'Isolated half-duplex RS-485 transceiver with integrated DC-DC, 5kVrms, 3.3V/5V, SOIC-16W', 'datasheet':'https://www.lcsc.com/product-detail/C2890051.html', 'pins':[
            Pin(num='1',name='VCC',func=pin_types.PWRIN,unit=1),
            Pin(num='2',name='GNDA',func=pin_types.PWRIN,unit=1),
            Pin(num='3',name='RO',func=pin_types.OUTPUT,unit=1),
            Pin(num='4',name='~{RE}',func=pin_types.INPUT,unit=1),
            Pin(num='5',name='DE',func=pin_types.INPUT,unit=1),
            Pin(num='6',name='DI',func=pin_types.INPUT,unit=1),
            Pin(num='7',name='NC',func=pin_types.NOCONNECT,unit=1),
            Pin(num='8',name='GNDA',func=pin_types.PWRIN,unit=1),
            Pin(num='16',name='VISO',func=pin_types.PWROUT,unit=1),
            Pin(num='15',name='GNDB',func=pin_types.PWRIN,unit=1),
            Pin(num='14',name='NC',func=pin_types.NOCONNECT,unit=1),
            Pin(num='13',name='B',func=pin_types.BIDIR,unit=1),
            Pin(num='12',name='A',func=pin_types.BIDIR,unit=1),
            Pin(num='11',name='NC',func=pin_types.NOCONNECT,unit=1),
            Pin(num='10',name='SEL',func=pin_types.INPUT,unit=1),
            Pin(num='9',name='GNDB',func=pin_types.PWRIN,unit=1)], 'unit_defs':[] }),
        Part(**{ 'name':'USB_C_Receptacle_USB2.0_16P', 'dest':TEMPLATE, 'tool':SKIDL, 'aliases':Alias({'USB_C_Receptacle_USB2.0_16P'}), 'ref_prefix':'J', 'fplist':[''], 'footprint':'Connector_USB:USB_C_Receptacle_HRO_TYPE-C-31-M-12', 'keywords':'usb universal serial bus type-C USB2.0', 'description':'USB 2.0-only 16P Type-C Receptacle connector', 'datasheet':'https://www.usb.org/sites/default/files/documents/usb_type-c.zip', 'pins':[
            Pin(num='A1',name='GND',func=pin_types.PASSIVE,unit=1),
            Pin(num='A4',name='VBUS',func=pin_types.PASSIVE,unit=1),
            Pin(num='A5',name='CC1',func=pin_types.BIDIR,unit=1),
            Pin(num='A6',name='D+',func=pin_types.BIDIR,unit=1),
            Pin(num='A7',name='D-',func=pin_types.BIDIR,unit=1),
            Pin(num='A8',name='SBU1',func=pin_types.BIDIR,unit=1),
            Pin(num='A9',name='VBUS',func=pin_types.PASSIVE,unit=1),
            Pin(num='A12',name='GND',func=pin_types.PASSIVE,unit=1),
            Pin(num='B1',name='GND',func=pin_types.PASSIVE,unit=1),
            Pin(num='B4',name='VBUS',func=pin_types.PASSIVE,unit=1),
            Pin(num='B5',name='CC2',func=pin_types.BIDIR,unit=1),
            Pin(num='B6',name='D+',func=pin_types.BIDIR,unit=1),
            Pin(num='B7',name='D-',func=pin_types.BIDIR,unit=1),
            Pin(num='B8',name='SBU2',func=pin_types.BIDIR,unit=1),
            Pin(num='B9',name='VBUS',func=pin_types.PASSIVE,unit=1),
            Pin(num='B12',name='GND',func=pin_types.PASSIVE,unit=1),
            Pin(num='SH',name='SHIELD',func=pin_types.PASSIVE,unit=1)], 'unit_defs':[] }),
        Part(**{ 'name':'USBLC6-2SC6', 'dest':TEMPLATE, 'tool':SKIDL, 'aliases':Alias({'USBLC6-2SC6'}), 'ref_prefix':'U', 'fplist':['Package_TO_SOT_SMD:SOT-666', 'Package_TO_SOT_SMD:SOT-23-6'], 'footprint':'Package_TO_SOT_SMD:SOT-23-6', 'keywords':'usb ethernet video', 'description':'Very low capacitance ESD protection diode, 2 data-line, SOT-23-6', 'datasheet':'https://www.st.com/resource/en/datasheet/usblc6-2.pdf', 'pins':[
            Pin(num='1',name='I/O1',func=pin_types.PASSIVE,unit=1),
            Pin(num='2',name='GND',func=pin_types.PASSIVE,unit=1),
            Pin(num='3',name='I/O2',func=pin_types.PASSIVE,unit=1),
            Pin(num='4',name='I/O2',func=pin_types.PASSIVE,unit=1),
            Pin(num='5',name='VBUS',func=pin_types.PASSIVE,unit=1),
            Pin(num='6',name='I/O1',func=pin_types.PASSIVE,unit=1)], 'unit_defs':[] }),
        Part(**{ 'name':'Polyfuse', 'dest':TEMPLATE, 'tool':SKIDL, 'aliases':Alias({'Polyfuse'}), 'ref_prefix':'F', 'fplist':[''], 'footprint':'Fuse:Fuse_1206_3216Metric', 'keywords':'resettable fuse PTC PPTC polyfuse polyswitch', 'description':'Resettable fuse, polymeric positive temperature coefficient', 'datasheet':'', 'pins':[
            Pin(num='1',func=pin_types.PASSIVE,unit=1),
            Pin(num='2',func=pin_types.PASSIVE,unit=1)], 'unit_defs':[] }),
        Part(**{ 'name':'Conn_01x40', 'dest':TEMPLATE, 'tool':SKIDL, 'aliases':Alias({'Conn_01x40'}), 'ref_prefix':'J', 'fplist':[''], 'footprint':'Connector_FFC-FPC:Hirose_FH12-40S-0.5SH_1x40-1MP_P0.50mm_Horizontal', 'keywords':'connector', 'description':'Generic connector, single row, 01x40, script generated (kicad-library-utils/schlib/autogen/connector/)', 'datasheet':'', 'pins':[
            Pin(num='1',name='Pin_1',func=pin_types.PASSIVE,unit=1),
            Pin(num='2',name='Pin_2',func=pin_types.PASSIVE,unit=1),
            Pin(num='3',name='Pin_3',func=pin_types.PASSIVE,unit=1),
            Pin(num='4',name='Pin_4',func=pin_types.PASSIVE,unit=1),
            Pin(num='5',name='Pin_5',func=pin_types.PASSIVE,unit=1),
            Pin(num='6',name='Pin_6',func=pin_types.PASSIVE,unit=1),
            Pin(num='7',name='Pin_7',func=pin_types.PASSIVE,unit=1),
            Pin(num='8',name='Pin_8',func=pin_types.PASSIVE,unit=1),
            Pin(num='9',name='Pin_9',func=pin_types.PASSIVE,unit=1),
            Pin(num='10',name='Pin_10',func=pin_types.PASSIVE,unit=1),
            Pin(num='11',name='Pin_11',func=pin_types.PASSIVE,unit=1),
            Pin(num='12',name='Pin_12',func=pin_types.PASSIVE,unit=1),
            Pin(num='13',name='Pin_13',func=pin_types.PASSIVE,unit=1),
            Pin(num='14',name='Pin_14',func=pin_types.PASSIVE,unit=1),
            Pin(num='15',name='Pin_15',func=pin_types.PASSIVE,unit=1),
            Pin(num='16',name='Pin_16',func=pin_types.PASSIVE,unit=1),
            Pin(num='17',name='Pin_17',func=pin_types.PASSIVE,unit=1),
            Pin(num='18',name='Pin_18',func=pin_types.PASSIVE,unit=1),
            Pin(num='19',name='Pin_19',func=pin_types.PASSIVE,unit=1),
            Pin(num='20',name='Pin_20',func=pin_types.PASSIVE,unit=1),
            Pin(num='21',name='Pin_21',func=pin_types.PASSIVE,unit=1),
            Pin(num='22',name='Pin_22',func=pin_types.PASSIVE,unit=1),
            Pin(num='23',name='Pin_23',func=pin_types.PASSIVE,unit=1),
            Pin(num='24',name='Pin_24',func=pin_types.PASSIVE,unit=1),
            Pin(num='25',name='Pin_25',func=pin_types.PASSIVE,unit=1),
            Pin(num='26',name='Pin_26',func=pin_types.PASSIVE,unit=1),
            Pin(num='27',name='Pin_27',func=pin_types.PASSIVE,unit=1),
            Pin(num='28',name='Pin_28',func=pin_types.PASSIVE,unit=1),
            Pin(num='29',name='Pin_29',func=pin_types.PASSIVE,unit=1),
            Pin(num='30',name='Pin_30',func=pin_types.PASSIVE,unit=1),
            Pin(num='31',name='Pin_31',func=pin_types.PASSIVE,unit=1),
            Pin(num='32',name='Pin_32',func=pin_types.PASSIVE,unit=1),
            Pin(num='33',name='Pin_33',func=pin_types.PASSIVE,unit=1),
            Pin(num='34',name='Pin_34',func=pin_types.PASSIVE,unit=1),
            Pin(num='35',name='Pin_35',func=pin_types.PASSIVE,unit=1),
            Pin(num='36',name='Pin_36',func=pin_types.PASSIVE,unit=1),
            Pin(num='37',name='Pin_37',func=pin_types.PASSIVE,unit=1),
            Pin(num='38',name='Pin_38',func=pin_types.PASSIVE,unit=1),
            Pin(num='39',name='Pin_39',func=pin_types.PASSIVE,unit=1),
            Pin(num='40',name='Pin_40',func=pin_types.PASSIVE,unit=1)], 'unit_defs':[] }),
        Part(**{ 'name':'XPT2046TS', 'dest':TEMPLATE, 'tool':SKIDL, 'aliases':Alias({'XPT2046TS'}), 'ref_prefix':'U', 'fplist':['Package_SO:TSSOP-16_4.4x5mm_P0.65mm'], 'footprint':'Package_SO:TSSOP-16_4.4x5mm_P0.65mm', 'keywords':'Single-supply, 12bit, 4 ch, touch screen driver, 2.2 - 5.25 VDD, -40 to +85 C, QSPI, SPI, 3-wire serial interface, TSSOP-16', 'description':'Single-supply, 12bit, 4 ch, touch screen driver, 2.2 - 5.25 VDD, -40 to +85 C, QSPI, SPI, 3-wire serial interface, TSSOP-16', 'datasheet':'http://www.xptek.cn/uploadfile/download/201707171401161883.pdf', 'pins':[
            Pin(num='1',name='VCC',func=pin_types.PWRIN,unit=1),
            Pin(num='2',name='XP',func=pin_types.INPUT,unit=1),
            Pin(num='3',name='YP',func=pin_types.INPUT,unit=1),
            Pin(num='4',name='XN',func=pin_types.INPUT,unit=1),
            Pin(num='5',name='YN',func=pin_types.INPUT,unit=1),
            Pin(num='6',name='GND',func=pin_types.PWRIN,unit=1),
            Pin(num='7',name='VBAT',func=pin_types.PWRIN,unit=1),
            Pin(num='8',name='IN',func=pin_types.INPUT,unit=1),
            Pin(num='9',name='VREF',func=pin_types.BIDIR,unit=1),
            Pin(num='10',name='IOVDD',func=pin_types.PWRIN,unit=1),
            Pin(num='11',name='~{PENIRQ}',func=pin_types.OPENCOLL,unit=1),
            Pin(num='12',name='DOUT',func=pin_types.OUTPUT,unit=1),
            Pin(num='13',name='BUSY',func=pin_types.OUTPUT,unit=1),
            Pin(num='14',name='DIN',func=pin_types.INPUT,unit=1),
            Pin(num='15',name='~{CS}',func=pin_types.INPUT,unit=1),
            Pin(num='16',name='DCLK',func=pin_types.INPUT,unit=1)], 'unit_defs':[] }),
        Part(**{ 'name':'MT3608', 'dest':TEMPLATE, 'tool':SKIDL, 'aliases':Alias({'MT3608'}), 'ref_prefix':'U', 'fplist':['Package_TO_SOT_SMD:SOT-23-6'], 'footprint':'Package_TO_SOT_SMD:SOT-23-6', 'keywords':'Step-Up Boost DC-DC Regulator Adjustable', 'description':'High Efficiency 1.2MHz 2A Step Up Converter, 2-24V Vin, 28V Vout, 4A current limit, 1.2MHz, SOT23-6', 'datasheet':'https://www.olimex.com/Products/Breadboarding/BB-PWR-3608/resources/MT3608.pdf', 'pins':[
            Pin(num='1',name='SW',func=pin_types.PASSIVE,unit=1),
            Pin(num='2',name='GND',func=pin_types.PWRIN,unit=1),
            Pin(num='3',name='FB',func=pin_types.INPUT,unit=1),
            Pin(num='4',name='EN',func=pin_types.INPUT,unit=1),
            Pin(num='5',name='IN',func=pin_types.PWRIN,unit=1),
            Pin(num='6',name='NC',func=pin_types.NOCONNECT,unit=1)], 'unit_defs':[] }),
        Part(**{ 'name':'Conn_01x08', 'dest':TEMPLATE, 'tool':SKIDL, 'aliases':Alias({'Conn_01x08'}), 'ref_prefix':'J', 'fplist':[''], 'footprint':'Connector_PinHeader_2.54mm:PinHeader_1x08_P2.54mm_Vertical', 'keywords':'connector', 'description':'Generic connector, single row, 01x08, script generated (kicad-library-utils/schlib/autogen/connector/)', 'datasheet':'', 'pins':[
            Pin(num='1',name='Pin_1',func=pin_types.PASSIVE,unit=1),
            Pin(num='2',name='Pin_2',func=pin_types.PASSIVE,unit=1),
            Pin(num='3',name='Pin_3',func=pin_types.PASSIVE,unit=1),
            Pin(num='4',name='Pin_4',func=pin_types.PASSIVE,unit=1),
            Pin(num='5',name='Pin_5',func=pin_types.PASSIVE,unit=1),
            Pin(num='6',name='Pin_6',func=pin_types.PASSIVE,unit=1),
            Pin(num='7',name='Pin_7',func=pin_types.PASSIVE,unit=1),
            Pin(num='8',name='Pin_8',func=pin_types.PASSIVE,unit=1)], 'unit_defs':[] }),
        Part(**{ 'name':'LED', 'dest':TEMPLATE, 'tool':SKIDL, 'aliases':Alias({'LED'}), 'ref_prefix':'D', 'fplist':[''], 'footprint':'LED_SMD:LED_0603_1608Metric', 'keywords':'LED diode', 'description':'Light emitting diode', 'datasheet':'', 'pins':[
            Pin(num='1',name='K',func=pin_types.PASSIVE,unit=1),
            Pin(num='2',name='A',func=pin_types.PASSIVE,unit=1)], 'unit_defs':[] })])
