mtilocca/mppt-controller/(commit log)

2026-11-07 Initial requirements and architecture for STM32H7 MPPT controller
2026-11-07 Add STM32H743 pin allocator, SKiDL generator, custom symbols, ERC-clean schematic
    - pinmap.py: bipartite matching of 81 signals to LQFP-144 pins using ST open pin data
    - mppt_controller.py: LM5177 4-switch buck-boost stage, MPPT COMP loop, PV ideal diode,
    battery reverse protection, LM5069 load/inverter switches, 5x INA228, 9V/5V/3V3 aux,
    W25Q128, LAN8720A+RJ45, isolated CAN (CA-IS3062VW) and RS485 (CA-IS3092W), USB-C, UART, display, LEDs
    - KiCad ERC: 0 violations (335 components, 285 nets)
    [mppt_controller.kicad_sch, mppt_controller_aux_power.kicad_sch, mppt_controller_battery.kicad_sch, mppt_controller_can.kicad_sch, mppt_controller_display.kicad_sch, mppt_controller_ethernet.kicad_sch, mppt_controller_flash.kicad_sch, mppt_controller_inverter_feed.kicad_sch]
2026-11-07 USB power path, 4.3in RGB display with XPT2046 touch and MT3608 backlight
    [mppt_controller_aux_power.kicad_sch, mppt_controller_can.kicad_sch, mppt_controller_display.kicad_sch, mppt_controller_ethernet.kicad_sch, mppt_controller_flash.kicad_sch, mppt_controller_leds.kicad_sch, mppt_controller_mcu.kicad_sch, mppt_controller_rs485.kicad_sch]
2026-11-07 PCB: 175x120 mm 4-layer board, placement script with isolation zones, setup script (net classes, GND planes, keep-outs)
    [mppt_controller.kicad_pcb]
2026-11-07 Routing scripts: custom power router, Freerouting helpers, post-route pours
2026-11-07 Import Freerouting result, merge power tracks, GND pours, placeholder 3D models
    [mppt_controller.kicad_pcb]
2026-11-08 195x128 board, re-placement, Freerouting signals, pours, 3D models
    [_after_power.kicad_pcb, _before_rest.kicad_pcb, _before_ses.kicad_pcb, _r1.kicad_pcb, _route.dsn, _route2.dsn, _routed_175.kicad_pcb, _rp_test.kicad_pcb]
2026-11-08 GND via fixer, DRC state: 141 unconnected
    [J8_HR911105A.step, mppt_controller.kicad_pcb]
2026-11-08 Terminal flip scripts, handover doc
    [_before_flip.kicad_pcb, mppt_controller.kicad_pcb]
2026-11-10 Re-route connector nets after terminal flip; docs images
    [_snap_docs.kicad_pcb, mppt_controller.kicad_pcb]
2026-11-10 0 DRC violations, 133 unconnected; post_route fix; handover update
    [_prev.kicad_pcb, hr_real.obj, hr_real.step, mppt_controller.kicad_pcb]
2026-11-10 Add PCB editor and 3D viewer screenshots to README/overview
